pulsarfab/pulsarfab/README.md

# PulsarFab

Open-source astronomy hardware platform — dew heater controllers, power distribution and USB hubs, mount accessories, and other observatory gear based on STM32 and ESP32-S3 microcontrollers.

## Projects

| Project | Description | MCU | Flash/RAM | Framework | Status |
|---|---|-----|---|---|---|
| **pulsardew** | USB dew heater controller | STM32G0B1KBU6 | 128KB/144KB | STM32 HAL + FreeRTOS | 🚧 In Development |
| **[PulsarPower](hardware/pulsardewhub/README.md)** | Power distribution, two dew heaters and four-port USB 2.0 hub | STM32G0B1KBU6 | 128KB/144KB | Firmware adaptation pending | 🚧 Connected schematic / unrouted floorplan |
| **pulsardewpro** | WiFi dew heater controller (ASCOM Alpaca) | ESP32-S3-MINI-1 | 8MB/512KB | ESP-IDF | 🚧 In Development |
| **crunchdefender** | Skywatcher mount limit guard — inline USB host/device that interrupts motion before the OTA collides with the pier or cables crunch | STM32F405RGT6 | 1024KB/192KB | STM32 HAL | 🌱 Bootstrapped |

## Repository Structure

```
pulsarfab/
├── firmware/                 # All firmware projects (C/C++, Apache 2.0)
│   ├── pulsardew/             # STM32G0B1 USB dew heater controller
│   ├── pulsardewpro/          # ESP32-S3 WiFi dew heater (ASCOM Alpaca)
│   ├── crunchdefender/        # STM32F405 mount limit guard (dual-USB)
│   ├── common/                # Shared STM32 HAL and utilities
│   └── shared/                # Shared protocol definitions and libraries
├── hardware/                 # PCB designs (CERN-OHL-S v2 + NC)
│   ├── pulsardew/            # USB dew heater PCB
│   ├── pulsardewhub/         # PulsarPower power / dew / USB hub PCB
│   ├── pulsardewpro/         # WiFi dew heater PCB
│   ├── crunchdefender/       # Mount limit guard PCB
│   └── lib/                  # Shared KiCad libraries
├── mechanical/               # 3D models (coming soon, CERN-OHL-S v2 + NC)
└── LICENSE                   # Dual licensing information
```

## Quick Start

### Prerequisites

**For STM32 builds (pulsardew):**
- ARM GCC toolchain: `arm-none-eabi-gcc`
- CMake 3.20 or newer
- Make or Ninja build tool

**For ESP32-S3 builds (pulsardewpro):**
- ESP-IDF v5.x
- Python 3.10+
- uv (Python package manager)

See [firmware/README.md](firmware/README.md) for detailed installation instructions.

### Build Projects

```bash
# STM32 USB dew heater
cd firmware
make pulsardew-g0b1              # Build pulsardew (STM32G0B1)
make flash-pulsardew-g0b1        # Flash via st-flash

# STM32 mount limit guard
cd firmware
make crunchdefender-f405         # Build crunchdefender (STM32F405)
make flash-crunchdefender-f405   # Flash via st-flash

# ESP32-S3 WiFi dew heater
cd firmware/pulsardewpro
idf.py build                     # Build with ESP-IDF
idf.py flash                     # Flash via USB
```

## Key Features

### Dew Heater Control
- PWM-controlled heater outputs for telescope optics
- Temperature and humidity sensing (SHT40)
- Ambient dew point calculation with automatic heater regulation
- Configurable temperature setpoints per channel

### PulsarDew (USB)
- 4 PWM heater channels with current sensing
- Temperature/humidity sensor (SHT40 via I2C)
- USB 2.0 FS device (CDC for serial control from PC)
- Dew point calculation and automatic regulation
- Compact STM32G0B1 design with FreeRTOS

### PulsarDewPro (WiFi / ASCOM Alpaca)
- 4 PWM heater channels with individual current sensing
- Multiple temperature/humidity sensors
- WiFi 802.11 b/g/n connectivity
- ASCOM Alpaca REST API (ObservingConditions + Switch devices)
- Web configuration UI
- OTA firmware updates
- ESP32-S3 with ESP-IDF

### PulsarPower (Power / Dew / USB)
- Four independently switched, current-monitored DC outlets, **5 A service target each**
- Positive-side DC switching with grounded returns; static on/off, no PWM on DC outlets
- Two PWM dew heater channels
- Four external USB 2.0 ports, **500 mA per port**, plus an internal connection to the controller
- **12–18 V nominal input**, with alternative XT60 or barrel assembly options
- **25 A shared XT60 continuous target**; barrel option has a **3.5 A provisional continuous budget**
- **5 V / 3 A regulator** shared by USB and onboard electronics; not 3 A per USB port

PulsarDew remains the original dedicated dew controller. **PulsarPower** is the
expanded product, previously called **PulsarDew Hub** during development. Its
KiCad files and Makefile targets currently retain the `pulsardewhub` identifier.
The 0.3 draft has a connected schematic and an unrouted four-layer floorplan;
current ratings require routing and prototype qualification, and firmware
adaptation is pending. Cost reductions retain outlet current monitoring: TPS25974L
switches, one shared voltage window and two owned SiR680LDP input FETs. See the [PulsarPower design README](hardware/pulsardewhub/README.md)
for the power budget, schematic, floorplan and remaining release work.

PulsarPower and PulsarDew now share stocked XKB barrel sockets and HRO USB-C sockets;
SHT40 R2 is retained. The shared procurement CSV allocates 110 owned XKB sockets.
U30 now uses 22 allocated owned LMR51610s for the 20-board batch plus spares.
See the [LMR51610 implementation notes](hardware/pulsardewhub/docs/lmr51610-commonality.md)
for the 3.3 V / 650 mA logic stage; the 5 V / 3 A USB supply remains.

## Hardware

### PulsarDew (STM32G0B1KBU6)
- 128KB Flash, 144KB RAM
- ARM Cortex-M0+ @ 64MHz
- UFQFPN-32 package
- USB 2.0 FS (HSI48 + CRS, no external crystal)
- FreeRTOS real-time control

### PulsarDewPro (ESP32-S3-MINI-1)
- 8MB Flash, 512KB SRAM
- Dual-core Xtensa LX7 @ 240MHz
- WiFi 802.11 b/g/n
- USB-OTG for programming
- ASCOM Alpaca server

### CrunchDefender (STM32F405RGT6)
- 1024KB Flash, 192KB RAM (128KB SRAM + 64KB CCM)
- ARM Cortex-M4F @ 168MHz with single-precision FPU
- LQFP-64 package
- **Two USB peripherals running concurrently** — OTG_FS as device (PA11/PA12) to the host PC, OTG_HS-in-FS-mode as host (PB14/PB15) to the Skywatcher hand controller
- Sits inline on the USB link, parses position telemetry, intercepts motion commands when limits are exceeded

## License

This project uses dual licensing:

- **Firmware/Software**: [Apache 2.0](firmware/LICENSE)
- **Hardware Designs**: CERN-OHL-S v2 (strongly reciprocal) + Non-Commercial restriction

See [LICENSE](LICENSE) for details.

## Contributing

Contributions are welcome! Please ensure:
- Firmware contributions follow the Apache 2.0 license
- Hardware contributions follow CERN-OHL-S v2 + NC
- Code follows the existing style
- All changes are tested

## Resources

### Hardware
- [STM32G0 Series](https://www.st.com/en/microcontrollers-microprocessors/stm32g0-series.html)
- [ESP-IDF Documentation](https://docs.espressif.com/projects/esp-idf/)
- [ASCOM Alpaca](https://ascom-standards.org/Developer/Alpaca.htm)

### Licenses
- [Apache 2.0 License](https://www.apache.org/licenses/LICENSE-2.0)
- [CERN-OHL-S v2](https://ohwr.org/cern_ohl_s_v2.txt)

### Tools
- [uv Python Package Manager](https://github.com/astral-sh/uv)

---

Copyright (c) 2025-2026 Yann Ramin
