pulsarfab/pulsarfab/hardware/pulsardewhub/docs/pcb-placement.png

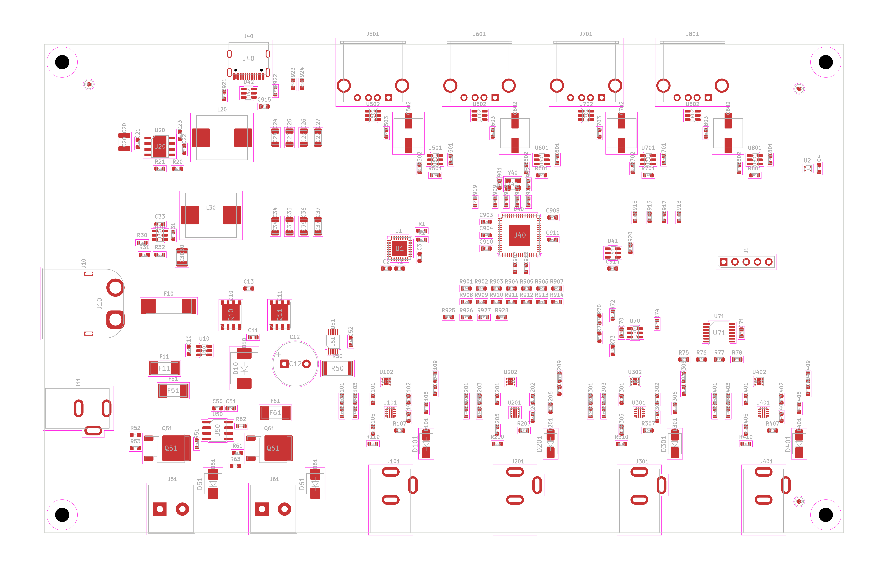
hardware/pulsardewhub/docs/pcb-placement.png
