pulsarfab/pulsarfab/hardware/pulsardewhub/docs/system-interconnect.png

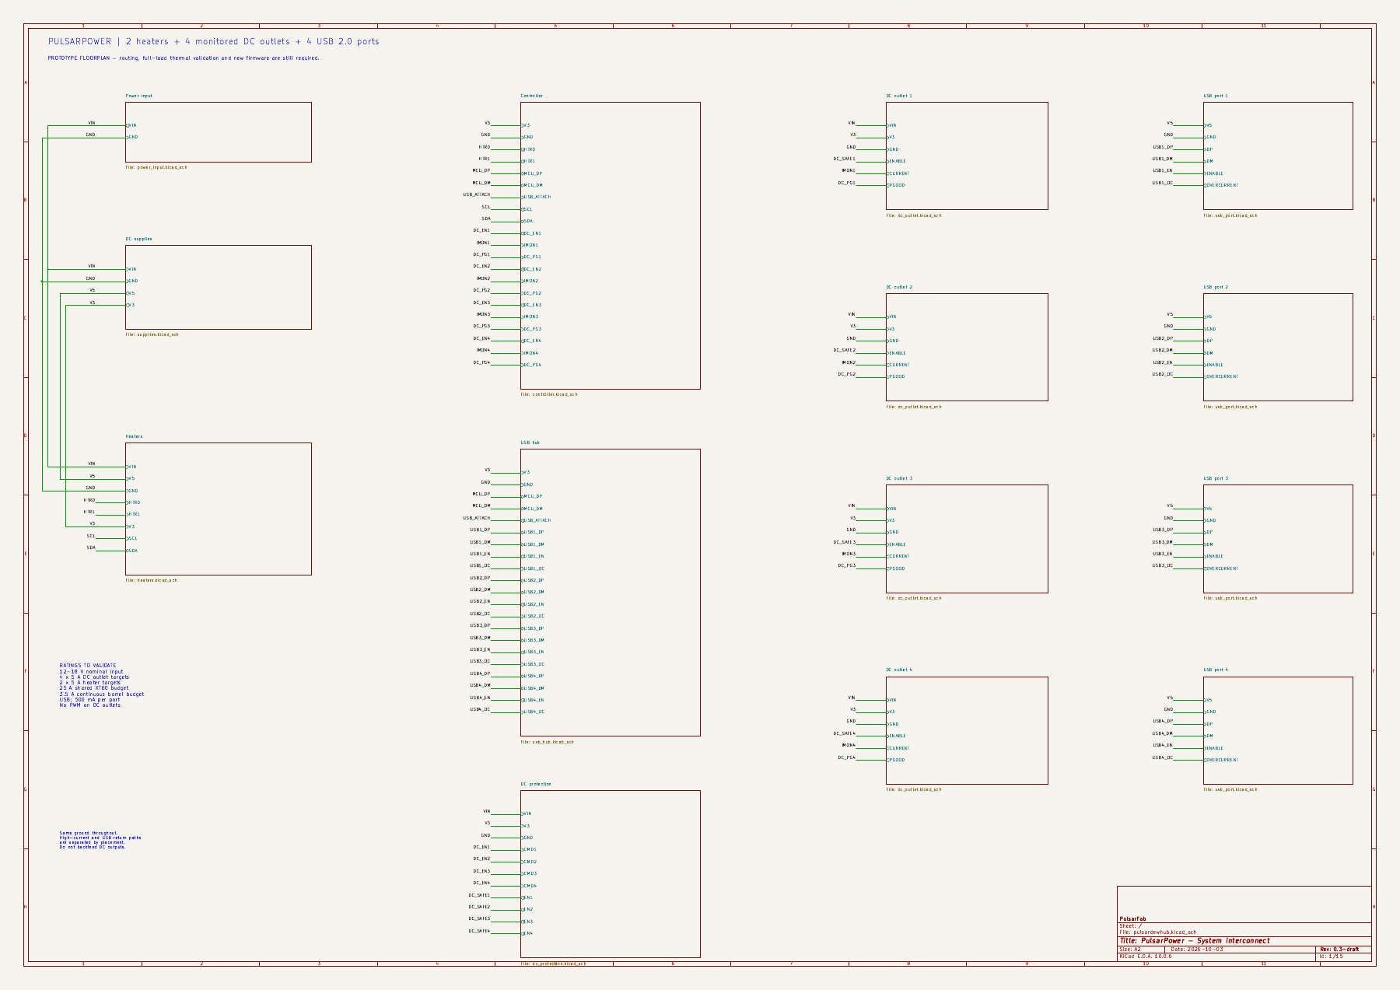
hardware/pulsardewhub/docs/system-interconnect.png
