pulsarfab/pulsarfab/hardware/pulsardewhub/jlcpcb_bom.csv

Item | Designator | Comment | Footprint | Qty | LCSC Part # | MPN | Manufacturer
1 | C1,C3,C4,C23,C33,C50,C52,C70,C71,C501,C503,C601,C603,C701,C703,C801,C803,C903-C909,C914,C915 | 100n | Capacitor_SMD:C_0603_1608Metric | 26 | C14663 | CC0603KRX7R9BB104 | YAGEO
2 | C2 | 4.7u / 16V | Capacitor_SMD:C_0603_1608Metric | 1 | C19666 | CL10A475KO8NNNC | Samsung Electro-Mechanics
3 | C10,C22,C51,C910-C913 | 1u / 50V | Capacitor_SMD:C_0603_1608Metric | 7 | C15849 | CL10A105KB8NNNC | Samsung Electro-Mechanics
4 | C11,C13,C31,C101,C102,C201,C202,C301,C302,C401,C402 | 100n / 50V | Capacitor_SMD:C_0603_1608Metric | 11 | C14663 | CC0603KRX7R9BB104 | YAGEO
5 | C12 | 470u / 35V | Capacitor_THT:CP_Radial_D10.0mm_P5.00mm | 1 | C106703 | ERS1VM471G16OT | AISHI
6 | C20,C30 | 10u / 50V | Capacitor_SMD:C_1210_3225Metric | 2 | C138687 | CL32B106KBJNNNE | Samsung Electro-Mechanics
7 | C21 | 220n / 50V | Capacitor_SMD:C_0603_1608Metric | 1 | C64705 | CL10B224KB8NNNC | Samsung Electro-Mechanics
8 | C24-C27,C34-C37 | 22u / 25V | Capacitor_SMD:C_1206_3216Metric | 8 | C12891 | CL31A226KAHNNNE | Samsung Electro-Mechanics
9 | C103,C203,C303,C403 | 4.7n / 50V | Capacitor_SMD:C_0603_1608Metric | 4 | C1621 | CL10B472KB8NNNC | Samsung Electro-Mechanics
10 | C104,C204,C304,C404 | 10n | Capacitor_SMD:C_0603_1608Metric | 4 | C1589 | CL10B103KB8NNNC | Samsung Electro-Mechanics
11 | C502,C602,C702,C802 | 150u / 10V / 20% | pulsarfab:CP_RVT_D6.3mm_L5.4mm | 4 | C970688 | RVT1A151M0605 150UF 10V | DMBJ
12 | C901,C902 | 18p / C0G | Capacitor_SMD:C_0603_1608Metric | 2 | C342890 | CGA3E2C0G1H180JT0Y0N | TDK
13 | D10 | SMCJ18A | Diode_SMD:D_SMC | 1 | C438102 | SMCJ18A | Jingdao Microelectronics
14 | D51,D61 | SMBJ20A | Diode_SMD:D_SMB | 2 | C364296 | SMBJ20A | MDD(Microdiode Semiconductor)
15 | D101,D201,D301,D401 | SS54 | Diode_SMD:D_SMA | 4 | C22452 | SS54 | MDD(Microdiode Semiconductor)
16 | F10 | 30A / upstream budget | pulsarfab:Fuse_S1032_10.3x3.2mm | 1 | C553917 | S1032-F-30.0A | SART
17 | F51,F61 | 7A heater fuse | Fuse:Fuse_Littelfuse-NANO2-451_453 | 2 | C99548 | 0451007.MRL | Littelfuse
18 | J1 | SWD | Connector_PinHeader_2.54mm:PinHeader_1x05_P2.54mm_Vertical | 1 | C492404 | PZ254V-11-05P | XFCN
19 | J10 | XT60: 2=PLUS, 1=GND | pulsarfab:AMASS_XT60PW-M_Edge | 1 | C98732 | XT60PW-M | Changzhou Amass Elec
20 | J40 | USB-C upstream | pulsarfab:USB_C_HRO_TYPE-C-31-M-12 | 1 | C165948 | TYPE-C-31-M-12 | Korean Hroparts Elec
21 | J51 | HEATER 1 | pulsarfab:TerminalBlock_KEFA_KF128_2P_P5.08mm | 1 | C474952 | KF128-5.08-2P-AA | Cixi Kefa Elec
22 | J61 | HEATER 2 | pulsarfab:TerminalBlock_KEFA_KF128_2P_P5.08mm | 1 | C474952 | KF128-5.08-2P-AA | Cixi Kefa Elec
23 | J101,J201,J301,J401 | 5A DC / center + | pulsarfab:BarrelJack_XKB_DC-005K-5A_Edge | 4 | C2880546 | DC-005K-5A-2.0 | XKB Connection
24 | J501,J601,J701,J801 | USB-A / 500mA | pulsarfab:USB_A_SHOUHAN_AF90ZJWG_THT | 4 | C456019 | AF 90 ZJWG | SHOU HAN
25 | L20 | 8.2u / 10A sat | pulsarfab:L_SXN_SMMS1050 | 1 | C149543 | SMMS1050-8R2M | Shun Xiang Nuo
26 | L30 | 6.8u / 12A sat | pulsarfab:L_SXN_SMMS1050 | 1 | C149542 | SMMS1050-6R8M | Shun Xiang Nuo
27 | Q10,Q11 | SiR680LDP | Package_SO:PowerPAK_SO-8_Single | 2 | C3279524 | SIR680LDP-T1-RE3 | Vishay
28 | Q51,Q61 | AOD4184A | Package_TO_SOT_SMD:TO-252-2 | 2 | C5370959 | AOD4184A | TECH PUBLIC
29 | R1,R2 | 4.7k | Resistor_SMD:R_0603_1608Metric | 2 | C23162 | 0603WAF4701T5E | UNI-ROYAL
30 | R20,R30,R53,R63,R101,R201,R301,R401,R502,R602,R702,R802,R923,R924 | 100k | Resistor_SMD:R_0603_1608Metric | 14 | C25803 | 0603WAF1003T5E | UNI-ROYAL
31 | R21 | 24.9k | Resistor_SMD:R_0603_1608Metric | 1 | C25962 | 0603WAF2492T5E | UNI-ROYAL
32 | R31,R102,R202,R302,R402 | 20k | Resistor_SMD:R_0603_1608Metric | 5 | C4184 | 0603WAF2002T5E | UNI-ROYAL
33 | R32 | 12k | Resistor_SMD:R_0603_1608Metric | 1 | C22790 | 0603WAF1202T5E | UNI-ROYAL
34 | R50 | 2m / 3W / 1% | Resistor_SMD:R_2512_6332Metric | 1 | C2994640 | HoLLR2512-3W-2mR-1% | Milliohm
35 | R51,R61,R71,R73-R78,R104-R106,R109,R204-R206,R209,R304-R306,R309,R404-R406,R409,R901-R918,R920,R925-R928 | 10k | Resistor_SMD:R_0603_1608Metric | 48 | C25804 | 0603WAF1002T5E | UNI-ROYAL
36 | R52,R62 | 47 | Resistor_SMD:R_0603_1608Metric | 2 | C23182 | 0603WAF470JT5E | UNI-ROYAL
37 | R70 | 220k | Resistor_SMD:R_0603_1608Metric | 1 | C22961 | 0603WAF2203T5E | UNI-ROYAL
38 | R72 | 470k | Resistor_SMD:R_0603_1608Metric | 1 | C23178 | 0603WAF4703T5E | UNI-ROYAL
39 | R103,R203,R303,R403 | 150k | Resistor_SMD:R_0603_1608Metric | 4 | C22807 | 0603WAF1503T5E | UNI-ROYAL
40 | R107,R207,R307,R407 | 1k / 1% | Resistor_SMD:R_0603_1608Metric | 4 | C21190 | 0603WAF1001T5E | UNI-ROYAL
41 | R110,R210,R310,R410 | 1k | Resistor_SMD:R_0603_1608Metric | 4 | C21190 | 0603WAF1001T5E | UNI-ROYAL
42 | R501,R601,R701,R801 | 43.2k / 1% | Resistor_SMD:R_0603_1608Metric | 4 | C23053 | 0603WAF4322T5E | UNI-ROYAL
43 | R919 | 12k / 1% | Resistor_SMD:R_0603_1608Metric | 1 | C22790 | 0603WAF1202T5E | UNI-ROYAL
44 | R921,R922 | 5.1k | Resistor_SMD:R_0603_1608Metric | 2 | C23186 | 0603WAF5101T5E | UNI-ROYAL
45 | U1 | STM32G0B1KBU6 | Package_DFN_QFN:UFQFPN-32-1EP_5x5mm_P0.5mm_EP3.5x3.5mm | 1 | C5159549 | STM32G0B1KBU6 | ST
46 | U2 | SHT40-AD1B-R2 | Sensor_Humidity:Sensirion_DFN-4_1.5x1.5mm_P0.8mm_SHT4x_NoCentralPad | 1 | C2909890 | SHT40-AD1B-R2 | Sensirion
47 | U10 | LM74700QDBV | Package_TO_SOT_SMD:SOT-23-6 | 1 | C2941042 | LM74700QDBVRQ1 | TI
48 | U20 | LMR33630ADDA | Package_SO:Texas_HSOP-8-1EP_3.9x4.9mm_P1.27mm | 1 | C841384 | LMR33630ADDAR | TI
49 | U30 | LMR51610XDBVR | Package_TO_SOT_SMD:SOT-23-6 | 1 | C20539658 | LMR51610XDBVR | Texas Instruments
50 | U40 | USB2517-JZX | Package_DFN_QFN:QFN-64-1EP_9x9mm_P0.5mm_EP4.7x4.7mm | 1 | C1521556 | USB2517-JZX | MICROCHIP
51 | U41 | TPS3808G33DBV | Package_TO_SOT_SMD:SOT-23-6 | 1 | C43698 | TPS3808G33DBVR | TI
52 | U42,U502,U602,U702,U802 | USBLC6-2SC6 | Package_TO_SOT_SMD:SOT-23-6 | 5 | C7519 | USBLC6-2SC6 | ST
53 | U50 | TC4427AVOA713 | Package_SO:SOIC-8_3.9x4.9mm_P1.27mm | 1 | C624944 | TC4427AVOA713 | MICROCHIP
54 | U51 | INA226 | Package_SO:TSSOP-10_3x3mm_P0.5mm | 1 | C49851 | INA226AIDGSR | Texas Instruments
55 | U70 | TPS3700DDC | Package_TO_SOT_SMD:SOT-23-6 | 1 | C33002 | TPS3700DDCR | TI
56 | U71 | SN74LVC08APW | Package_SO:TSSOP-14_4.4x5mm_P0.65mm | 1 | C465737 | SN74LVC08APWR | Texas Instruments
57 | U101,U201,U301,U401 | TPS25974LRPW | pulsarfab:TI_RPW0010A_VQFN10_2x2mm | 4 | C3662931 | TPS25974LRPWR | Texas Instruments
58 | U102,U202,U302,U402 | TVS1800DRV | Package_SON:WSON-6-1EP_2x2mm_P0.65mm_EP1x1.6mm | 4 | C2649846 | TVS1800DRVR | Texas Instruments
59 | U501,U601,U701,U801 | TPS2553DBV | Package_TO_SOT_SMD:SOT-23-6 | 4 | C55266 | TPS2553DBVR | TI
60 | Y40 | 24MHz / CL=12pF | Crystal:Crystal_SMD_3225-4Pin_3.2x2.5mm | 1 | C5181479 | 3225 24M 12PF 10PPM | SOSET
