pulsarfab/pulsarfab/hardware/pulsardewhub/docs/schematic.pdf

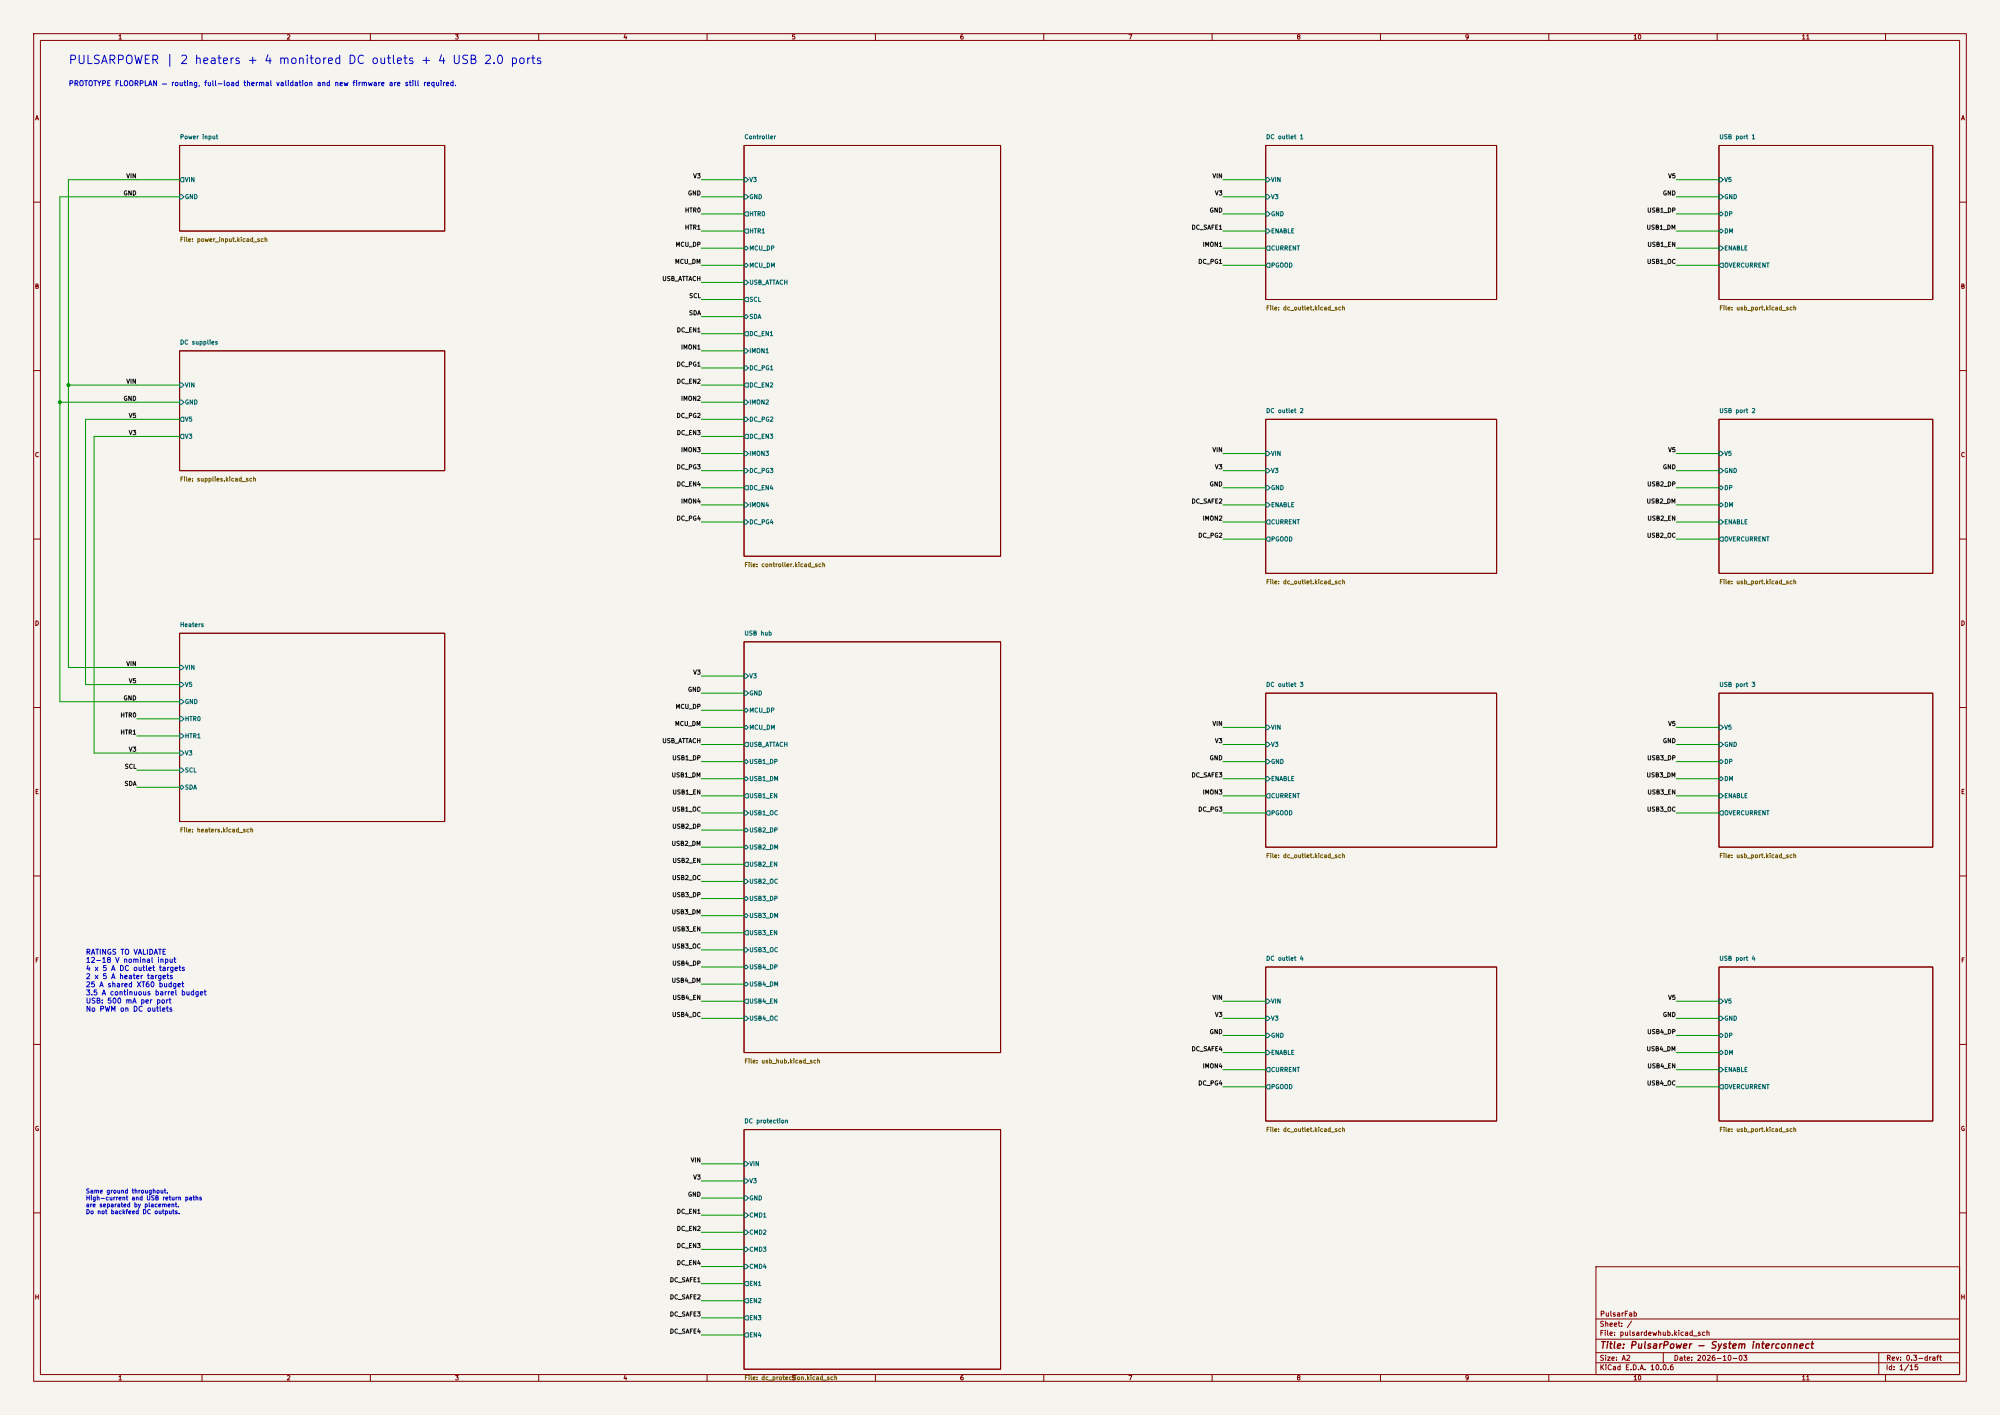
[picture p4: page 1]

PULSARPOWER | 2 heaters + 4 monitored DC outlets + 4 USB 2.0 ports

PROTOTYPE FLOORPLAN — routing, full-load thermal validation and new firmware are still required.

ENABLE OVERCURRENT USB port 1

V3 DC supplies File: supplies.kicad_sch

ENABLE OVERCURRENT USB port 2

SCL SDA Heaters File: heaters.kicad_sch
GND RATINGS TO VALIDATE

ENABLE OVERCURRENT USB port 3

12-18 V nominal input
4 x 5 A DC outlet targets
2 x 5 A heater targets
25 A shared XT60 budget
3.5 A continuous barrel budget
USB: 500 mA per port
No PWM on DC outlets

ENABLE OVERCURRENT USB port 4

Same ground throughout.
High-current and USB return paths are separated by placement. Do not backfeed DC outputs.

PulsarFab
Sheet: /
File: pulsardewhub.kicad_sch
Title: PulsarPower - System interconnect

Size: A2 | Rev: 0.3-draft
KiCad E.D.A. 10.0.6 | Id: 1/15

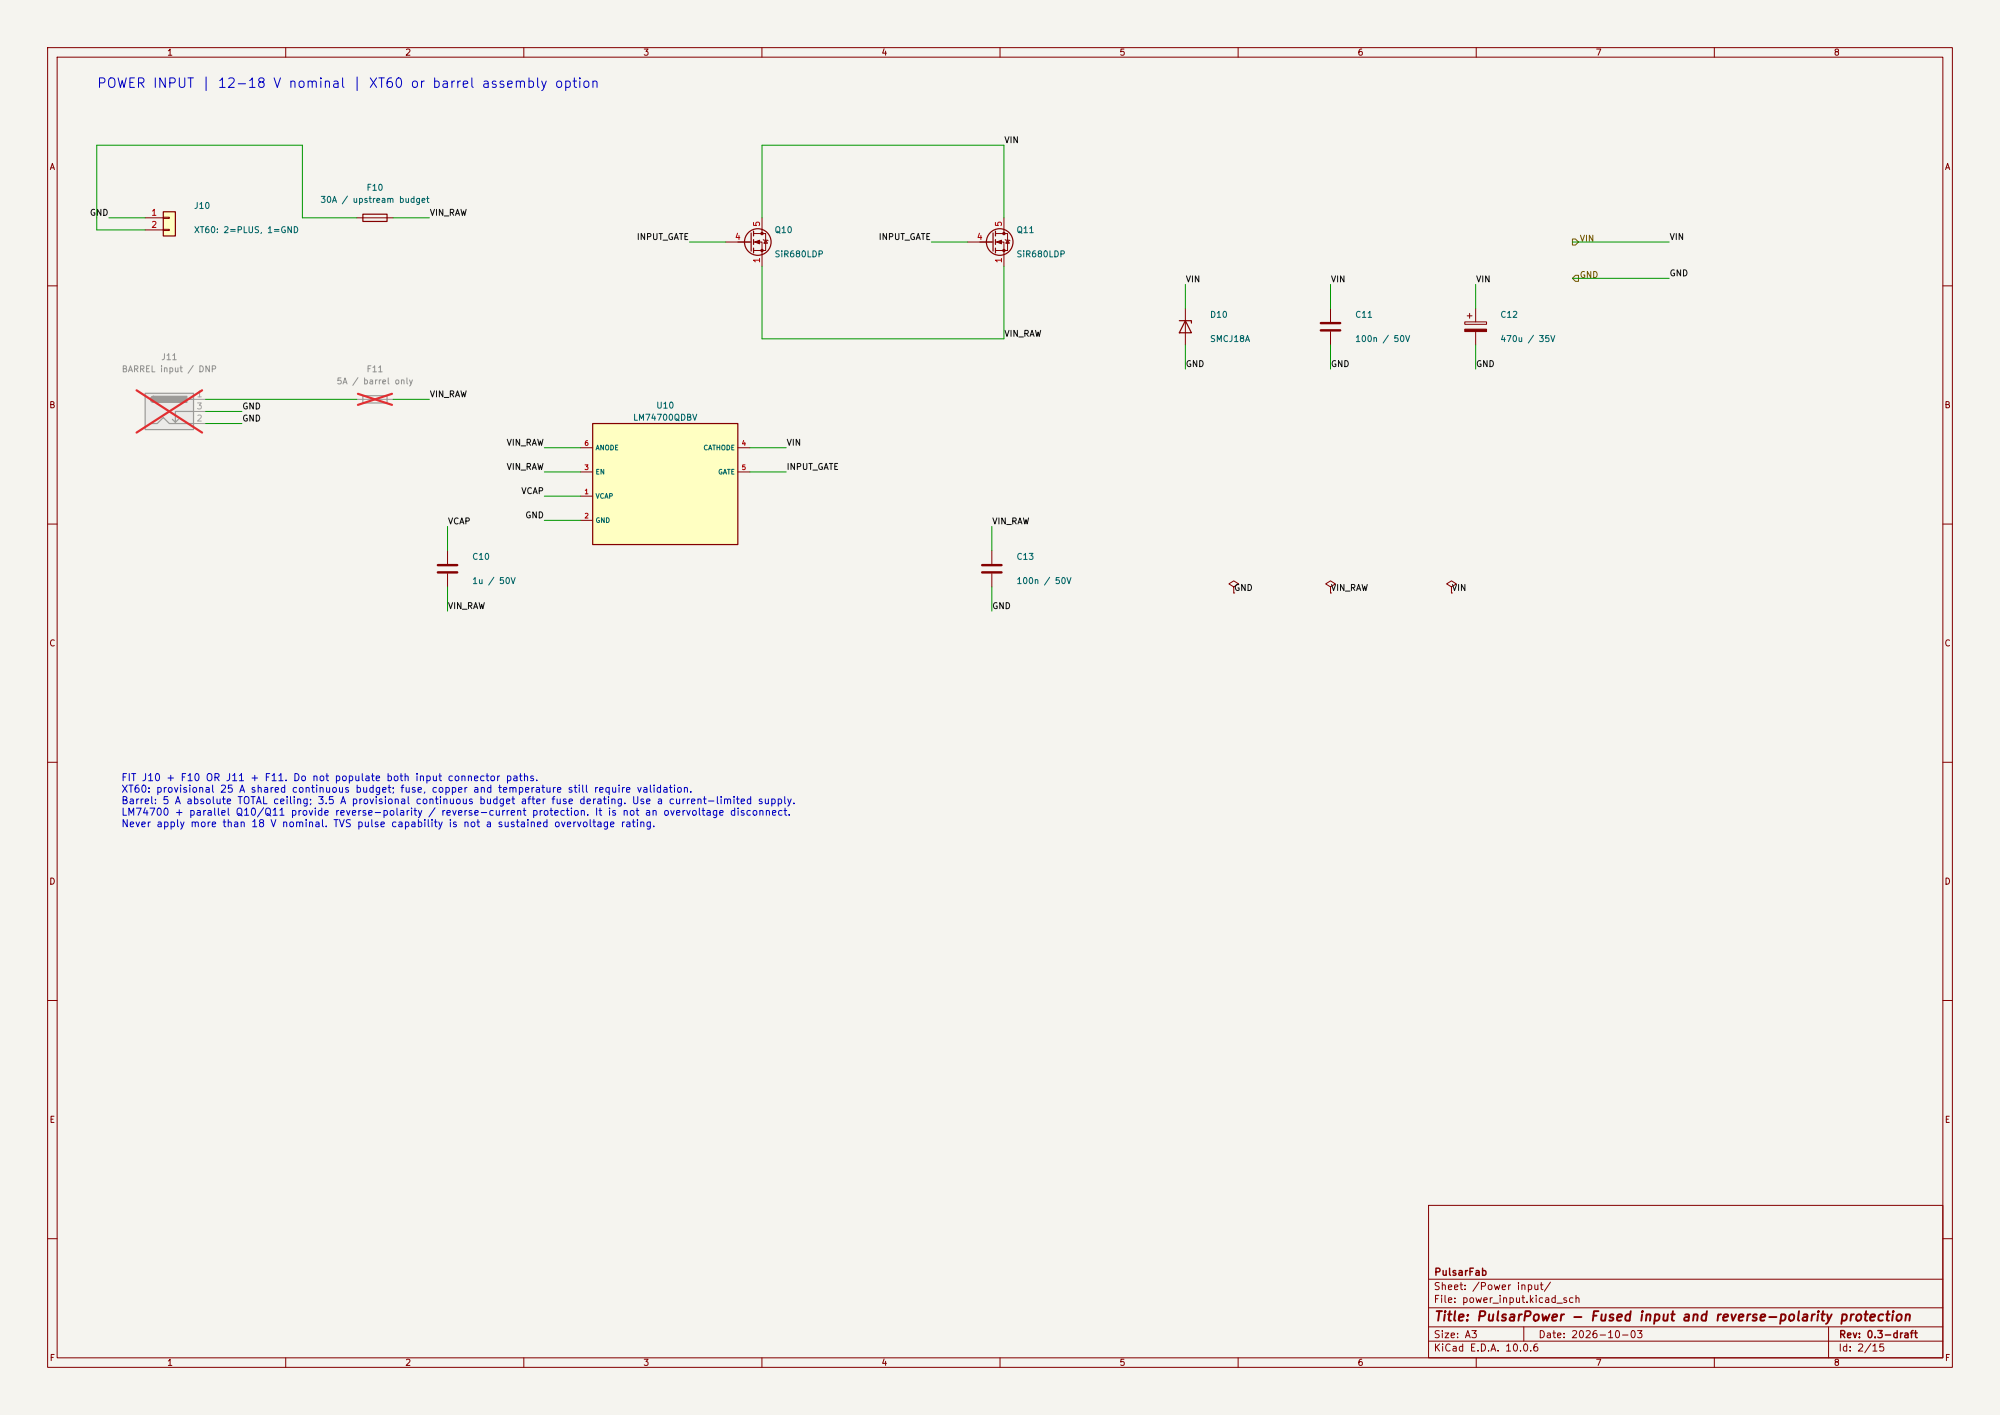
[picture p5: page 2]

POWER INPUT | 12-18 V nominal | XT60 or barrel assembly option

FIT J10 + F10 OR J11 + F11. Do not populate both input connector paths.
XT60: provisional 25 A shared continuous budget; fuse, copper and temperature still require validation.
Barrel: 5 A absolute TOTAL ceiling; 3.5 A provisional continuous budget after fuse derating. Use a current-limited supply.
LM74700 + parallel Q10/Q11 provide reverse-polarity / reverse-current protection. It is not an overvoltage disconnect.
Never apply more than 18 V nominal. TVS pulse capability is not a sustained overvoltage rating.

PulsarFab
Sheet: /Power input/
File: power_input.kicad_sch
Title: PulsarPower - Fused input and reverse-polarity protection

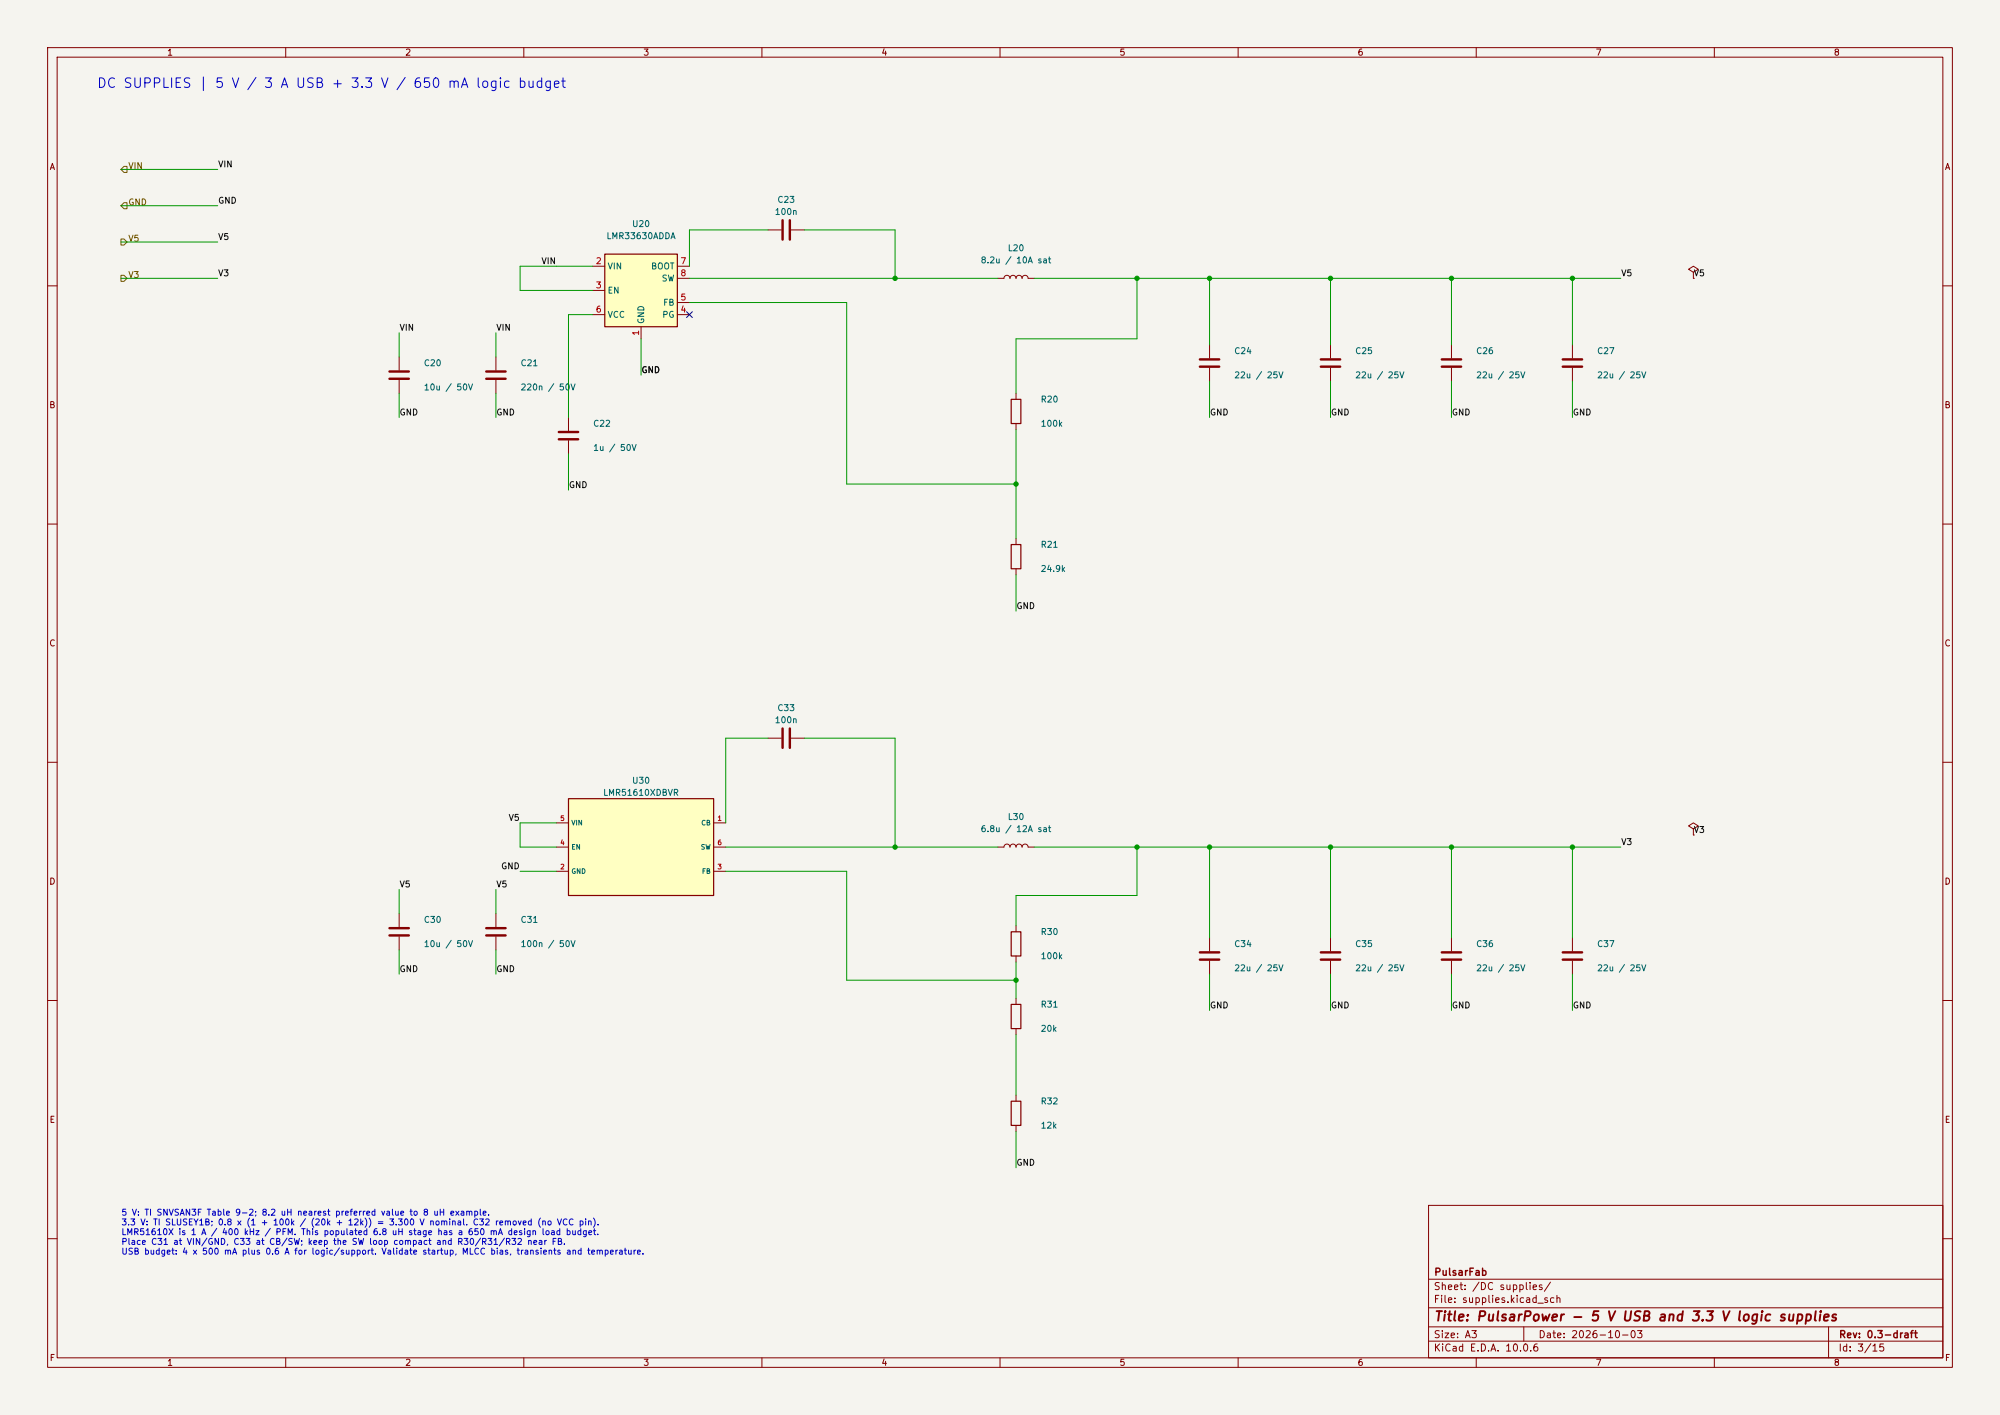
[picture p6: page 3]

DC SUPPLIES | 5 V / 3 A USB + 3.3 V / 650 mA logic budget

5 V: TI SNVSAN3F Table 9-2; 8.2 uH nearest preferred value to 8 uH example. 3.3 V: TI SLUSEY1B; 0.8 x (1 + 100k / (20k + 12k)) = 3.300 V nominal. C32 removed (no VCC pin). LMR51610X is 1 A / 400 kHz / PFM. This populated 6.8 uH stage has a 650 mA design load budget. Place C31 at VIN/GND, C33 at CB/SW; keep the SW loop compact and R30/R31/R32 near FB. USB budget: 4 x 500 mA plus 0.6 A for logic/support. Validate startup, MLCC bias, transients and temperature.

PulsarFab
Sheet: /DC supplies/
File: supplies.kicad_sch
Title: PulsarPower - 5 V USB and 3.3 V logic supplies

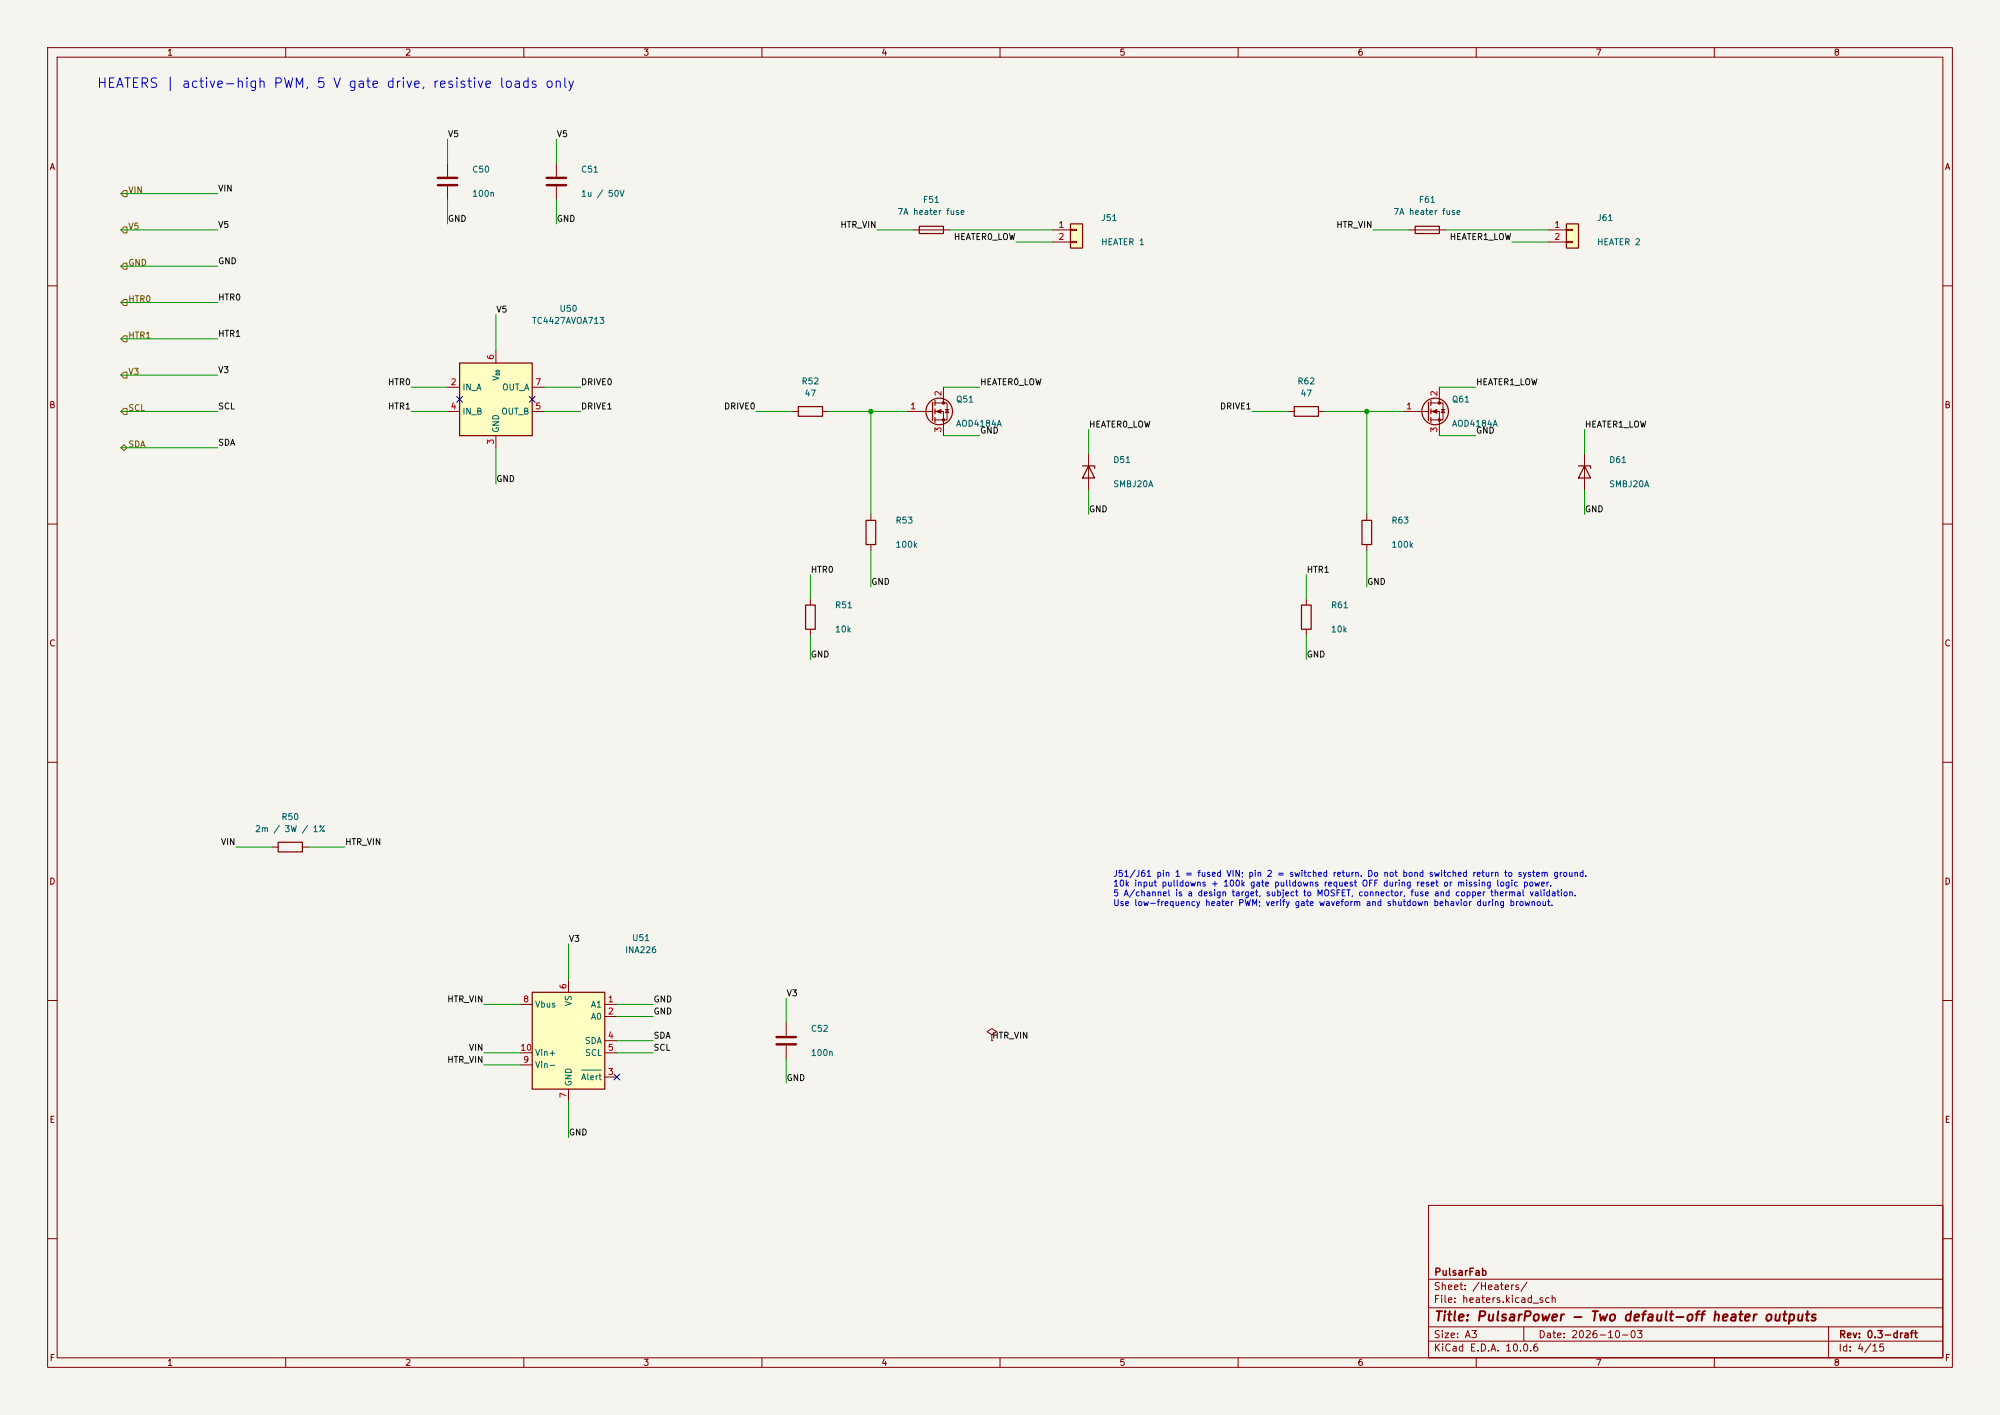
[picture p7: page 4]

HEATERS | active-high PWM, 5 V gate drive, resistive loads only

J51/J61 pin 1 = fused VIN; pin 2 = switched return. Do not bond switched return to system ground. 10k input pulldowns + 100k gate pulldowns request OFF during reset or missing logic power. 5 A/channel is a design target, subject to MOSFET, connector, fuse and copper thermal validation. Use low-frequency heater PWM; verify gate waveform and shutdown behavior during brownout.

PulsarFab
Sheet: /Heaters/
File: heaters.kicad_sch
Title: PulsarPower - Two default-off heater outputs

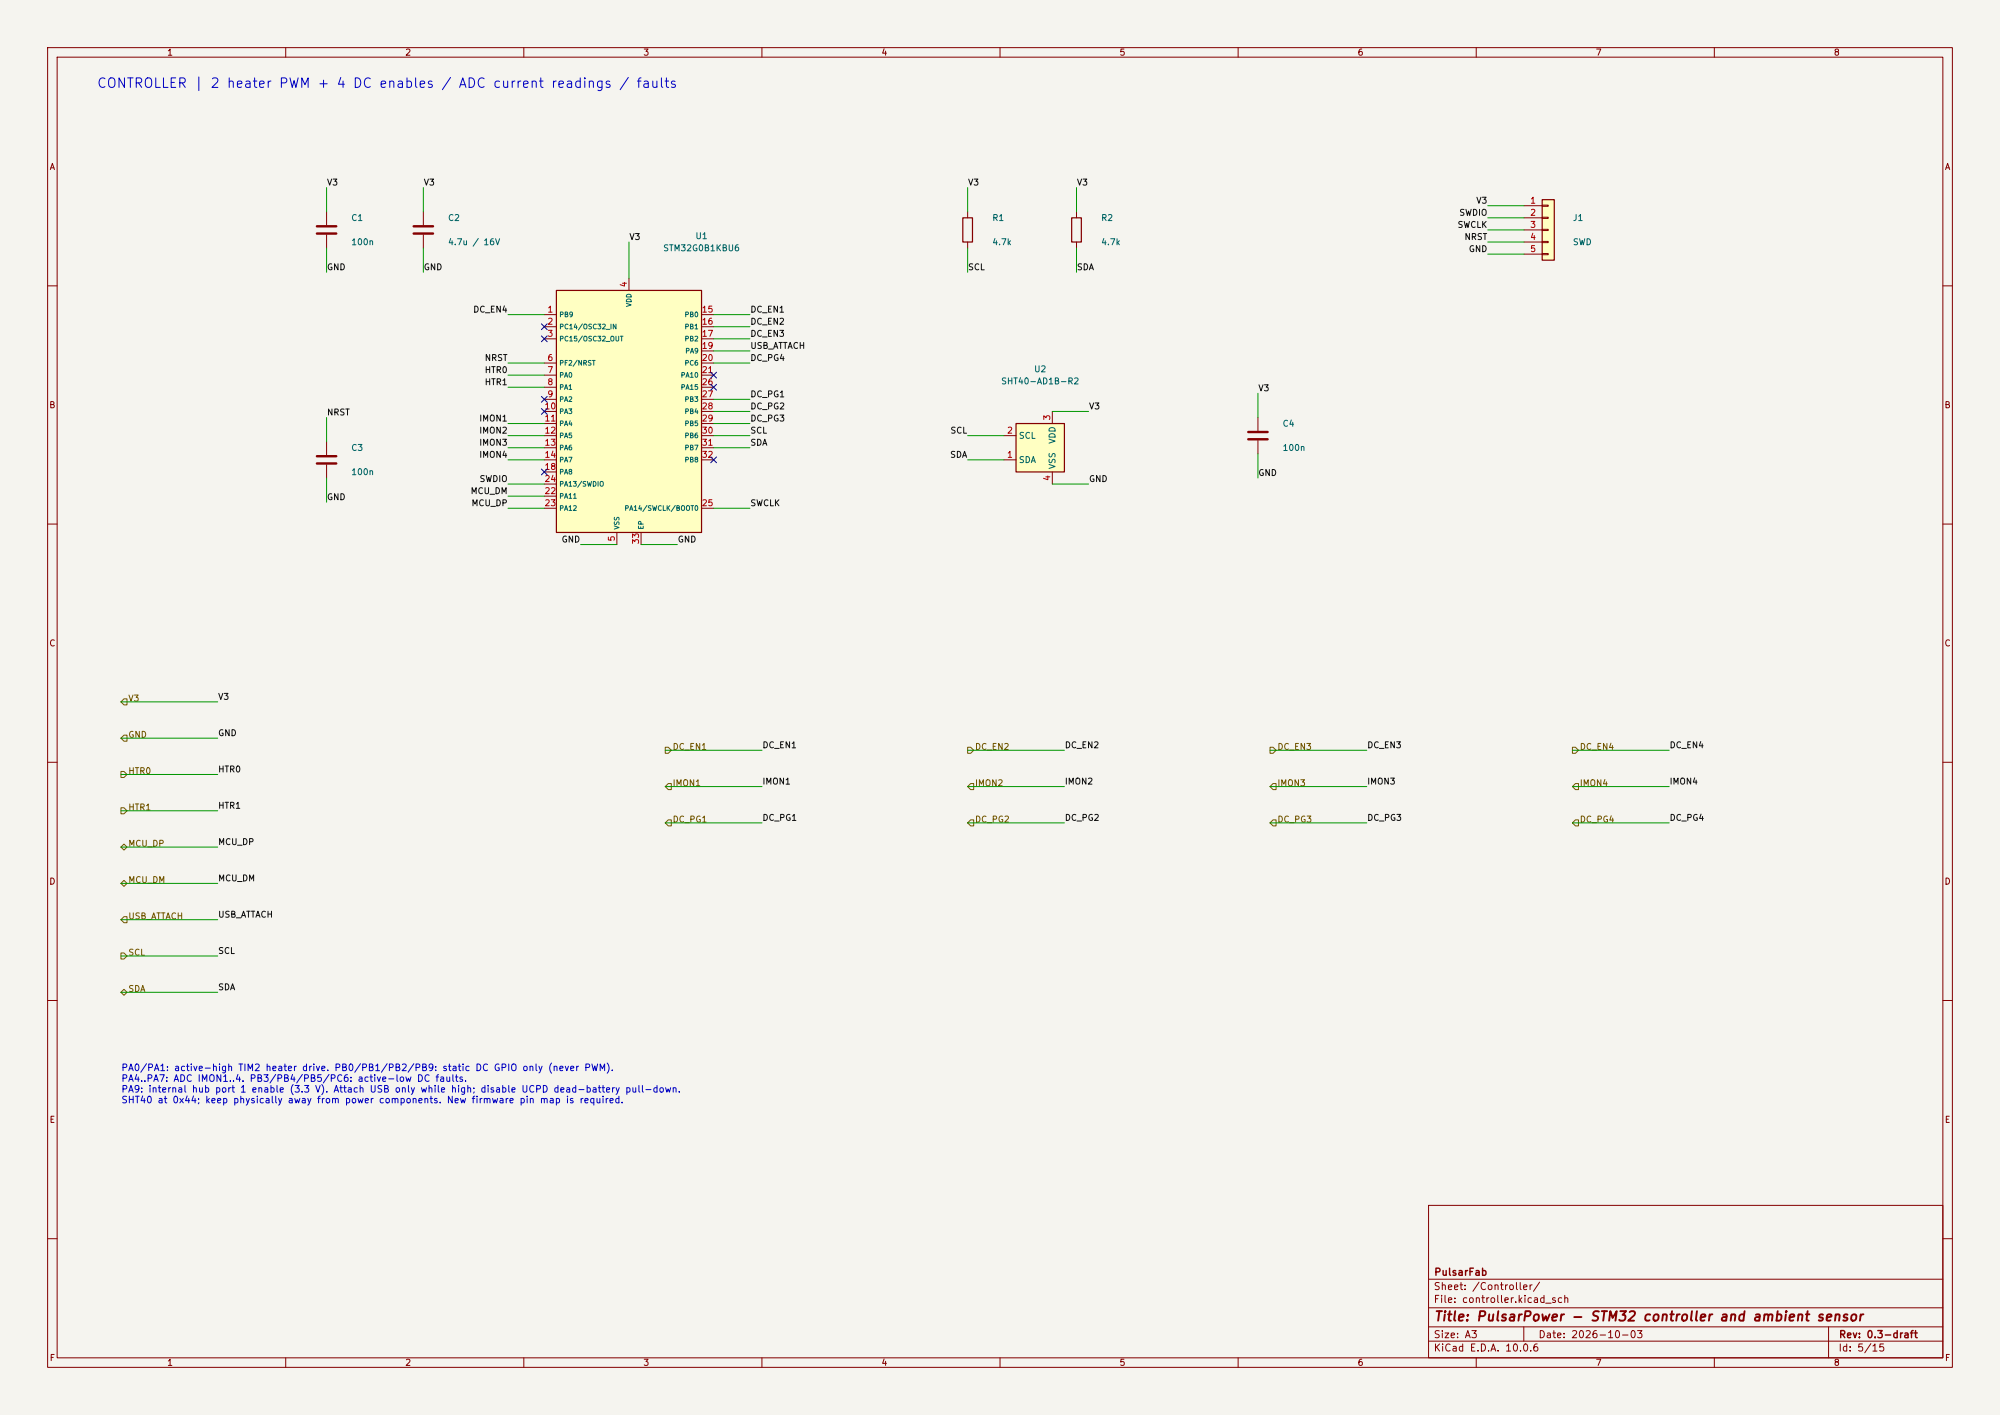
[picture p8: page 5]

CONTROLLER | 2 heater PWM + 4 DC enables / ADC current readings / faults

PA4..PA7: ADC IMON1..4. PB3/PB4/PB5/PC6: active-low DC faults. PA9: internal hub port 1 enable (3.3 V). Attach USB only while high; disable UCPD dead-battery pull-down.

SHT40 at 0x44; keep physically away from power components. New firmware pin map is required.

PulsarFab
Sheet: /Controller/
File: controller.kicad_sch
Title: PulsarPower - STM32 controller and ambient sensor

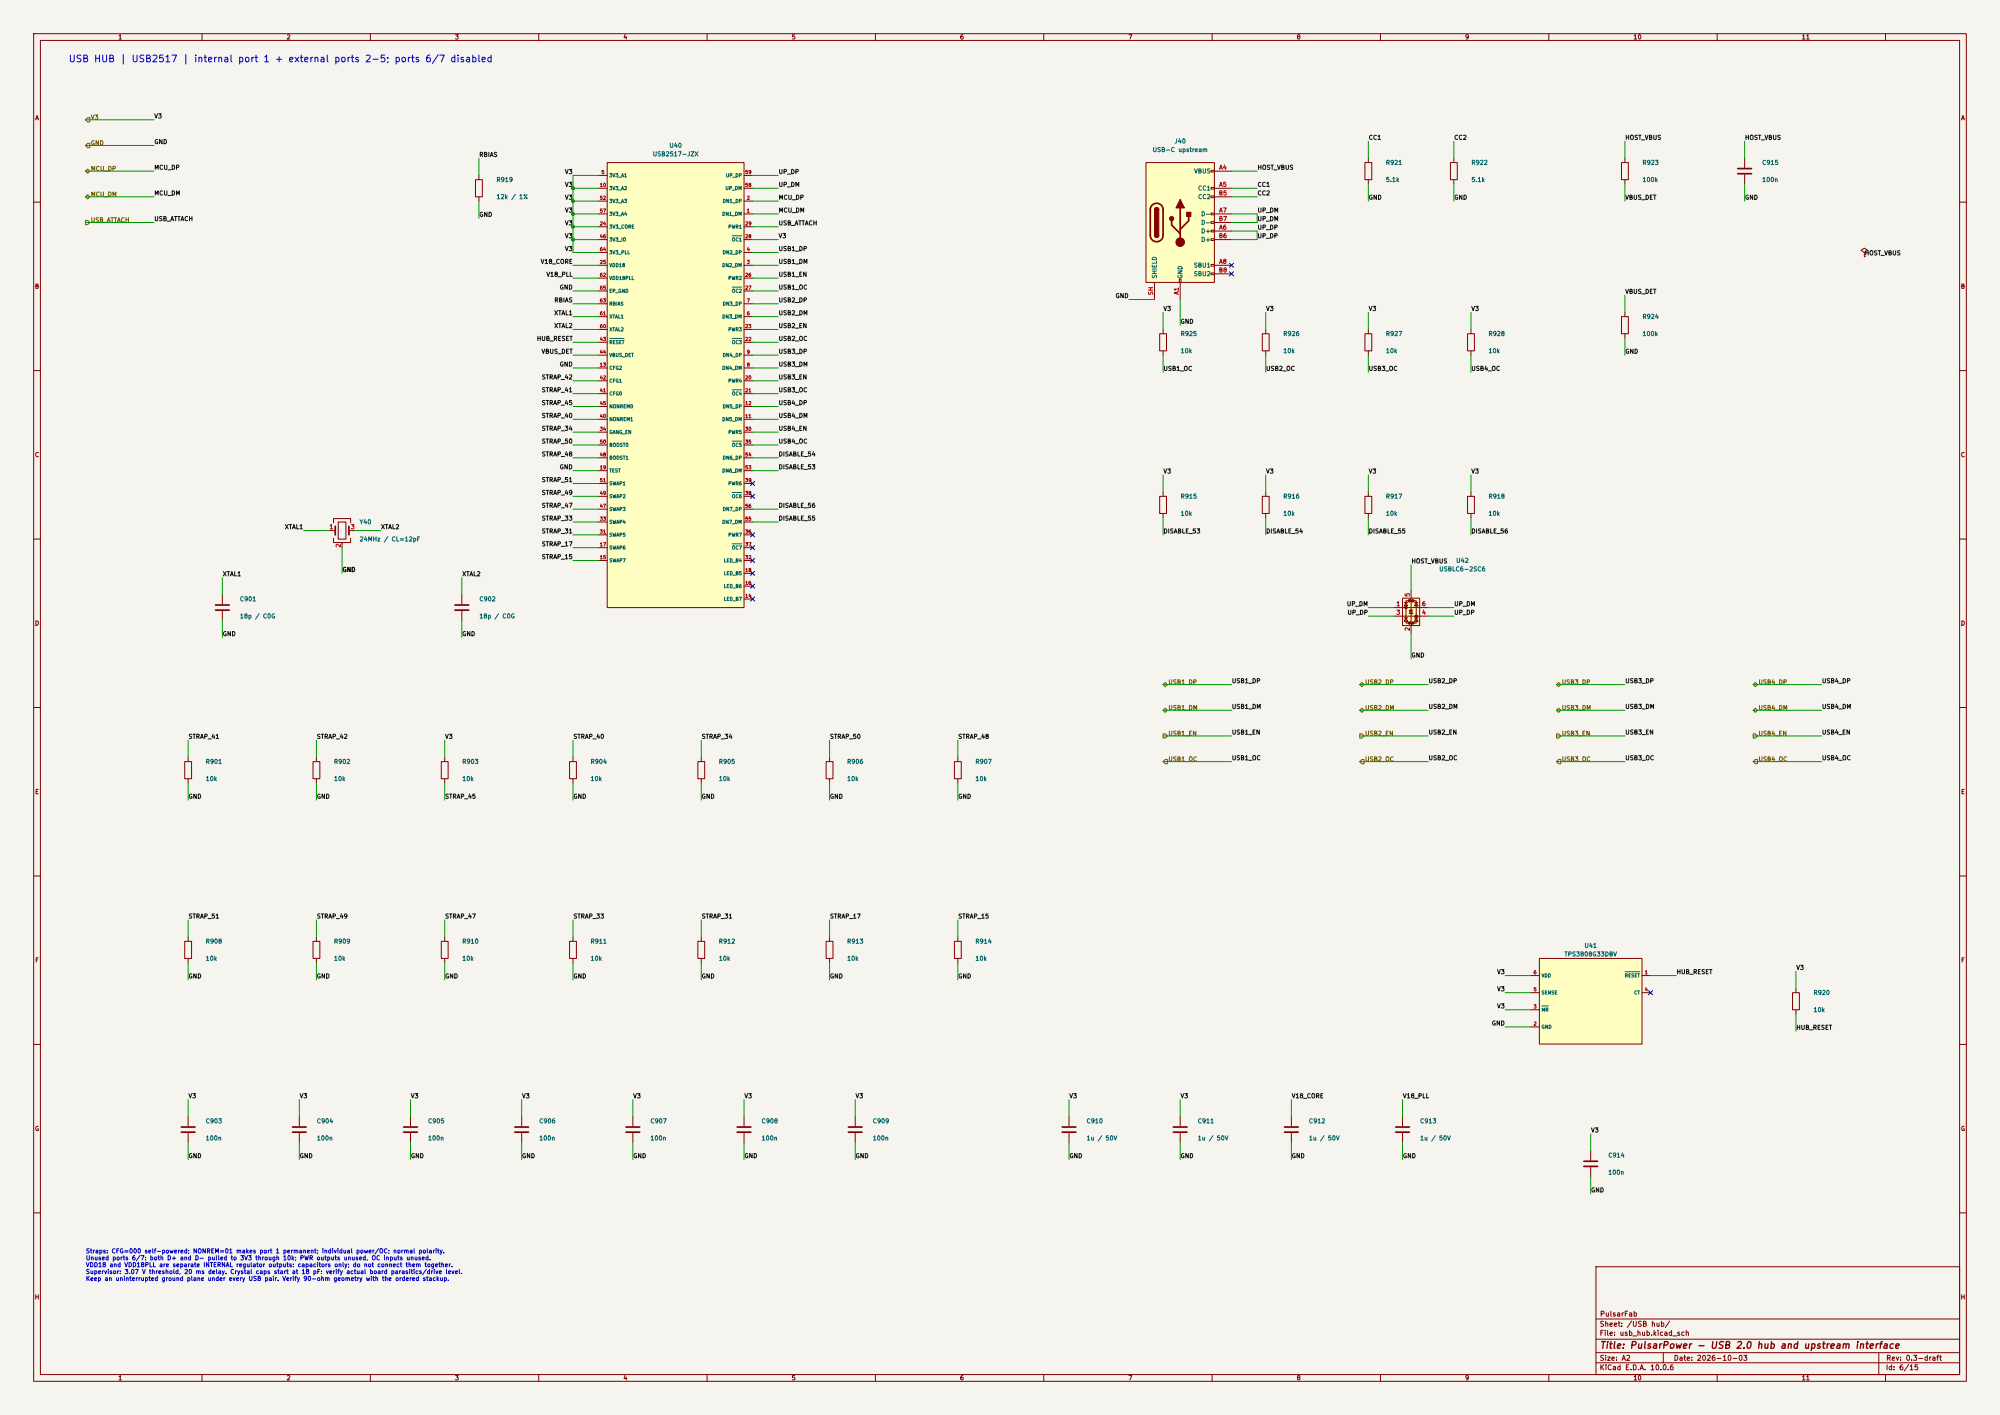
[picture p9: page 6]

USB HUB | USB2517 | internal port 1 + external ports 2-5; ports 6/7 disabled

Straps: CFG=000 self-powered; NONREM=01 makes port 1 permanent; individual power/OC; normal polarity. Unused ports 6/7: both D+ and D- pulled to 3V3 through 10k; PWR outputs unused, OC inputs unused. VDD18 and VDD18PLL are separate INTERNAL regulator outputs: capacitors only; do not connect them together.

Supervisor: 3.07 V threshold, 20 ms delay. Crystal caps start at 18 pF: verify actual board parasitics/drive level. Keep an uninterrupted ground plane under every USB pair. Verify 90-ohm geometry with the ordered stackup.

PulsarFab
Sheet: /USB hub/
File: usb_hub.kicad_sch
Title: PulsarPower - USB 2.0 hub and upstream interface

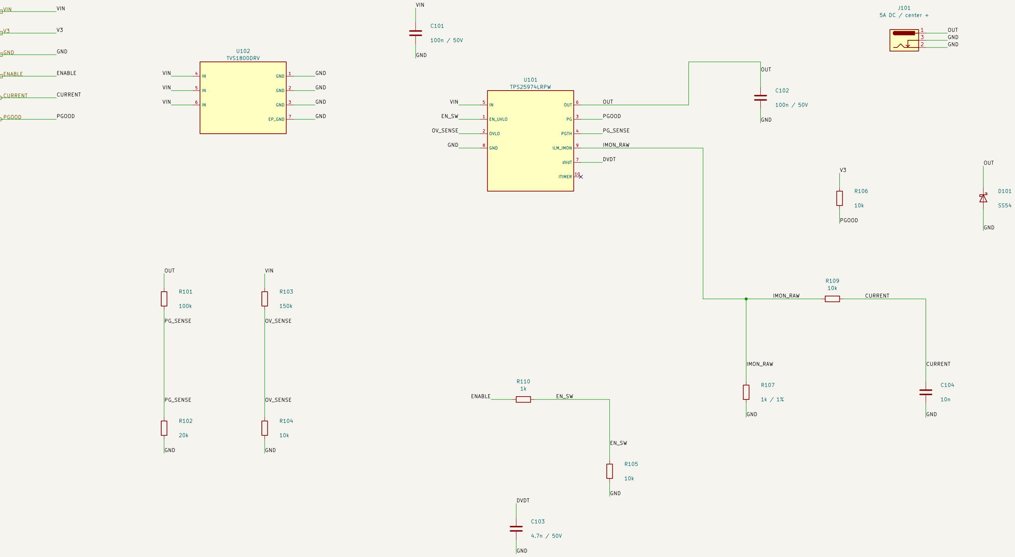
[picture p10: figure]
GND; 1 GND; 2 GND; EP_GND; TVS1800DRV; J101 5A DC / center +; EN_UVLO 1; OVLO 2; 3 PGTH; OUT; dVdT; 7 GND 8; ILM_IMON; ITIMER; TPS25974LRPW; VIN; V3GND; ENABLE PGOOD; CURRENT; CURRENT PGOOD; GND OUT GND; ENABLE; IMON_RAW; DVDT GND; CURRENT CURRENT PGOOD; V3 PG_SENSE PG_SENSE; OV_SENSE; OUT GND; DVDT; PG_SENSE PGOOD OUT

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
## Title: PulsarPower - 5 A switched DC outlet

File: dc_outlet.kicad_sch

Sheet: /DC outlet 1/

PulsarFab

TPS25974L: 1k sets 5.75 A nominal breaker threshold for 5 A service. ITIMER open; latch-off.
ILM is BOTH current setting and monitoring: 105.5 uA/A x 1k = 0.1055 V/A; 0.528 V at 5 A. 10k/10n filter isolates ADC capacitance from ILM. Calibrate channels; do not attach a capacitor directly to ILM.

Independent local OVLO: 150k/10k -> 19.2 V nominal. PG threshold: 100k/20k -> 7.2 V nominal. Positive line switched; ground permanently connected. No reverse blocking: do not backfeed outputs.

IN pad5 / OUT pad6 are power/thermal rails, NOT GND. Reserve copper and thermal-via space. TVS1800 flat clamp replaces SMBJ18A: 24.7 V max at specified 35 A / 8-20 us / 125 C pulse; verify loop overshoot.

## SWITCHED DC OUTLET | 12-18 V / 5 A service | hardware voltage inhibit / latched breaker

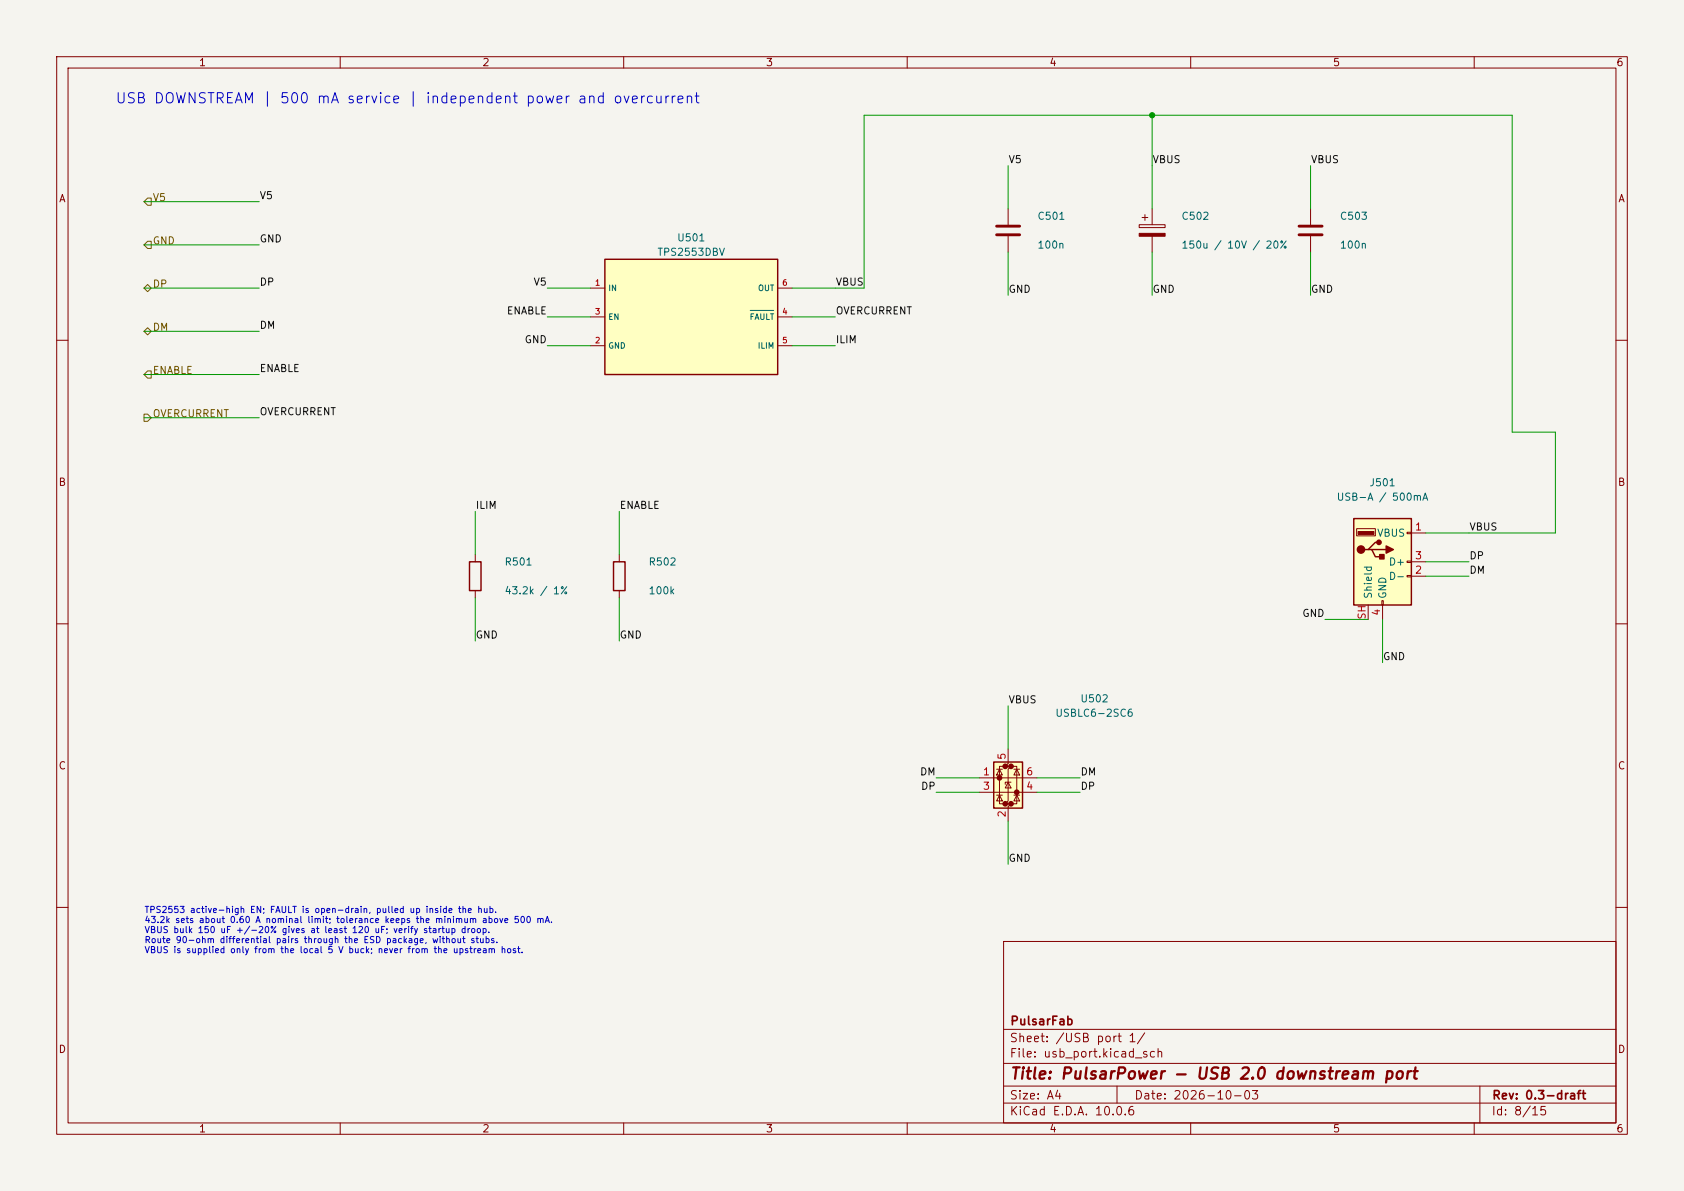
[picture p11: page 8]

ENABLE USB DOWNSTREAM | 500 mA service | independent power and overcurrent

TPS2553 active-high EN; FAULT is open-drain, pulled up inside the hub. 43.2k sets about 0.60 A nominal limit; tolerance keeps the minimum above 500 mA. VBUS bulk 150 uF +/-20% gives at least 120 uF; verify startup droop. Route 90-ohm differential pairs through the ESD package, without stubs. VBUS is supplied only from the local 5 V buck; never from the upstream host.

PulsarFab
Sheet: /USB port 1/
File: usb_port.kicad_sch
Title: PulsarPower - USB 2.0 downstream port

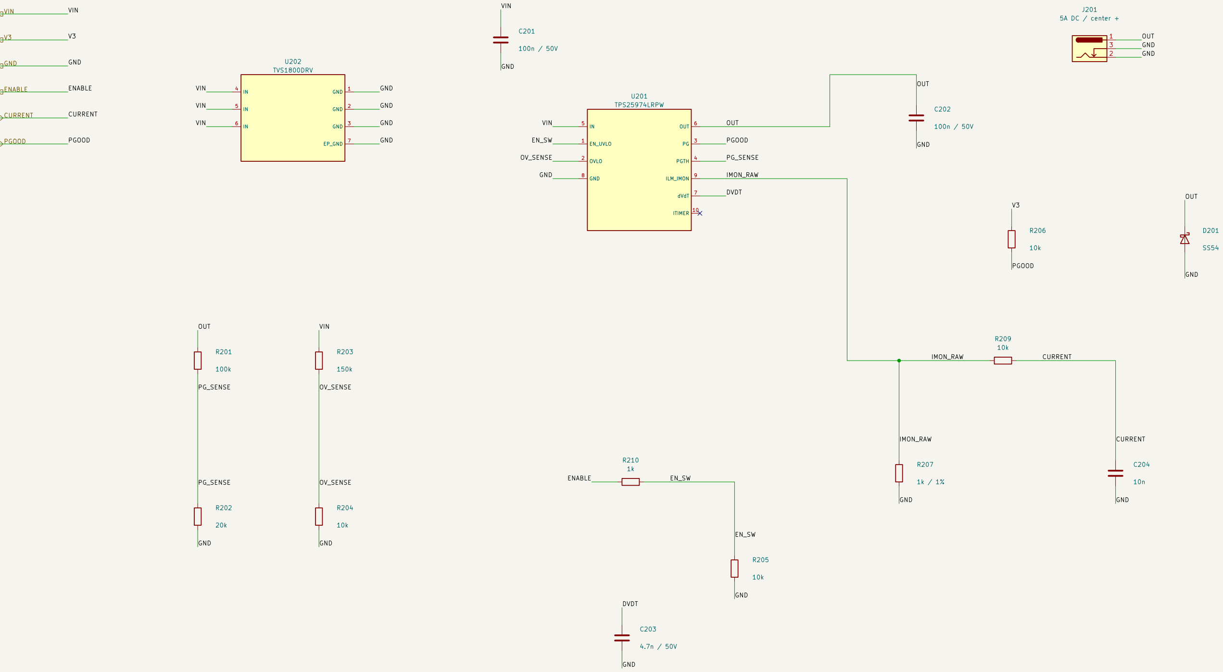
[picture p12: figure]
GND; 1 GND; 2 GND; EP_GND; TVS1800DRV; J201 5A DC / center +; EN_UVLO 1; OVLO 2; 3 PGTH; OUT; dVdT; 7 GND 8; ILM_IMON; ITIMER; TPS25974LRPW; VIN; V3GND; ENABLE PGOOD; CURRENT; CURRENT PGOOD; GND OUT GND; ENABLE; IMON_RAW; DVDT GND; CURRENT CURRENT PGOOD; V3 PG_SENSE PG_SENSE; OV_SENSE; OUT GND; DVDT; PG_SENSE PGOOD OUT

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
## Title: PulsarPower - 5 A switched DC outlet

File: dc_outlet.kicad_sch

Sheet: /DC outlet 2/

PulsarFab

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

## SWITCHED DC OUTLET | 12-18 V / 5 A service | hardware voltage inhibit / latched breaker

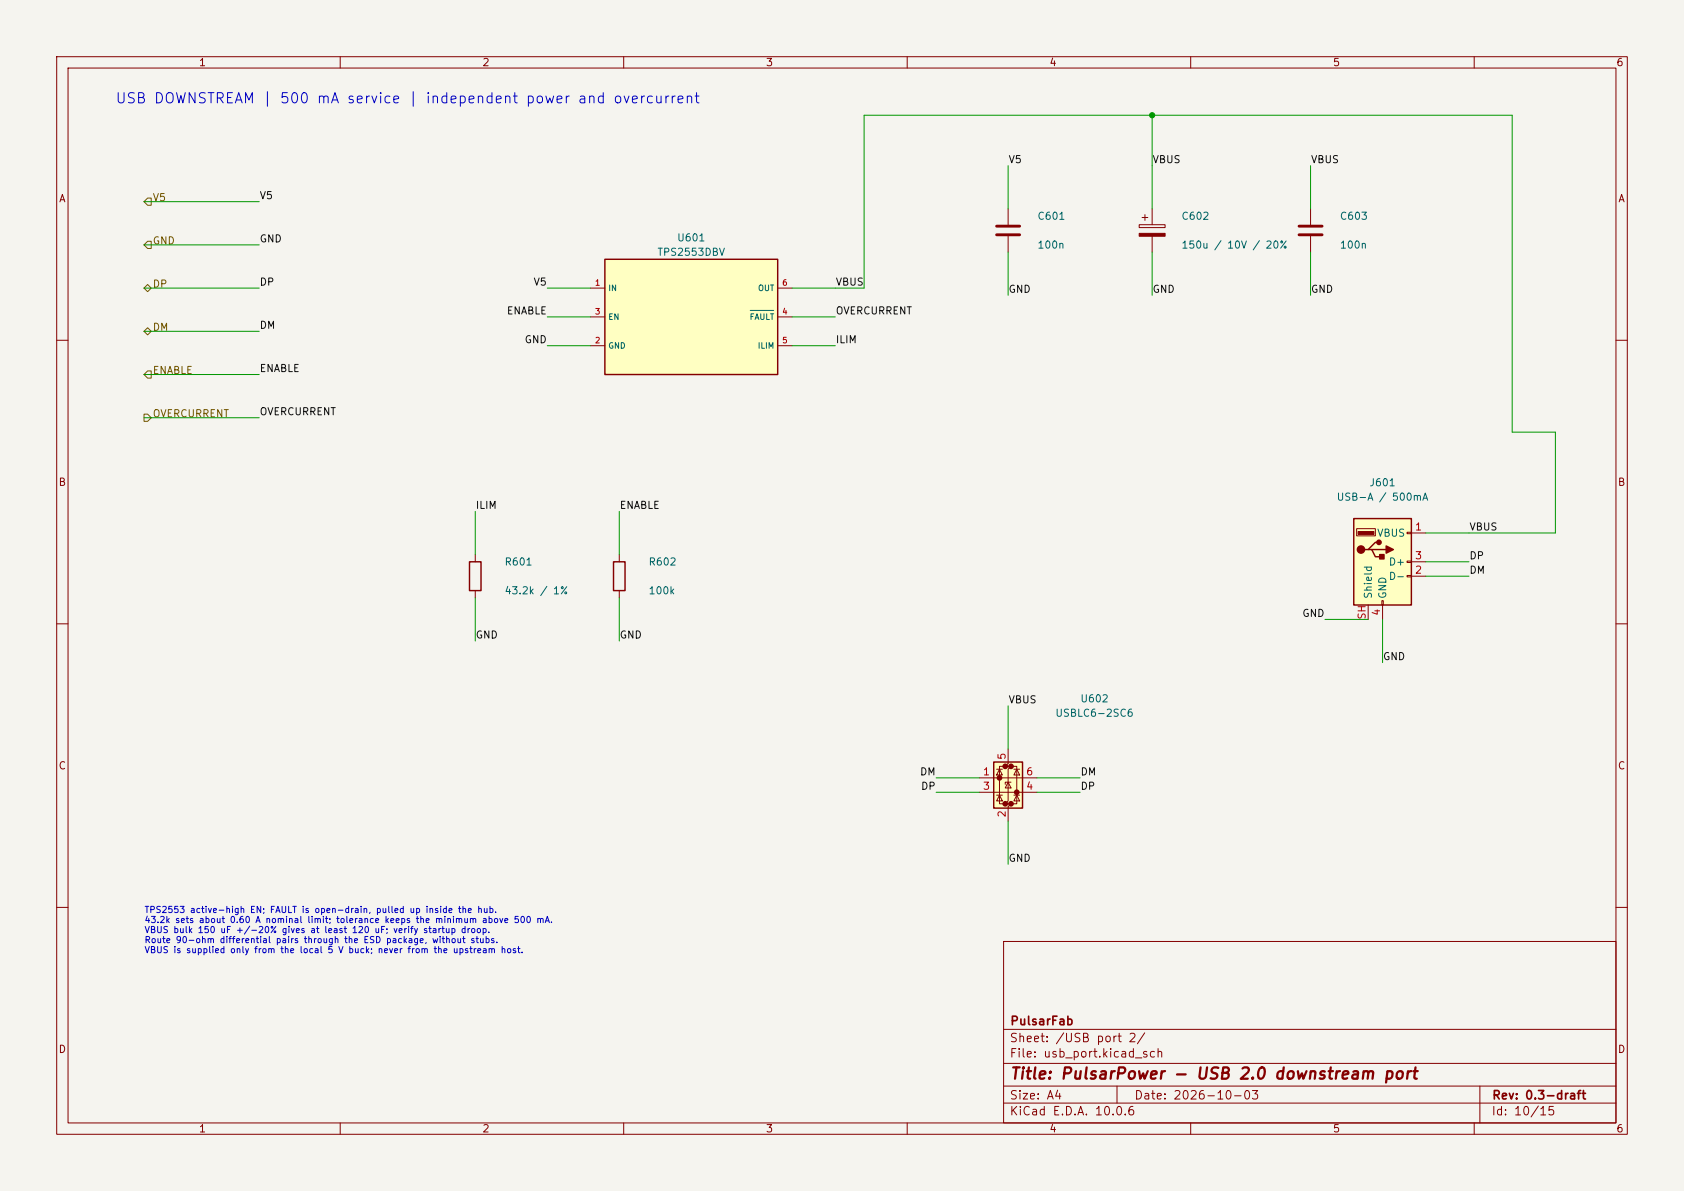
[picture p13: page 10]

ENABLE USB DOWNSTREAM | 500 mA service | independent power and overcurrent

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

PulsarFab
Sheet: /USB port 2/
File: usb_port.kicad_sch
Title: PulsarPower - USB 2.0 downstream port

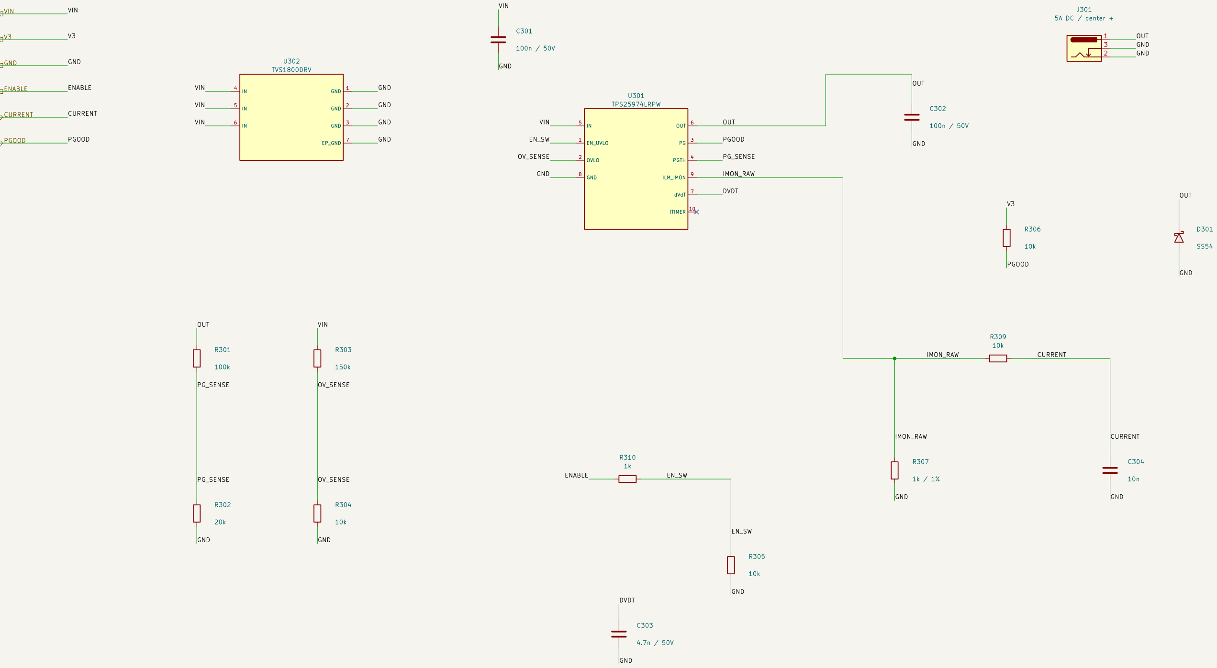
[picture p14: figure]
GND; 1 GND; 2 GND; EP_GND; TVS1800DRV; J301 5A DC / center +; EN_UVLO 1; OVLO 2; 3 PGTH; OUT; dVdT; 7 GND 8; ILM_IMON; ITIMER; TPS25974LRPW; VIN; V3GND; ENABLE PGOOD; CURRENT; CURRENT PGOOD; GND OUT GND; ENABLE; IMON_RAW; DVDT GND; CURRENT CURRENT PGOOD; V3 PG_SENSE PG_SENSE; OV_SENSE; OUT GND; DVDT; PG_SENSE PGOOD OUT

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
## Title: PulsarPower - 5 A switched DC outlet

File: dc_outlet.kicad_sch

Sheet: /DC outlet 3/

PulsarFab

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

## SWITCHED DC OUTLET | 12-18 V / 5 A service | hardware voltage inhibit / latched breaker

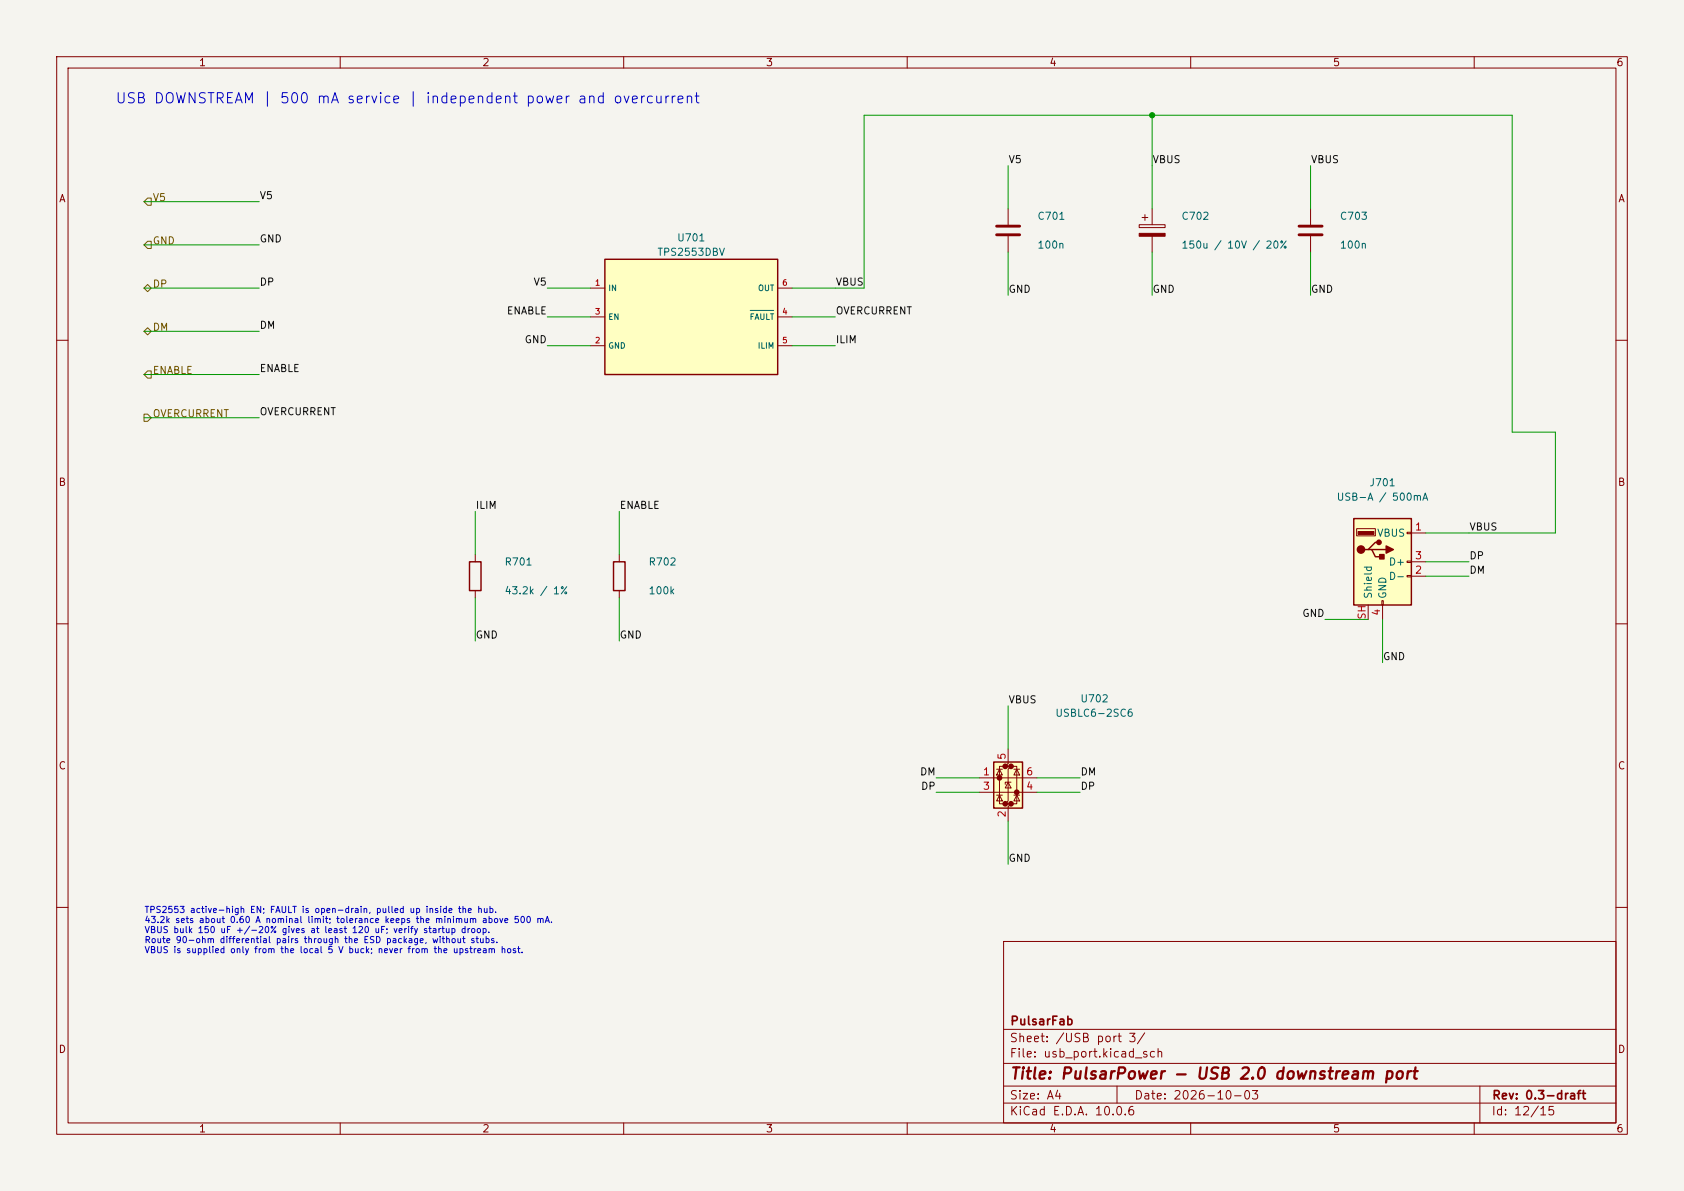
[picture p15: page 12]

ENABLE USB DOWNSTREAM | 500 mA service | independent power and overcurrent

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

PulsarFab
Sheet: /USB port 3/
File: usb_port.kicad_sch
Title: PulsarPower - USB 2.0 downstream port

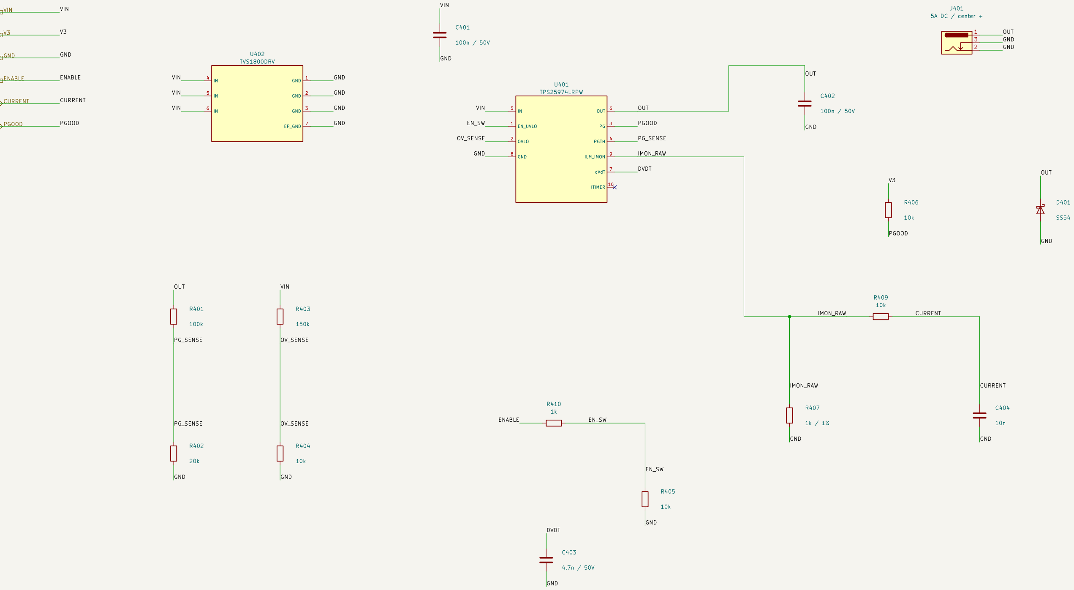
[picture p16: figure]
GND; 1 GND; 2 GND; EP_GND; TVS1800DRV; J401 5A DC / center +; EN_UVLO 1; OVLO 2; 3 PGTH; OUT; dVdT; 7 GND 8; ILM_IMON; ITIMER; TPS25974LRPW; VIN; V3GND; ENABLE PGOOD; CURRENT; CURRENT PGOOD; GND OUT GND; ENABLE; IMON_RAW; DVDT GND; CURRENT CURRENT PGOOD; V3 PG_SENSE PG_SENSE; OV_SENSE; OUT GND; DVDT; PG_SENSE PGOOD OUT

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
## Title: PulsarPower - 5 A switched DC outlet

File: dc_outlet.kicad_sch

Sheet: /DC outlet 4/

PulsarFab

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

## SWITCHED DC OUTLET | 12-18 V / 5 A service | hardware voltage inhibit / latched breaker

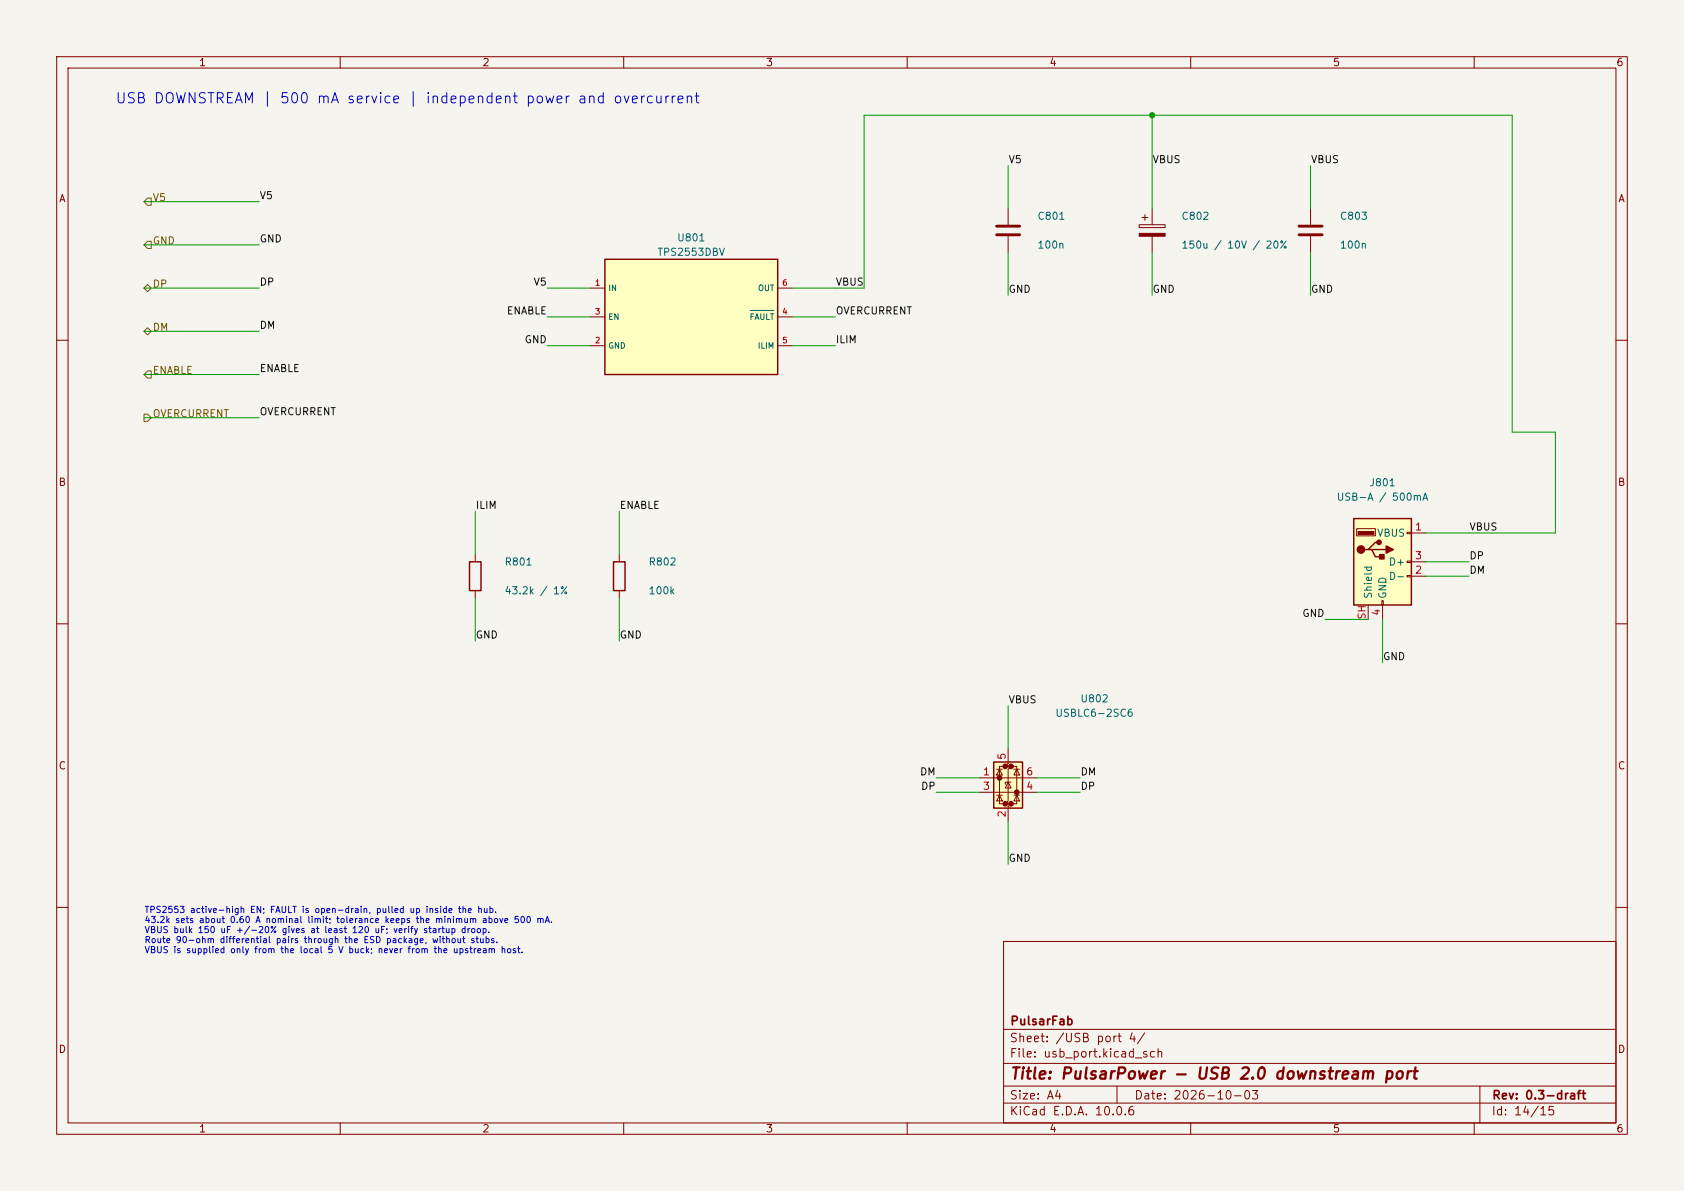
[picture p17: page 14]

ENABLE USB DOWNSTREAM | 500 mA service | independent power and overcurrent

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

PulsarFab
Sheet: /USB port 4/
File: usb_port.kicad_sch
Title: PulsarPower - USB 2.0 downstream port

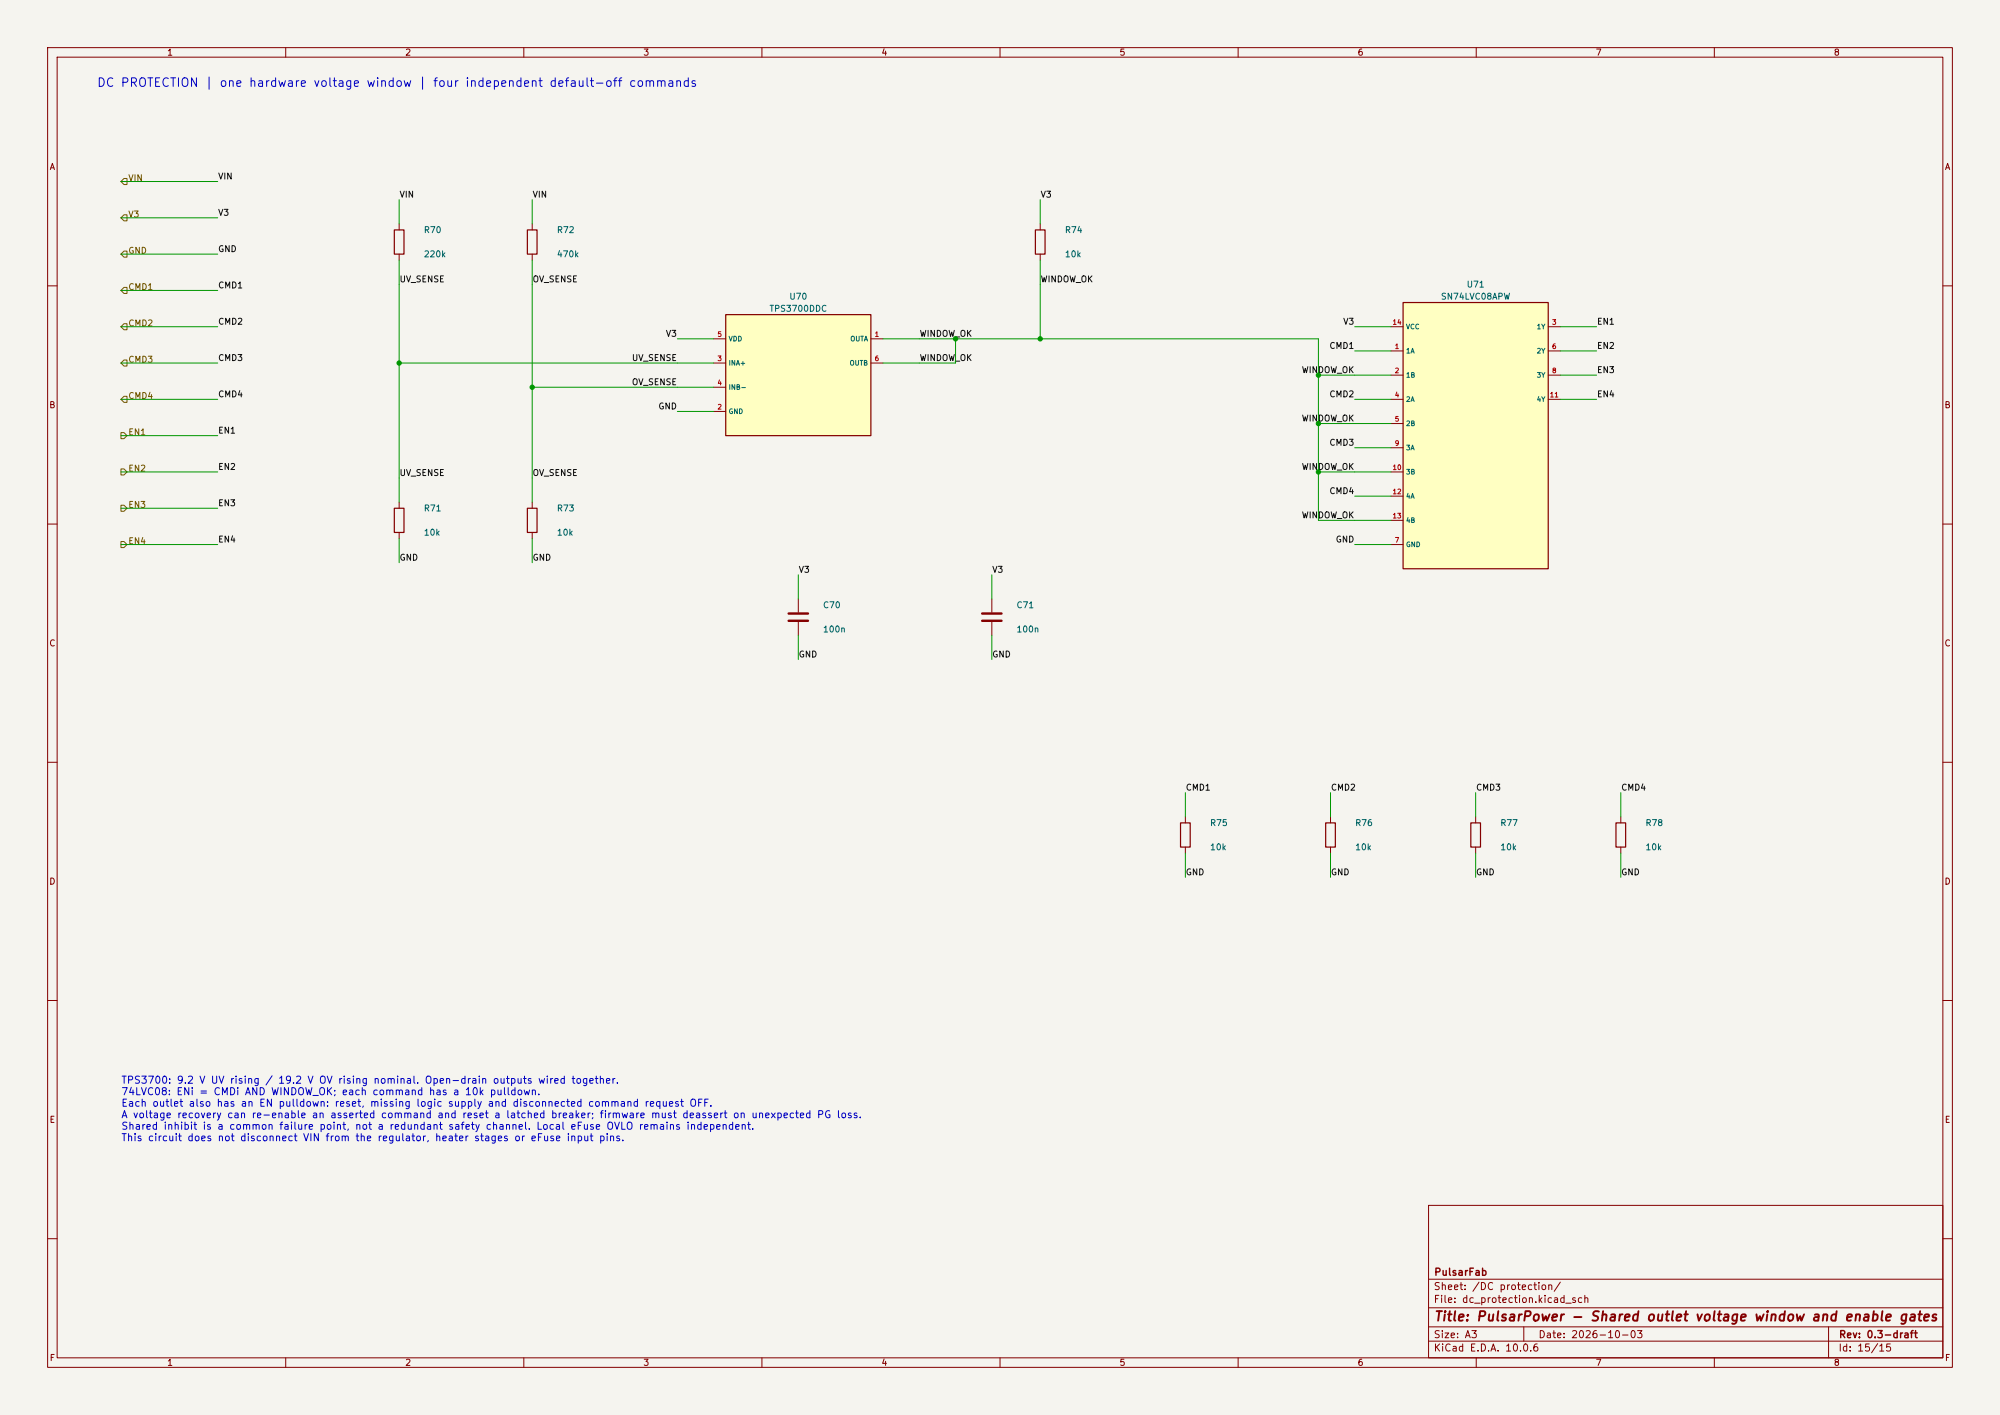
[picture p18: page 15]

DC PROTECTION | one hardware voltage window | four independent default-off commands

TPS3700: 9.2 V UV rising / 19.2 V OV rising nominal. Open-drain outputs wired together.
74LVC08: ENi = CMDi AND WINDOW_OK; each command has a 10k pulldown.
Each outlet also has an EN pulldown: reset, missing logic supply and disconnected command request OFF.
A voltage recovery can re-enable an asserted command and reset a latched breaker; firmware must deassert on unexpected PG loss.
Shared inhibit is a common failure point, not a redundant safety channel. Local eFuse OVLO remains independent.
This circuit does not disconnect VIN from the regulator, heater stages or eFuse input pins.

PulsarFab
Sheet: /DC protection/
File: dc_protection.kicad_sch
Title: PulsarPower - Shared outlet voltage window and enable gates
