pulsarfab/pulsarfab/hardware/pulsardewhub/pulsardewhub.kicad_pcb

## KiCad design hardware/pulsardewhub/pulsardewhub.kicad_pcb (2026-10-04)

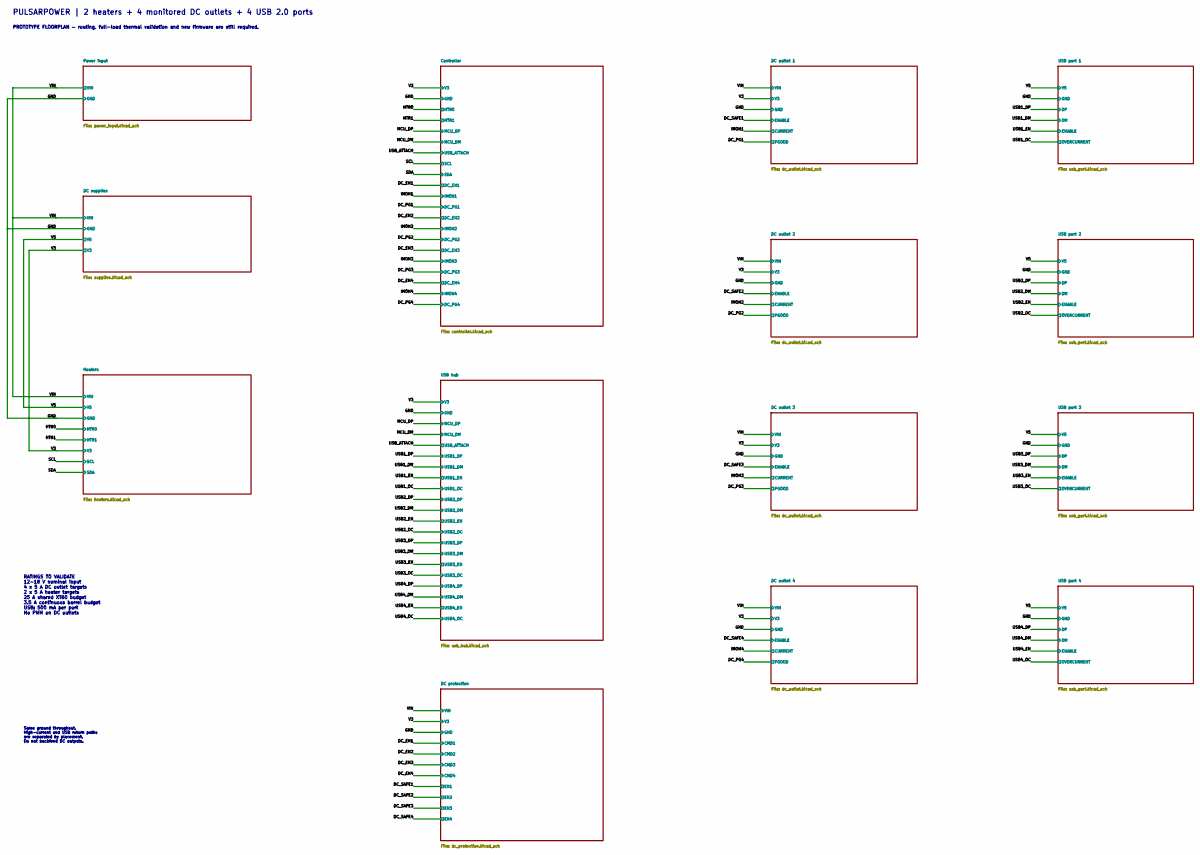
[picture p28: schematic pulsardewhub.kicad_sch, PulsarPower - System interconnect]

Notes on the sheet:
PULSARPOWER | 2 heaters + 4 monitored DC outlets + 4 USB 2.0 ports
PROTOTYPE FLOORPLAN — routing, full-load thermal validation and new firmware are still required.
RATINGS TO VALIDATE 12-18 V nominal input 4 x 5 A DC outlet targets 2 x 5 A heater targets 25 A shared XT60 budget 3.5 A continuous barrel budget USB: 500 mA per port No PWM on DC outlets
Same ground throughout. High-current and USB return paths are separated by placement. Do not backfeed DC outputs.

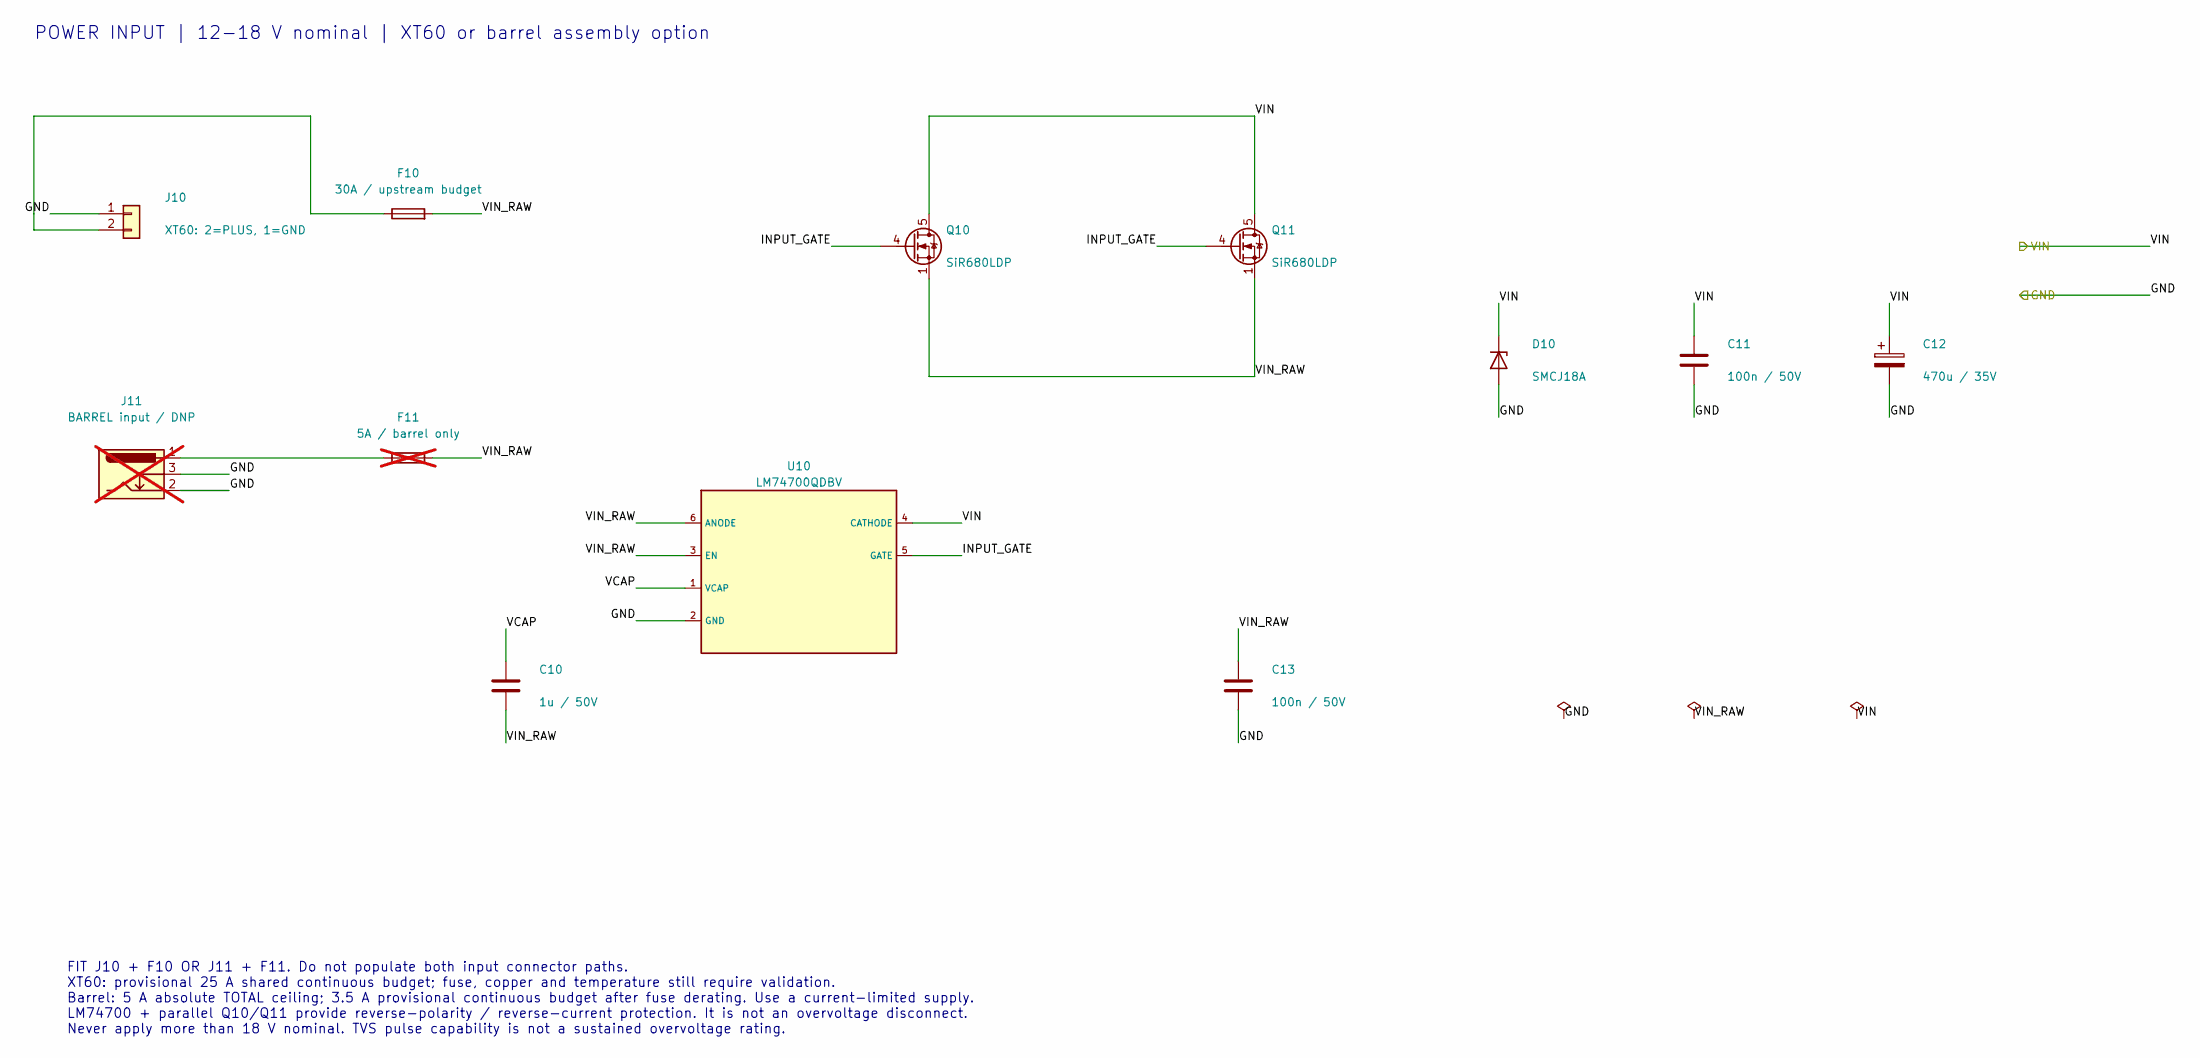
[picture p29: schematic power_input.kicad_sch, PulsarPower - Fused input and reverse-polarity protection]

Parts:
C10: 1u / 50V; C_0603_1608Metric; MPN CL10A105KB8NNNC; LCSC C15849
C11, C13: 100n / 50V; C_0603_1608Metric; MPN CC0603KRX7R9BB104; LCSC C14663
C12: 470u / 35V; CP_Radial_D10.0mm_P5.00mm; MPN ERS1VM471G16OT; LCSC C106703
D10: SMCJ18A; D_SMC; MPN SMCJ18A; LCSC C438102
F10: 30A / upstream budget; Fuse_S1032_10.3x3.2mm; MPN S1032-F-30.0A; LCSC C553917
F11: 5A / barrel only; Fuse_Littelfuse-NANO2-451_453; MPN 0451005.MRL; LCSC C48467; not fitted
J10: XT60: 2=PLUS, 1=GND; AMASS_XT60PW-M_Edge; MPN XT60PW-M; LCSC C98732
J11: BARREL input / DNP; BarrelJack_XKB_DC-005K-5A_Edge; MPN DC-005K-5A-2.0; LCSC C2880546; not fitted
Q10, Q11: SiR680LDP; PowerPAK_SO-8_Single; MPN SIR680LDP-T1-RE3; LCSC C3279524
U10: LM74700QDBV; SOT-23-6; MPN LM74700QDBVRQ1; LCSC C2941042

Connections:
/GND: C11.2, C12.2, C13.2, D10.2 (A), J10.1, J11.2, J11.3, U10.2 (GND); also elsewhere on the board
/Power input/INPUT_GATE: Q10.4 (G), Q11.4 (G), U10.5 (GATE)
/Power input/VCAP: C10.1, U10.1 (VCAP)
/Power input/VIN_RAW: C10.2, C13.1, F10.2, F11.2, Q10.1 (S), Q10.2 (S), Q10.3 (S), Q11.1 (S), Q11.2 (S), Q11.3 (S), U10.3 (EN), U10.6 (ANODE)
/VIN: C11.1, C12.1, D10.1 (K), Q10.5 (D), Q11.5 (D), U10.4 (CATHODE); also elsewhere on the board
unnamed: F11.1, J11.1
unnamed: F10.1, J10.2

Notes on the sheet:
POWER INPUT | 12-18 V nominal | XT60 or barrel assembly option
FIT J10 + F10 OR J11 + F11. Do not populate both input connector paths. XT60: provisional 25 A shared continuous budget; fuse, copper and temperature still require validation. Barrel: 5 A absolute TOTAL ceiling; 3.5 A provisional continuous budget after fuse derating. Use a current-limited supply. 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

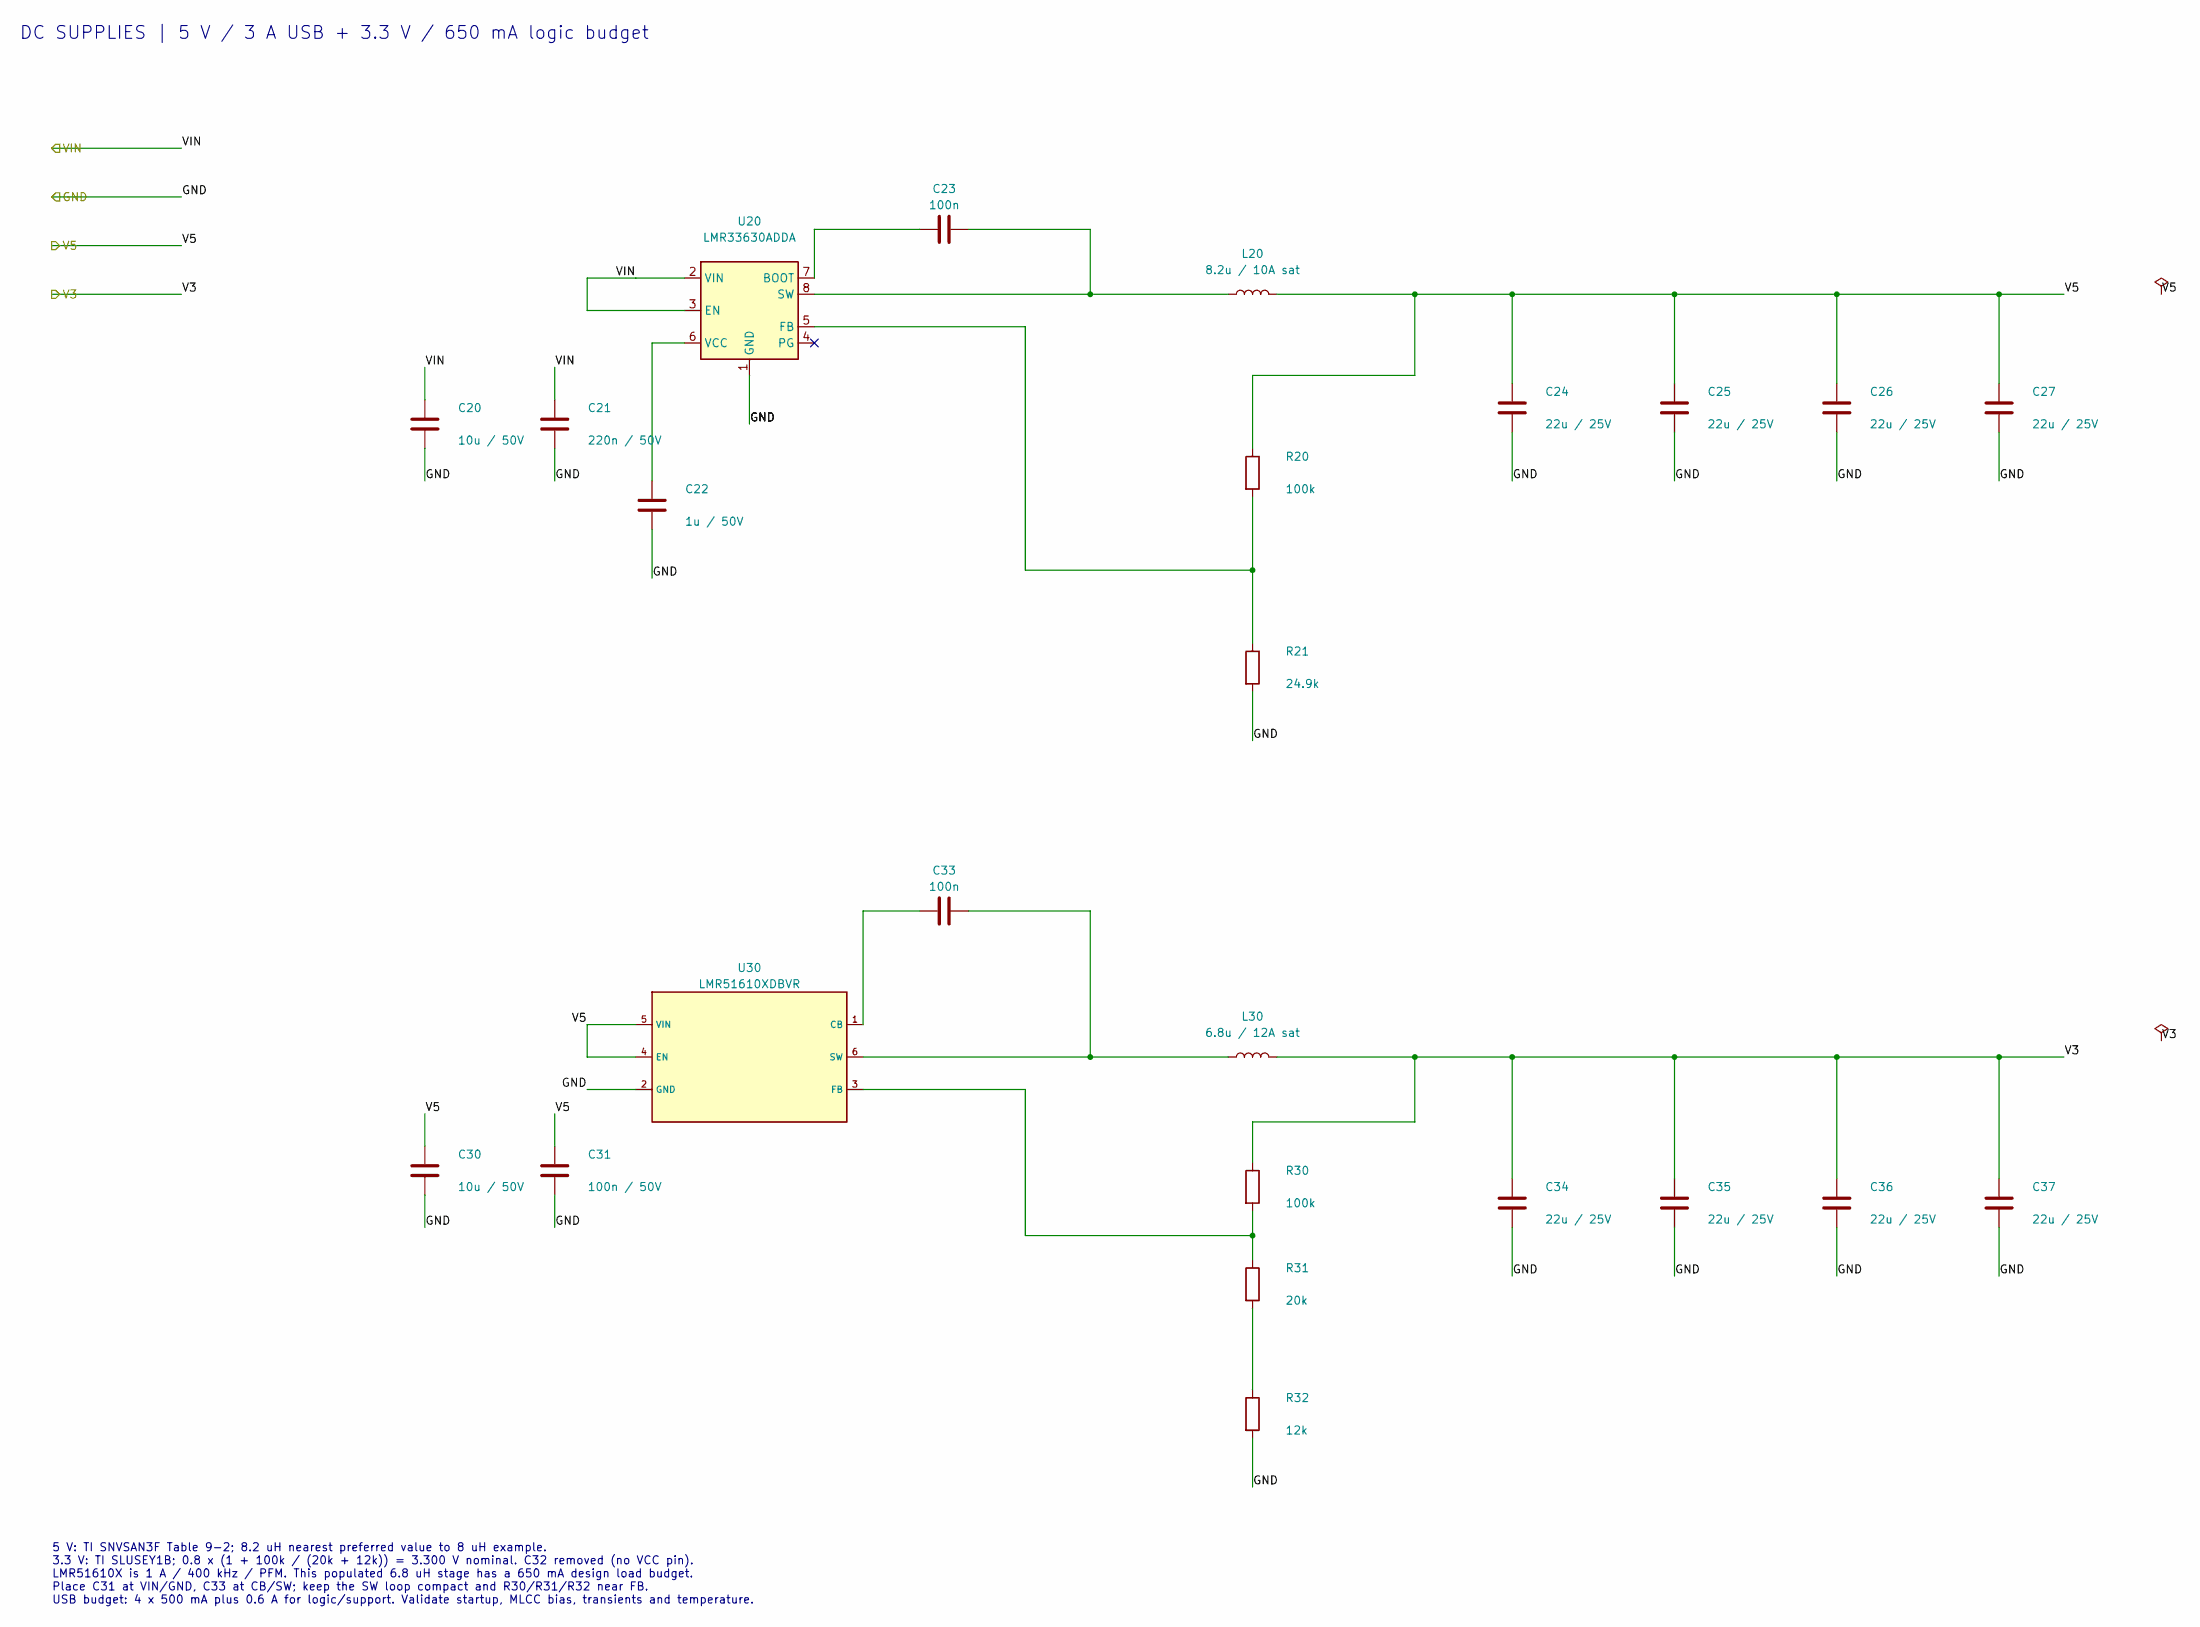
[picture p30: schematic supplies.kicad_sch, PulsarPower - 5 V USB and 3.3 V logic supplies]

Parts:
C20, C30: 10u / 50V; C_1210_3225Metric; MPN CL32B106KBJNNNE; LCSC C138687
C21: 220n / 50V; C_0603_1608Metric; MPN CL10B224KB8NNNC; LCSC C64705
C22: 1u / 50V; C_0603_1608Metric; MPN CL10A105KB8NNNC; LCSC C15849
C23, C33: 100n; C_0603_1608Metric; MPN CC0603KRX7R9BB104; LCSC C14663
C24, C25, C26, C27, C34, C35, C36, C37: 22u / 25V; C_1206_3216Metric; MPN CL31A226KAHNNNE; LCSC C12891
C31: 100n / 50V; C_0603_1608Metric; MPN CC0603KRX7R9BB104; LCSC C14663
L20: 8.2u / 10A sat; L_SXN_SMMS1050; MPN SMMS1050-8R2M; LCSC C149543
L30: 6.8u / 12A sat; L_SXN_SMMS1050; MPN SMMS1050-6R8M; LCSC C149542
R20, R30: 100k; R_0603_1608Metric; MPN 0603WAF1003T5E; LCSC C25803
R21: 24.9k; R_0603_1608Metric; MPN 0603WAF2492T5E; LCSC C25962
R31: 20k; R_0603_1608Metric; MPN 0603WAF2002T5E; LCSC C4184
R32: 12k; R_0603_1608Metric; MPN 0603WAF1202T5E; LCSC C22790
U20: LMR33630ADDA; Texas_HSOP-8-1EP_3.9x4.9mm_P1.27mm; MPN LMR33630ADDAR; LCSC C841384
U30: LMR51610XDBVR; SOT-23-6; MPN LMR51610XDBVR; LCSC C20539658

Connections:
/GND: C20.2, C21.2, C22.2, C24.2, C25.2, C26.2, C27.2, C30.2, C31.2, C34.2, C35.2, C36.2, C37.2, R21.2, R32.2, U20.1 (GND), U20.9 (GND), U30.2 (GND); also elsewhere on the board
/V3: C34.1, C35.1, C36.1, C37.1, L30.2, R30.1; also elsewhere on the board
/V5: C24.1, C25.1, C26.1, C27.1, C30.1, C31.1, L20.2, R20.1, U30.4 (EN), U30.5 (VIN); also elsewhere on the board
/VIN: C20.1, C21.1, U20.2 (VIN), U20.3 (EN); also elsewhere on the board
unnamed: R31.2, R32.1
unnamed: C23.1, U20.7 (BOOT)
unnamed: R20.2, R21.1, U20.5 (FB)
unnamed: C23.2, L20.1, U20.8 (SW)
unnamed: C22.1, U20.6 (VCC)
unnamed: C33.1, U30.1 (CB)
unnamed: R30.2, R31.1, U30.3 (FB)
unnamed: C33.2, L30.1, U30.6 (SW)

Notes on the sheet:
DC SUPPLIES | 5 V / 3 A USB + 3.3 V / 650 mA logic budget
5 V: TI SNVSAN3F Table 9-2; 8.2 uH nearest preferred value to 8 uH example. 3.3 V: TI SLUSEY1B; 0.8 x (1 + 100k / (20k + 12k)) = 3.300 V nominal. C32 removed (no VCC pin). LMR51610X is 1 A / 400 kHz / PFM. This populated 6.8 uH stage has a 650 mA design load budget. Place C31 at VIN/GND, C33 at CB/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

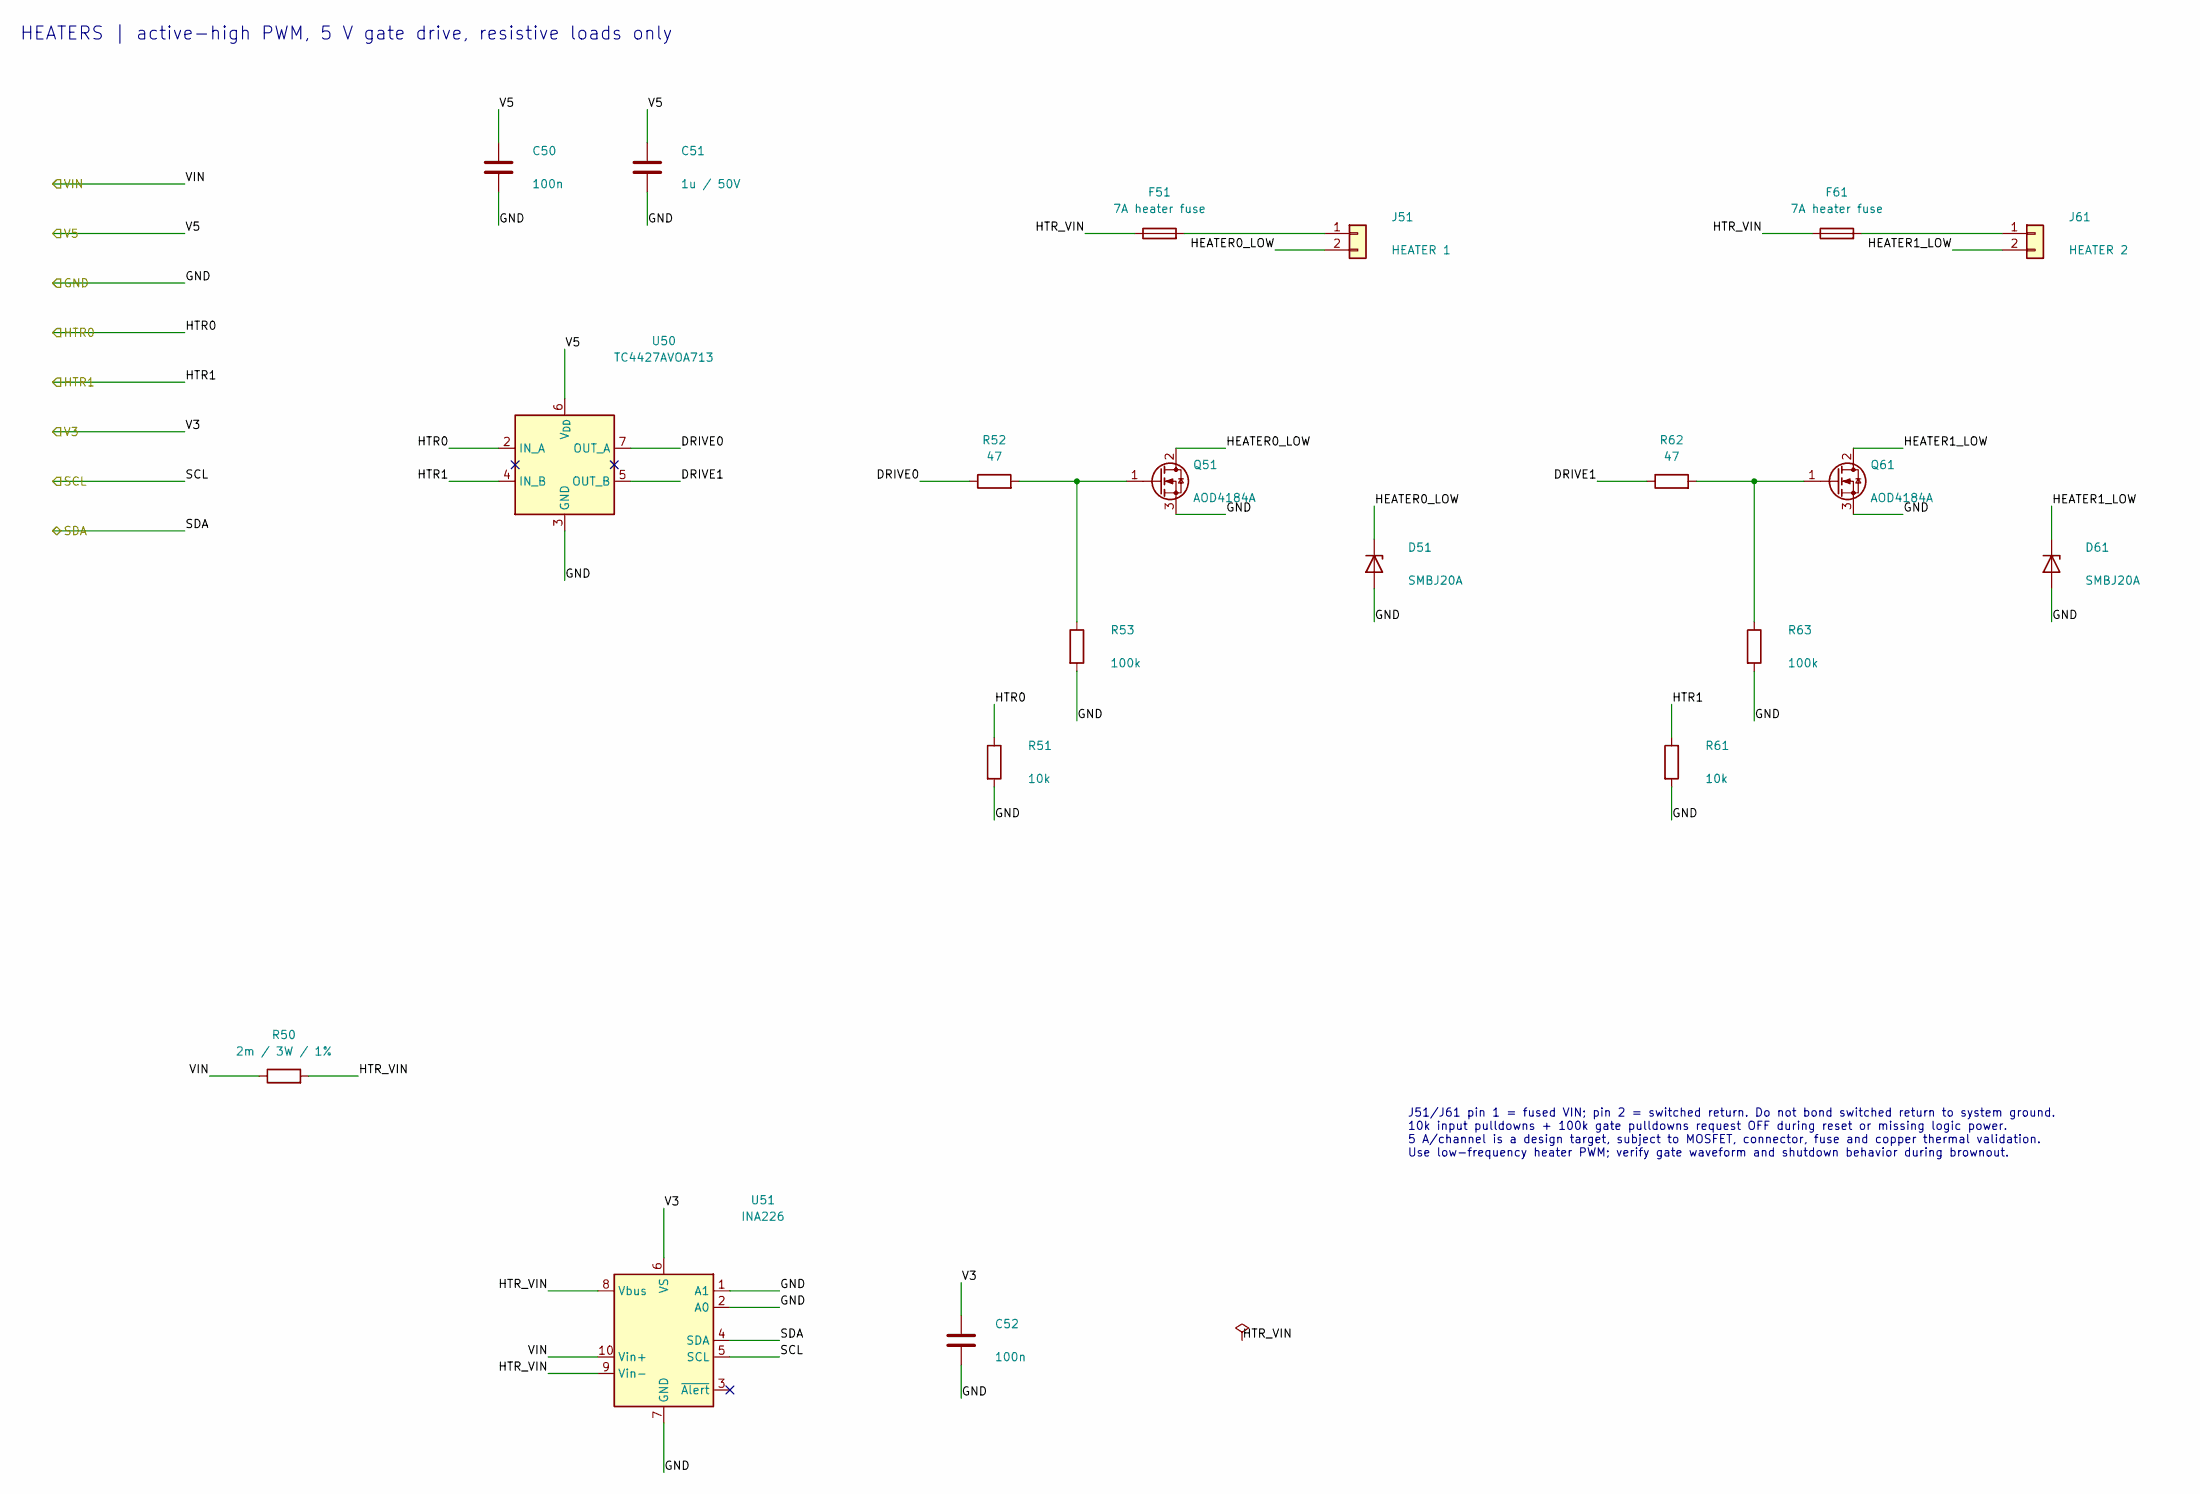
[picture p31: schematic heaters.kicad_sch, PulsarPower - Two default-off heater outputs]

Parts:
C50, C52: 100n; C_0603_1608Metric; MPN CC0603KRX7R9BB104; LCSC C14663
C51: 1u / 50V; C_0603_1608Metric; MPN CL10A105KB8NNNC; LCSC C15849
D51, D61: SMBJ20A; D_SMB; MPN SMBJ20A; LCSC C364296
F51, F61: 7A heater fuse; Fuse_Littelfuse-NANO2-451_453; MPN 0451007.MRL; LCSC C99548
J51: HEATER 1; TerminalBlock_KEFA_KF128_2P_P5.08mm; MPN KF128-5.08-2P-AA; LCSC C474952
J61: HEATER 2; TerminalBlock_KEFA_KF128_2P_P5.08mm; MPN KF128-5.08-2P-AA; LCSC C474952
Q51, Q61: AOD4184A; TO-252-2; MPN AOD4184A; LCSC C5370959
R50: 2m / 3W / 1%; R_2512_6332Metric; MPN HoLLR2512-3W-2mR-1%; LCSC C2994640
R51, R61: 10k; R_0603_1608Metric; MPN 0603WAF1002T5E; LCSC C25804
R52, R62: 47; R_0603_1608Metric; MPN 0603WAF470JT5E; LCSC C23182
R53, R63: 100k; R_0603_1608Metric; MPN 0603WAF1003T5E; LCSC C25803
U50: TC4427AVOA713; SOIC-8_3.9x4.9mm_P1.27mm; MPN TC4427AVOA713; LCSC C624944
U51: INA226; TSSOP-10_3x3mm_P0.5mm; MPN INA226AIDGSR; LCSC C49851

Connections:
/GND: C50.2, C51.2, C52.2, D51.2 (A), D61.2 (A), Q51.3 (S), Q61.3 (S), R51.2, R53.2, R61.2, R63.2, U50.3 (GND), U51.1 (A1), U51.2 (A0), U51.7 (GND); also elsewhere on the board
/HTR0: R51.1, U50.2 (IN_A); also elsewhere on the board
/HTR1: R61.1, U50.4 (IN_B); also elsewhere on the board
/Heaters/DRIVE0: R52.1, U50.7 (OUT_A)
/Heaters/DRIVE1: R62.1, U50.5 (OUT_B)
/Heaters/HEATER0_LOW: D51.1 (K), J51.2, Q51.2 (D)
/Heaters/HEATER1_LOW: D61.1 (K), J61.2, Q61.2 (D)
/Heaters/HTR_VIN: F51.1, F61.1, R50.2, U51.8 (Vbus), U51.9 (Vin-)
/SCL: U51.5 (SCL); also elsewhere on the board
/SDA: U51.4 (SDA); also elsewhere on the board
/V3: C52.1, U51.6 (VS); also elsewhere on the board
/V5: C50.1, C51.1, U50.6 (V_{DD}); also elsewhere on the board
/VIN: R50.1, U51.10 (Vin+); also elsewhere on the board
unnamed: F51.2, J51.1
unnamed: F61.2, J61.1
unnamed: Q51.1 (G), R52.2, R53.1
unnamed: Q61.1 (G), R62.2, R63.1

Notes on the sheet:
HEATERS | active-high PWM, 5 V gate drive, resistive loads only
J51/J61 pin 1 = fused VIN; pin 2 = switched return. Do not bond switched return to system ground. 10k input pulldowns + 100k gate pulldowns request OFF during reset or missing logic power. 5 A/channel is a design target, subject to MOSFET, connector, fuse and copper thermal validation. Use low-freq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

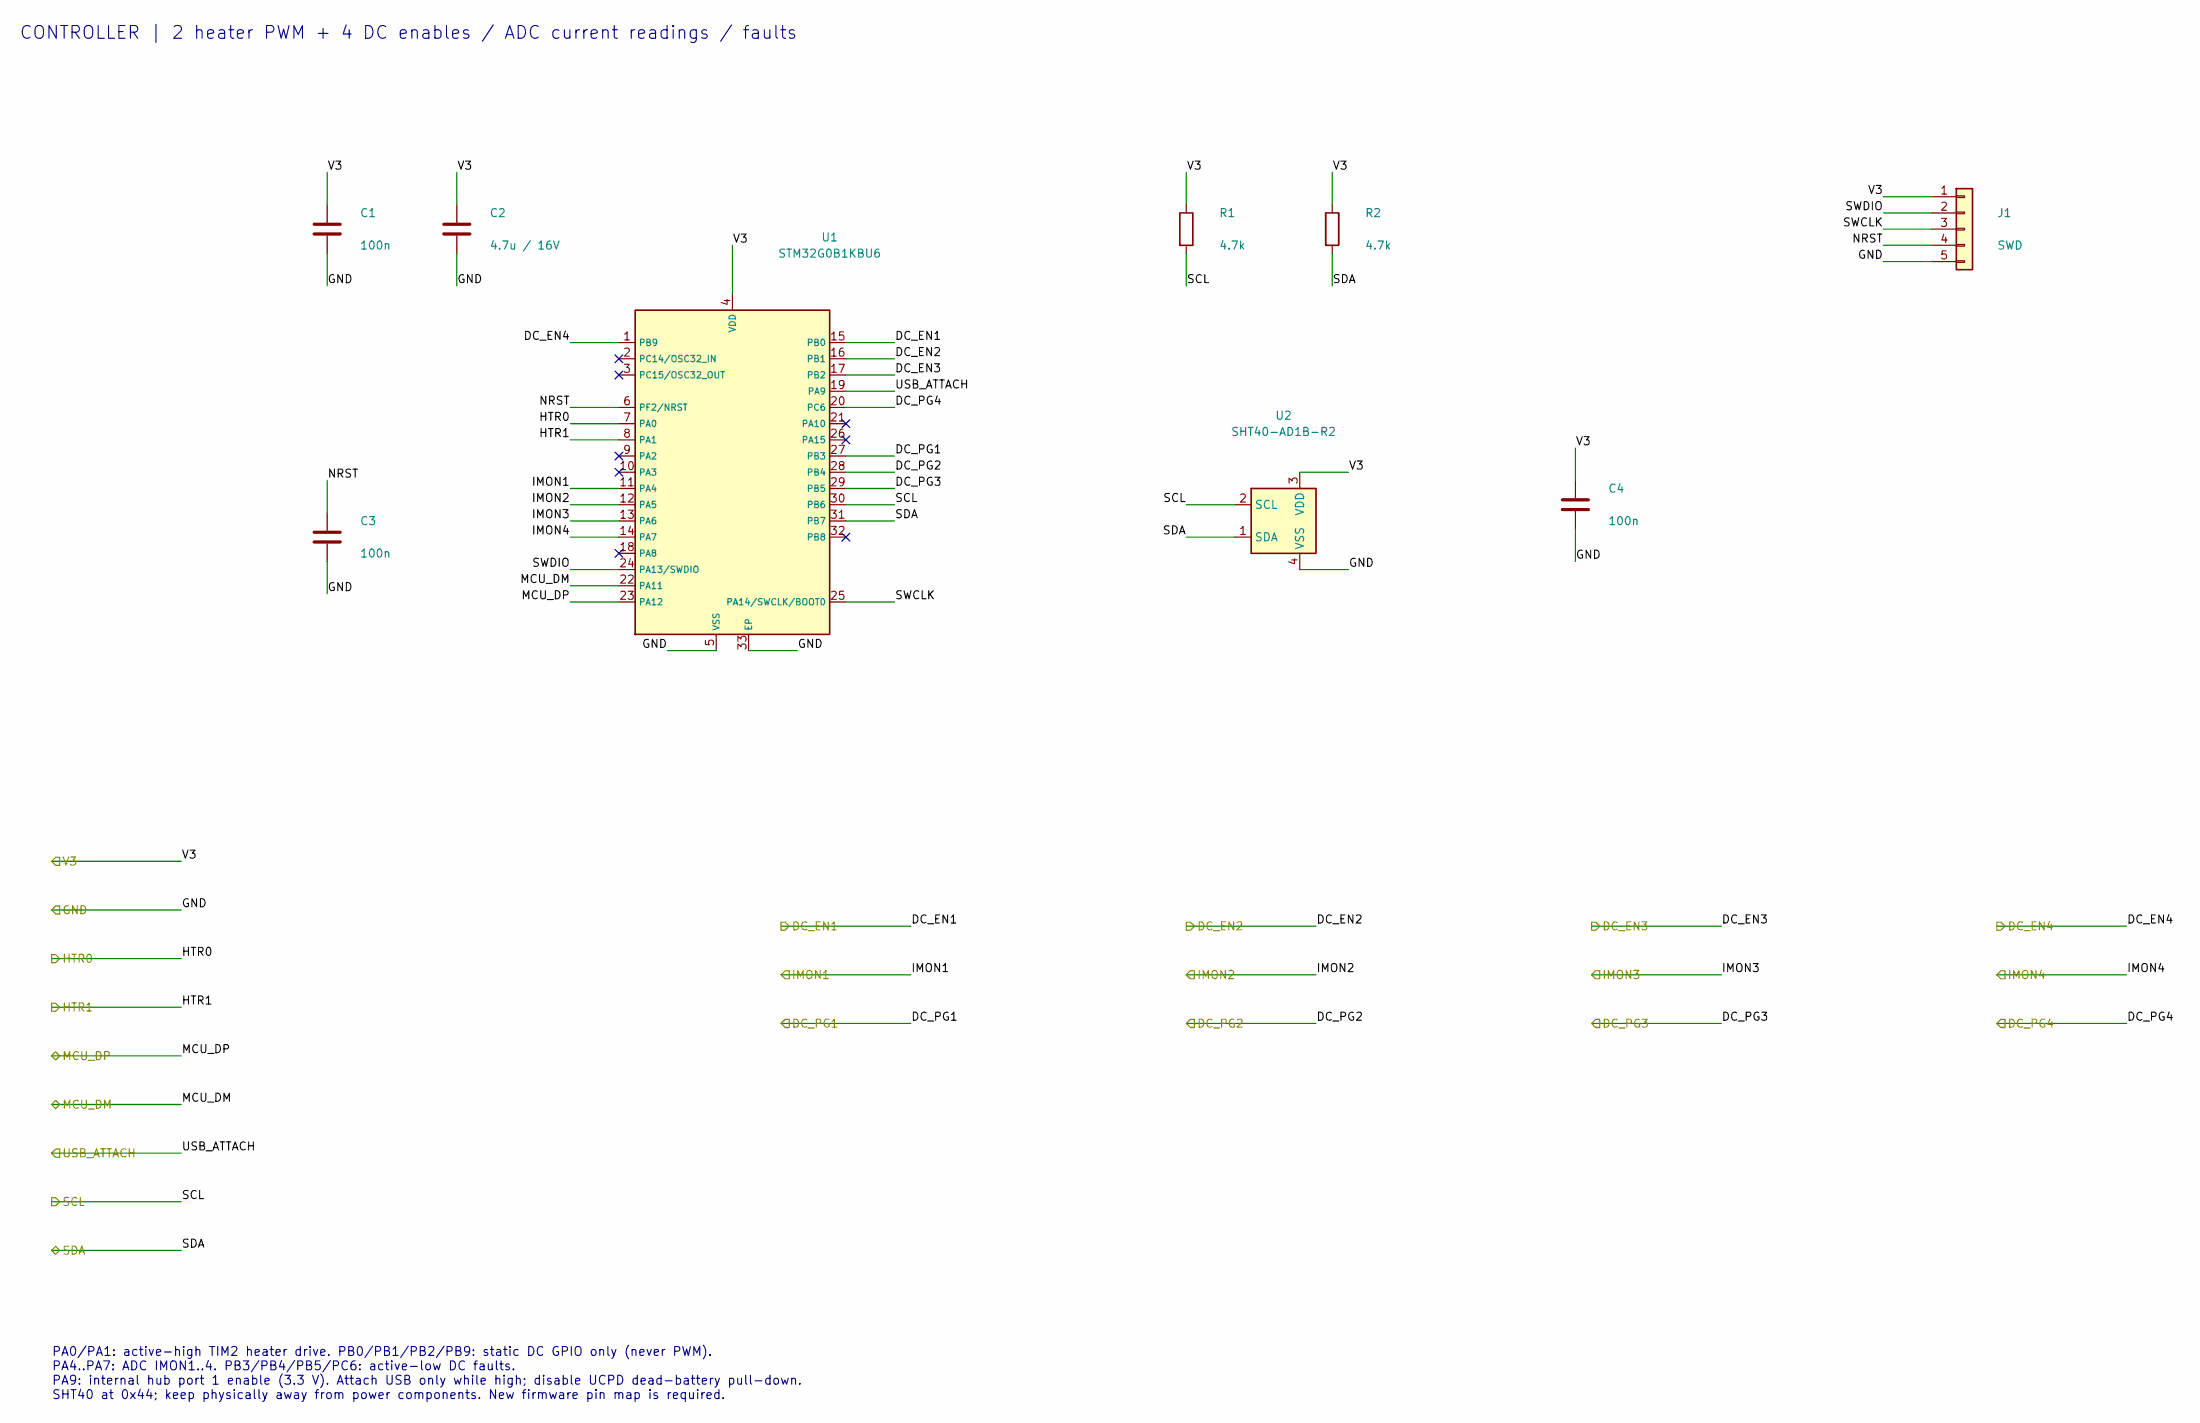
[picture p32: schematic controller.kicad_sch, PulsarPower - STM32 controller and ambient sensor]

Parts:
C1, C3, C4: 100n; C_0603_1608Metric; MPN CC0603KRX7R9BB104; LCSC C14663
C2: 4.7u / 16V; C_0603_1608Metric; MPN CL10A475KO8NNNC; LCSC C19666
J1: SWD; PinHeader_1x05_P2.54mm_Vertical; MPN PZ254V-11-05P; LCSC C492404
R1, R2: 4.7k; R_0603_1608Metric; MPN 0603WAF4701T5E; LCSC C23162
U1: STM32G0B1KBU6; UFQFPN-32-1EP_5x5mm_P0.5mm_EP3.5x3.5mm; MPN STM32G0B1KBU6; LCSC C5159549
U2: SHT40-AD1B-R2; Sensirion_DFN-4_1.5x1.5mm_P0.8mm_SHT4x_NoCentralPad; MPN SHT40-AD1B-R2; LCSC C2909890

Connections:
/Controller/NRST: C3.1, J1.4, U1.6 (PF2/NRST)
/Controller/SWCLK: J1.3, U1.25 (PA14/SWCLK/BOOT0)
/Controller/SWDIO: J1.2, U1.24 (PA13/SWDIO)
/DC_EN1: U1.15 (PB0); also elsewhere on the board
/DC_EN2: U1.16 (PB1); also elsewhere on the board
/DC_EN3: U1.17 (PB2); also elsewhere on the board
/DC_EN4: U1.1 (PB9); also elsewhere on the board
/DC_PG1: U1.27 (PB3); also elsewhere on the board
/DC_PG2: U1.28 (PB4); also elsewhere on the board
/DC_PG3: U1.29 (PB5); also elsewhere on the board
/DC_PG4: U1.20 (PC6); also elsewhere on the board
/GND: C1.2, C2.2, C3.2, C4.2, J1.5, U1.5 (VSS), U1.33 (EP), U2.4 (VSS); also elsewhere on the board
/HTR0: U1.7 (PA0); also elsewhere on the board
/HTR1: U1.8 (PA1); also elsewhere on the board
/IMON1: U1.11 (PA4); also elsewhere on the board
/IMON2: U1.12 (PA5); also elsewhere on the board
/IMON3: U1.13 (PA6); also elsewhere on the board
/IMON4: U1.14 (PA7); also elsewhere on the board
/MCU_DM: U1.22 (PA11); also elsewhere on the board
/MCU_DP: U1.23 (PA12); also elsewhere on the board
/SCL: R1.2, U1.30 (PB6), U2.2 (SCL); also elsewhere on the board
/SDA: R2.2, U1.31 (PB7), U2.1 (SDA); also elsewhere on the board
/USB_ATTACH: U1.19 (PA9); also elsewhere on the board
/V3: C1.1, C2.1, C4.1, J1.1, R1.1, R2.1, U1.4 (VDD), U2.3 (VDD); also elsewhere on the board

Notes on the sheet:
CONTROLLER | 2 heater PWM + 4 DC enables / ADC current readings / faults
PA0/PA1: active-high TIM2 heater drive. PB0/PB1/PB2/PB9: static DC GPIO only (never PWM). PA4..PA7: ADC IMON1..4. PB3/PB4/PB5/PC6: active-low DC faults. PA9: internal hub port 1 enable (3.3 V). Attach USB only while high; disable UCPD dead-battery pull-down. SHT40 at 0x44; keep physically away from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
