pulsarfab/pulsarfab/hardware/pulsardewhub/pulsardewhub.kicad_pcb

## KiCad design hardware/pulsardewhub/pulsardewhub.kicad_pcb (continued)

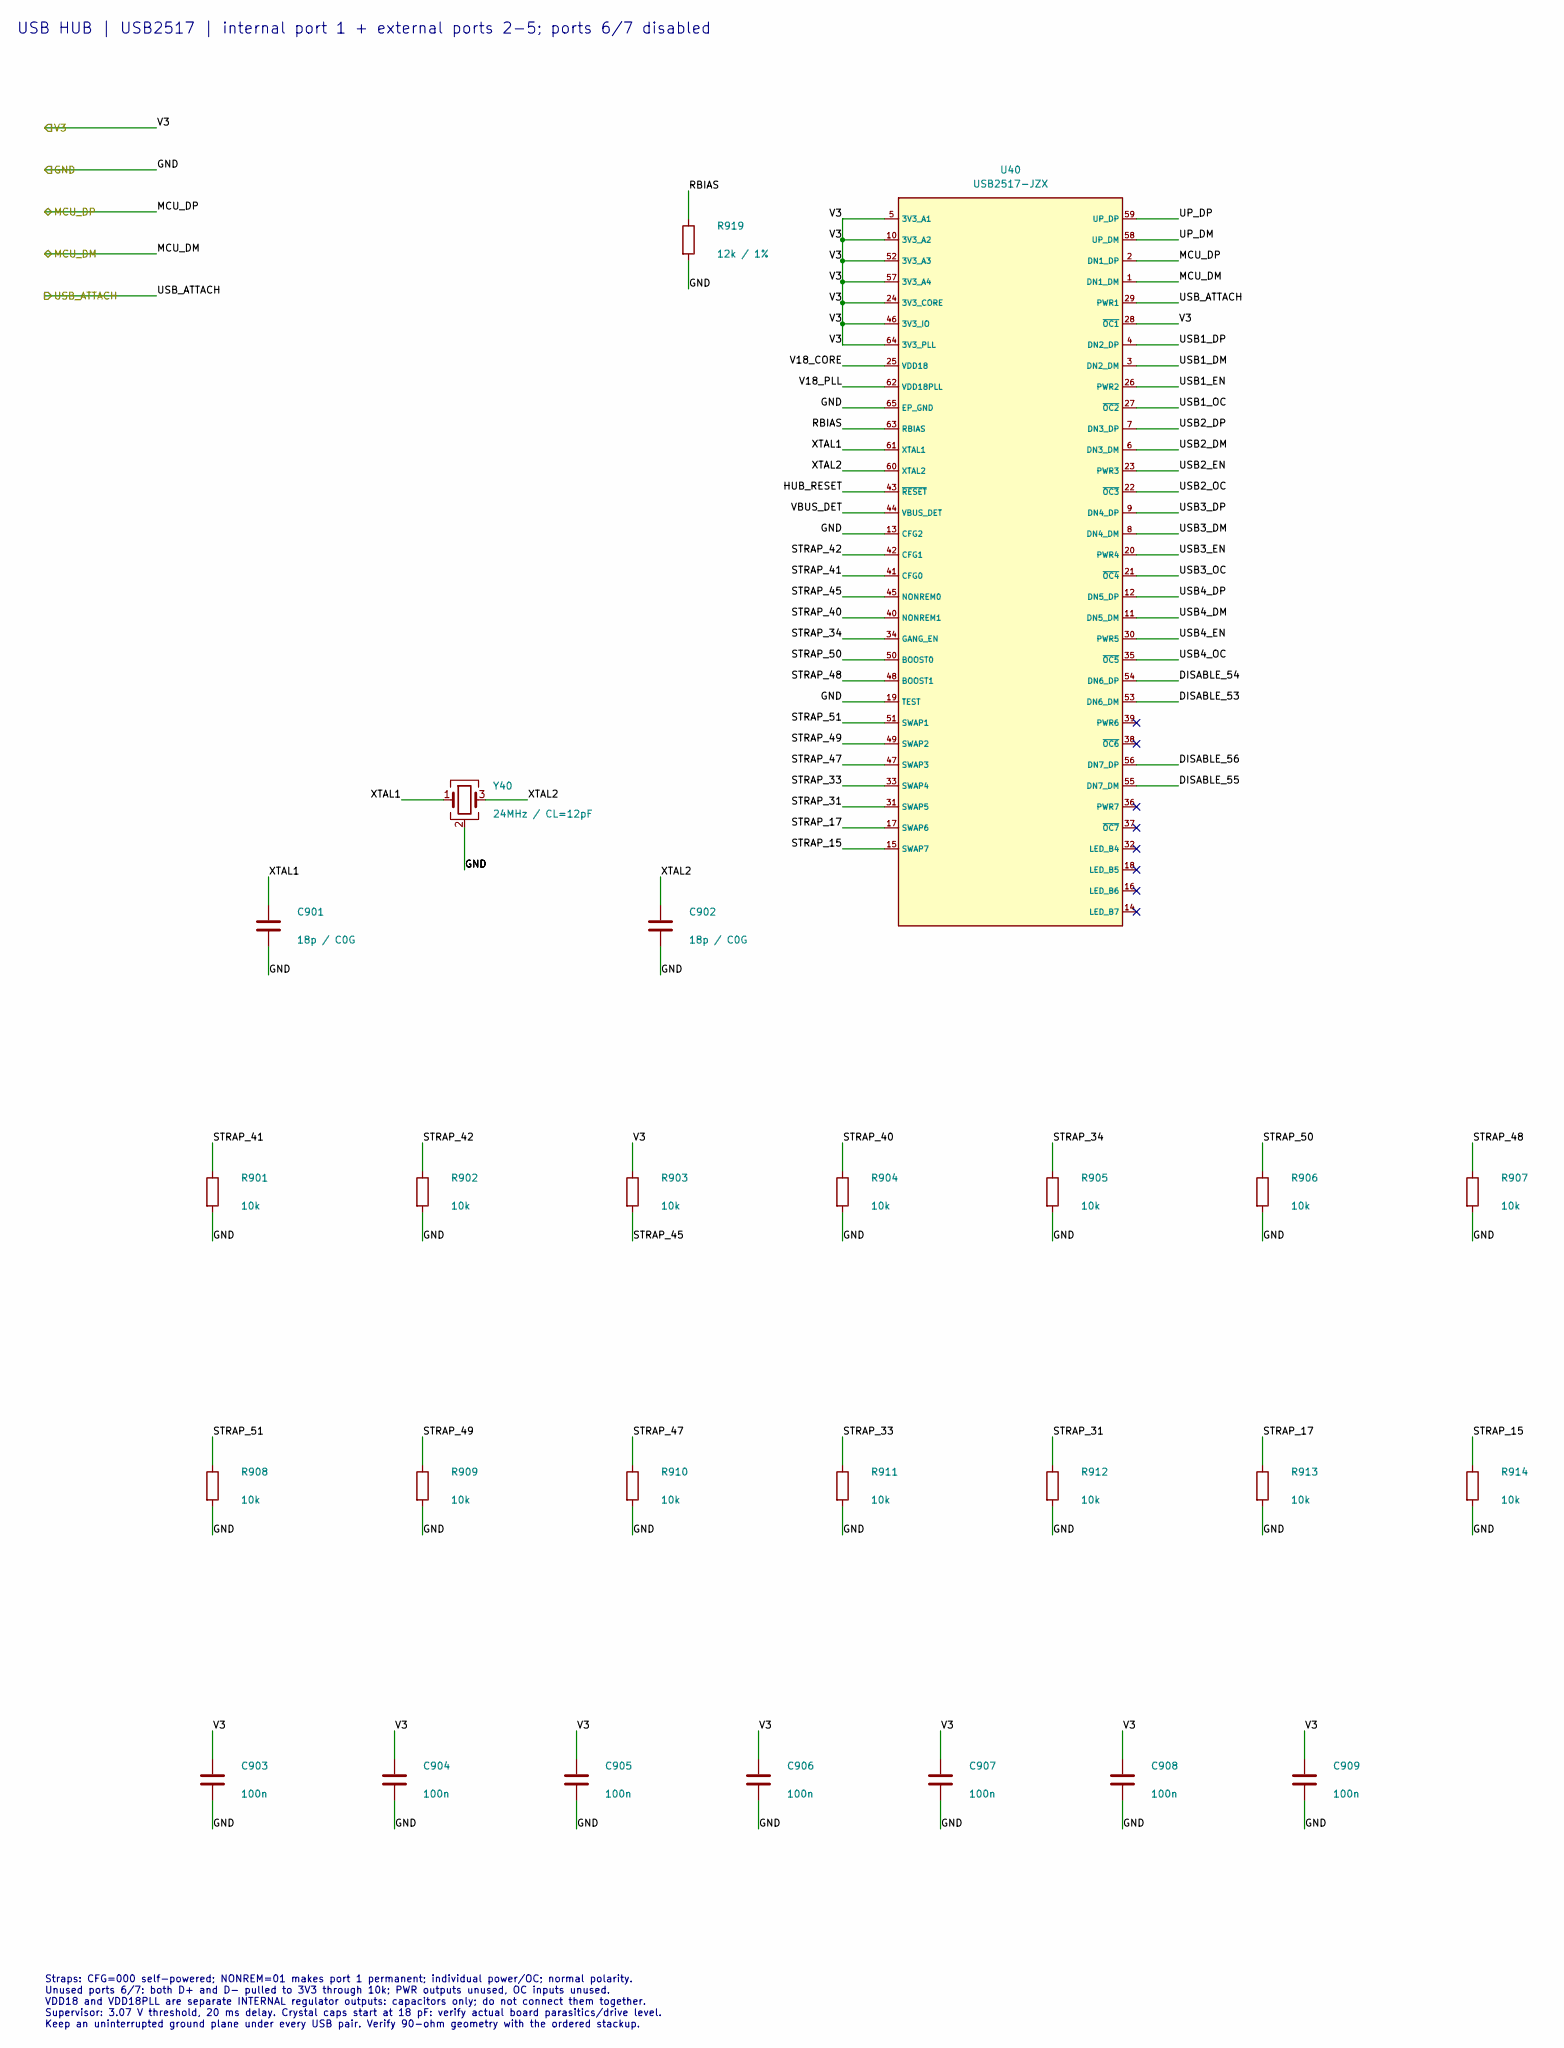
[picture p33: schematic usb_hub.kicad_sch, PulsarPower - USB 2.0 hub and upstream interface, part in row 1, column 1]

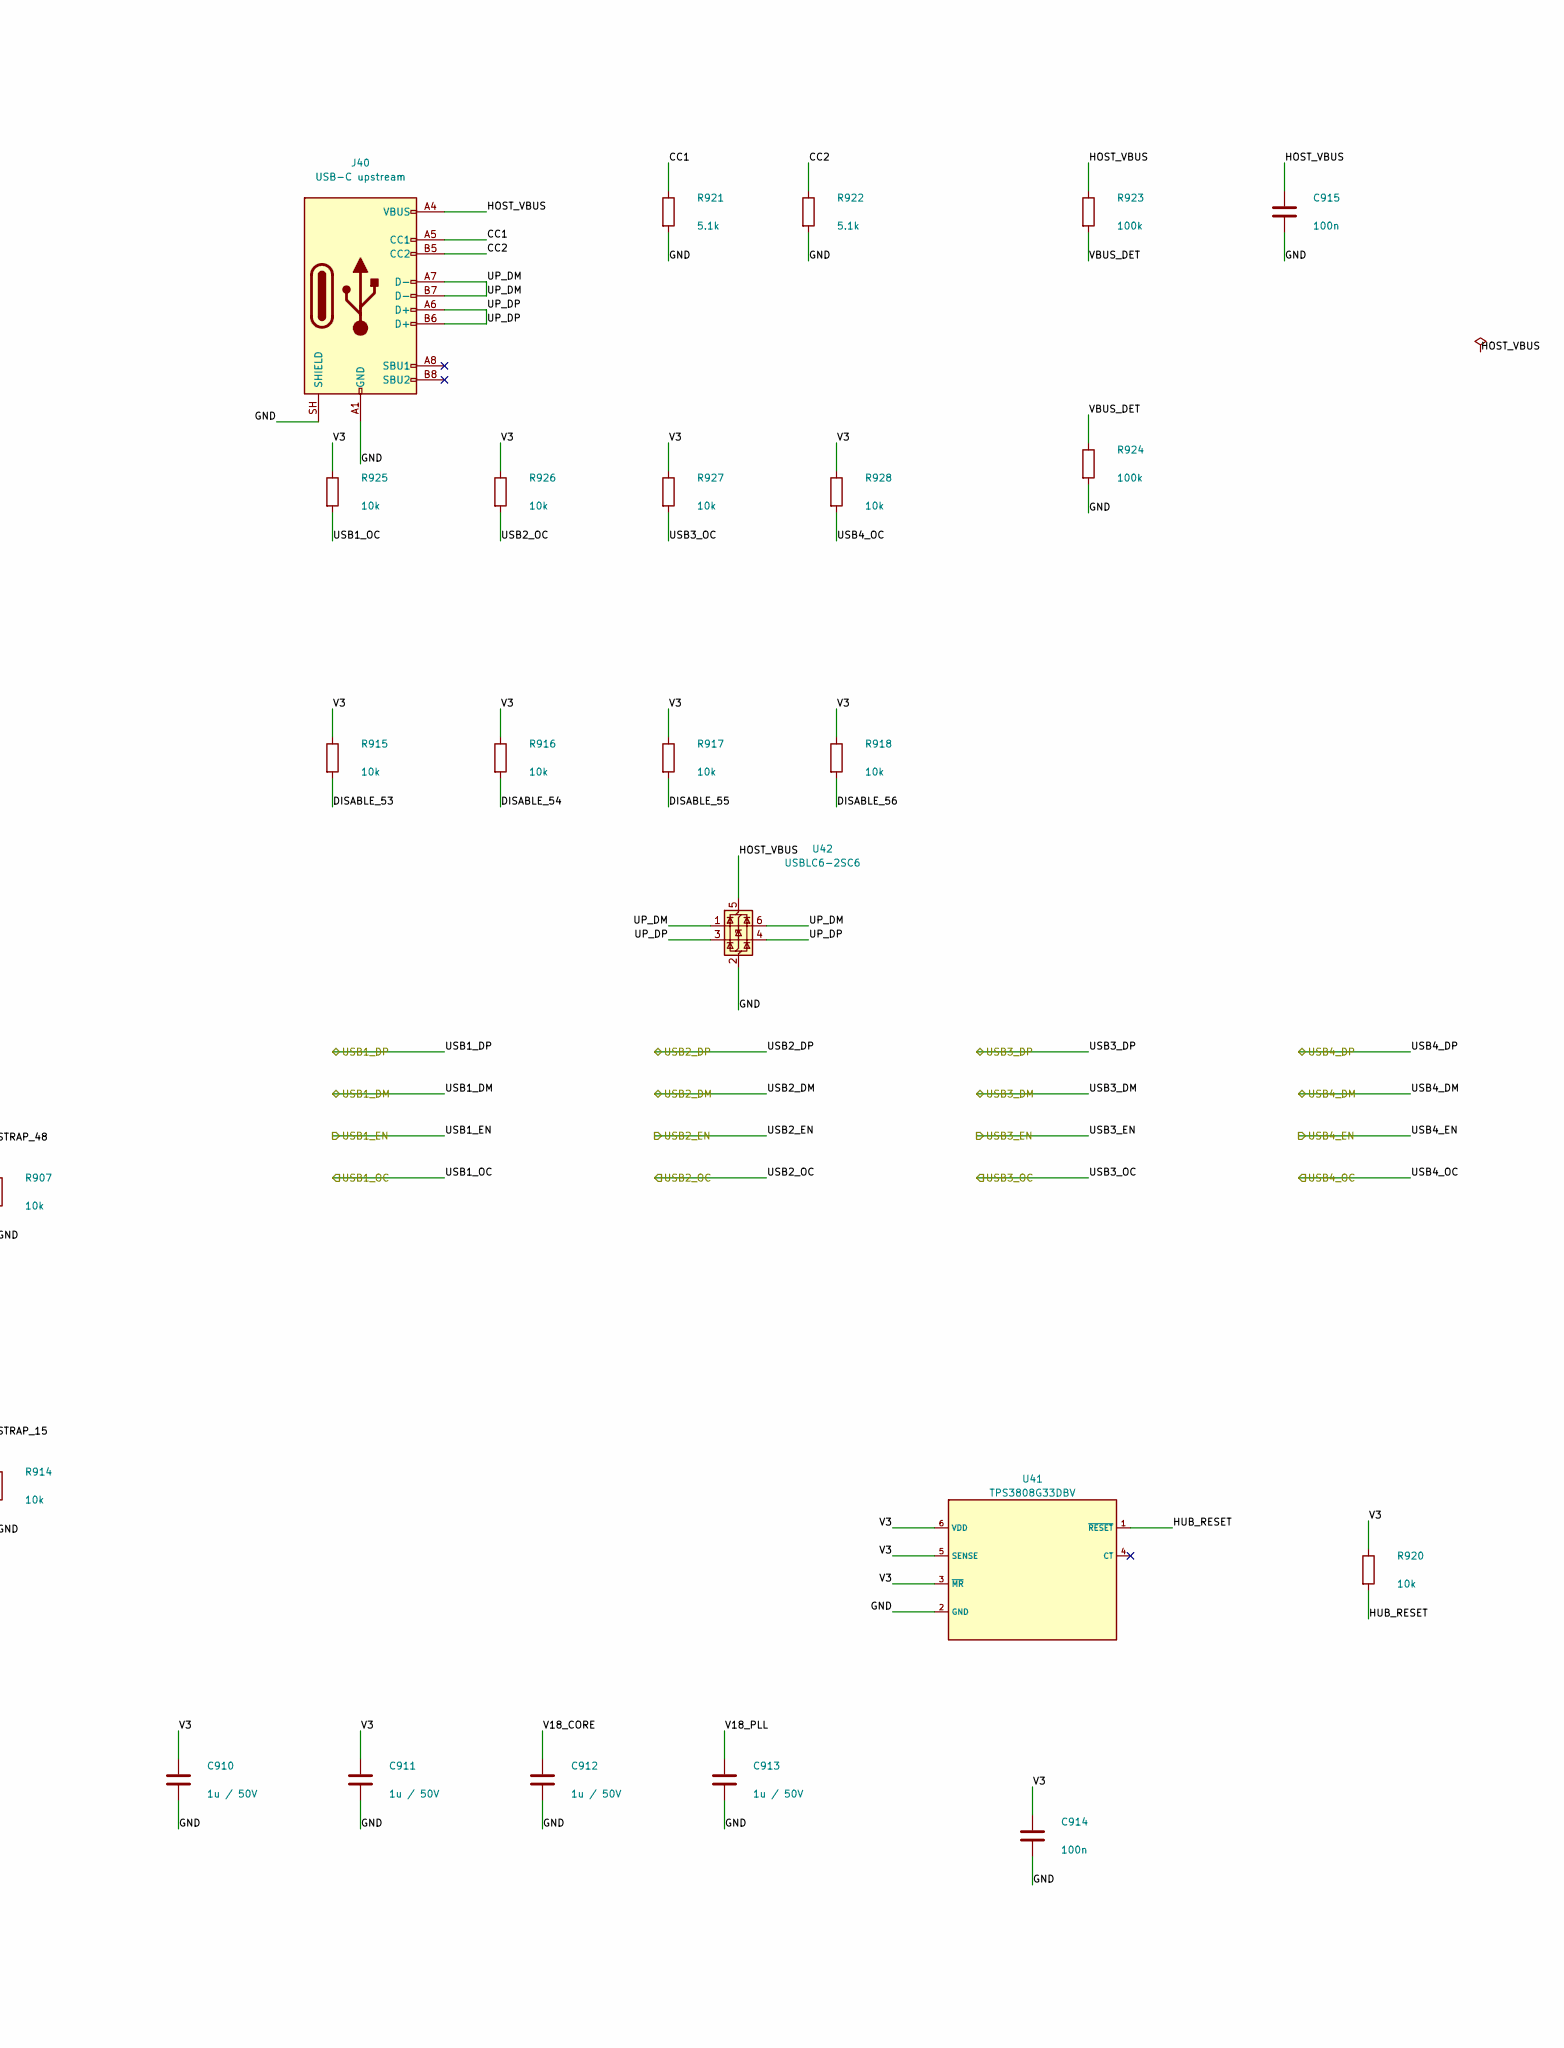
[picture p34: schematic usb_hub.kicad_sch, PulsarPower - USB 2.0 hub and upstream interface, part in row 1, column 2]

Parts:
C901, C902: 18p / C0G; C_0603_1608Metric; MPN CGA3E2C0G1H180JT0Y0N; LCSC C342890
C903, C904, C905, C906, C907, C908, C909, C914, C915: 100n; C_0603_1608Metric; MPN CC0603KRX7R9BB104; LCSC C14663
C910, C911, C912, C913: 1u / 50V; C_0603_1608Metric; MPN CL10A105KB8NNNC; LCSC C15849
J40: USB-C upstream; USB_C_HRO_TYPE-C-31-M-12; MPN TYPE-C-31-M-12; LCSC C165948
R901, R902, R903, R904, R905, R906, R907, R908, R909, R910, R911, R912, R913, R914, R915, R916, R917, R918, R920, R925, R926, R927, R928: 10k; R_0603_1608Metric; MPN 0603WAF1002T5E; LCSC C25804
R919: 12k / 1%; R_0603_1608Metric; MPN 0603WAF1202T5E; LCSC C22790
R921, R922: 5.1k; R_0603_1608Metric; MPN 0603WAF5101T5E; LCSC C23186
R923, R924: 100k; R_0603_1608Metric; MPN 0603WAF1003T5E; LCSC C25803
U40: USB2517-JZX; QFN-64-1EP_9x9mm_P0.5mm_EP4.7x4.7mm; MPN USB2517-JZX; LCSC C1521556
U41: TPS3808G33DBV; SOT-23-6; MPN TPS3808G33DBVR; LCSC C43698
U42: USBLC6-2SC6; SOT-23-6; MPN USBLC6-2SC6; LCSC C7519
Y40: 24MHz / CL=12pF; Crystal_SMD_3225-4Pin_3.2x2.5mm; MPN 3225 24M 12PF 10PPM; LCSC C5181479

Connections:
/GND: C901.2, C902.2, C903.2, C904.2, C905.2, C906.2, C907.2, C908.2, C909.2, C910.2, C911.2, C912.2, C913.2, C914.2, C915.2, J40.A1 (GND), J40.A12 (GND), J40.B1 (GND), J40.B12 (GND), J40.SH (SHIELD), R901.2, R902.2, R904.2, R905.2, R906.2, R907.2, R908.2, R909.2, R910.2, R911.2, R912.2, R913.2, R914.2, R919.2, R921.2, R922.2, R924.2, U40.13 (CFG2), U40.19 (TEST), U40.65 (EP_GND), U41.2 (GND), U42.2 (GND), Y40.2 (G), Y40.4 (G); also elsewhere on the board
/MCU_DM: U40.1 (DN1_DM); also elsewhere on the board
/MCU_DP: U40.2 (DN1_DP); also elsewhere on the board
/USB1_DM: U40.3 (DN2_DM); also elsewhere on the board
/USB1_DP: U40.4 (DN2_DP); also elsewhere on the board
/USB1_EN: U40.26 (PWR2); also elsewhere on the board
/USB1_OC: R925.2, U40.27 (~OC2); also elsewhere on the board
/USB2_DM: U40.6 (DN3_DM); also elsewhere on the board
/USB2_DP: U40.7 (DN3_DP); also elsewhere on the board
/USB2_EN: U40.23 (PWR3); also elsewhere on the board
/USB2_OC: R926.2, U40.22 (~OC3); also elsewhere on the board
/USB3_DM: U40.8 (DN4_DM); also elsewhere on the board
/USB3_DP: U40.9 (DN4_DP); also elsewhere on the board
/USB3_EN: U40.20 (PWR4); also elsewhere on the board
/USB3_OC: R927.2, U40.21 (~OC4); also elsewhere on the board
/USB4_DM: U40.11 (DN5_DM); also elsewhere on the board
/USB4_DP: U40.12 (DN5_DP); also elsewhere on the board
/USB4_EN: U40.30 (PWR5); also elsewhere on the board
/USB4_OC: R928.2, U40.35 (~OC5); also elsewhere on the board
/USB hub/CC1: J40.A5 (CC1), R921.1
/USB hub/CC2: J40.B5 (CC2), R922.1
/USB hub/DISABLE_53: R915.2, U40.53 (DN6_DM)
/USB hub/DISABLE_54: R916.2, U40.54 (DN6_DP)
/USB hub/DISABLE_55: R917.2, U40.55 (DN7_DM)
/USB hub/DISABLE_56: R918.2, U40.56 (DN7_DP)
/USB hub/HOST_VBUS: C915.1, J40.A4 (VBUS), J40.A9 (VBUS), J40.B4 (VBUS), J40.B9 (VBUS), R923.1, U42.5 (VBUS)
/USB hub/HUB_RESET: R920.2, U40.43 (~RESET), U41.1 (~RESET)
/USB hub/RBIAS: R919.1, U40.63 (RBIAS)
/USB hub/STRAP_15: R914.1, U40.15 (SWAP7)
/USB hub/STRAP_17: R913.1, U40.17 (SWAP6)
/USB hub/STRAP_31: R912.1, U40.31 (SWAP5)
/USB hub/STRAP_33: R911.1, U40.33 (SWAP4)
/USB hub/STRAP_34: R905.1, U40.34 (GANG_EN)
/USB hub/STRAP_40: R904.1, U40.40 (NONREM1)
/USB hub/STRAP_41: R901.1, U40.41 (CFG0)
/USB hub/STRAP_42: R902.1, U40.42 (CFG1)
/USB hub/STRAP_45: R903.2, U40.45 (NONREM0)
/USB hub/STRAP_47: R910.1, U40.47 (SWAP3)
/USB hub/STRAP_48: R907.1, U40.48 (BOOST1)
/USB hub/STRAP_49: R909.1, U40.49 (SWAP2)
/USB hub/STRAP_50: R906.1, U40.50 (BOOST0)
/USB hub/STRAP_51: R908.1, U40.51 (SWAP1)
/USB hub/UP_DM: J40.A7 (D-), J40.B7 (D-), U40.58 (UP_DM), U42.1 (I/O1), U42.6 (I/O1)
/USB hub/UP_DP: J40.A6 (D+), J40.B6 (D+), U40.59 (UP_DP), U42.3 (I/O2), U42.4 (I/O2)
/USB hub/V18_CORE: C912.1, U40.25 (VDD18)
/USB hub/V18_PLL: C913.1, U40.62 (VDD18PLL)
/USB hub/VBUS_DET: R923.2, R924.1, U40.44 (VBUS_DET)
/USB hub/XTAL1: C901.1, U40.61 (XTAL1), Y40.1
/USB hub/XTAL2: C902.1, U40.60 (XTAL2), Y40.3
/USB_ATTACH: U40.29 (PWR1); also elsewhere on the board
/V3: C903.1, C904.1, C905.1, C906.1, C907.1, C908.1, C909.1, C910.1, C911.1, C914.1, R903.1, R915.1, R916.1, R917.1, R918.1, R920.1, R925.1, R926.1, R927.1, R928.1, U40.5 (3V3_A1), U40.10 (3V3_A2), U40.24 (3V3_CORE), U40.28 (~OC1), U40.46 (3V3_IO), U40.52 (3V3_A3), U40.57 (3V3_A4), U40.64 (3V3_PLL), U41.3 (~MR), U41.5 (SENSE), U41.6 (VDD); also elsewhere on the board

Notes on the sheet:
USB HUB | USB2517 | internal port 1 + external ports 2-5; ports 6/7 disabled
Straps: CFG=000 self-powered; NONREM=01 makes port 1 permanent; individual power/OC; normal polarity. Unused ports 6/7: both D+ and D- pulled to 3V3 through 10k; PWR outputs unused, OC inputs unused. VDD18 and VDD18PLL are separate INTERNAL regulator outputs: capacitors only; do not connect them to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

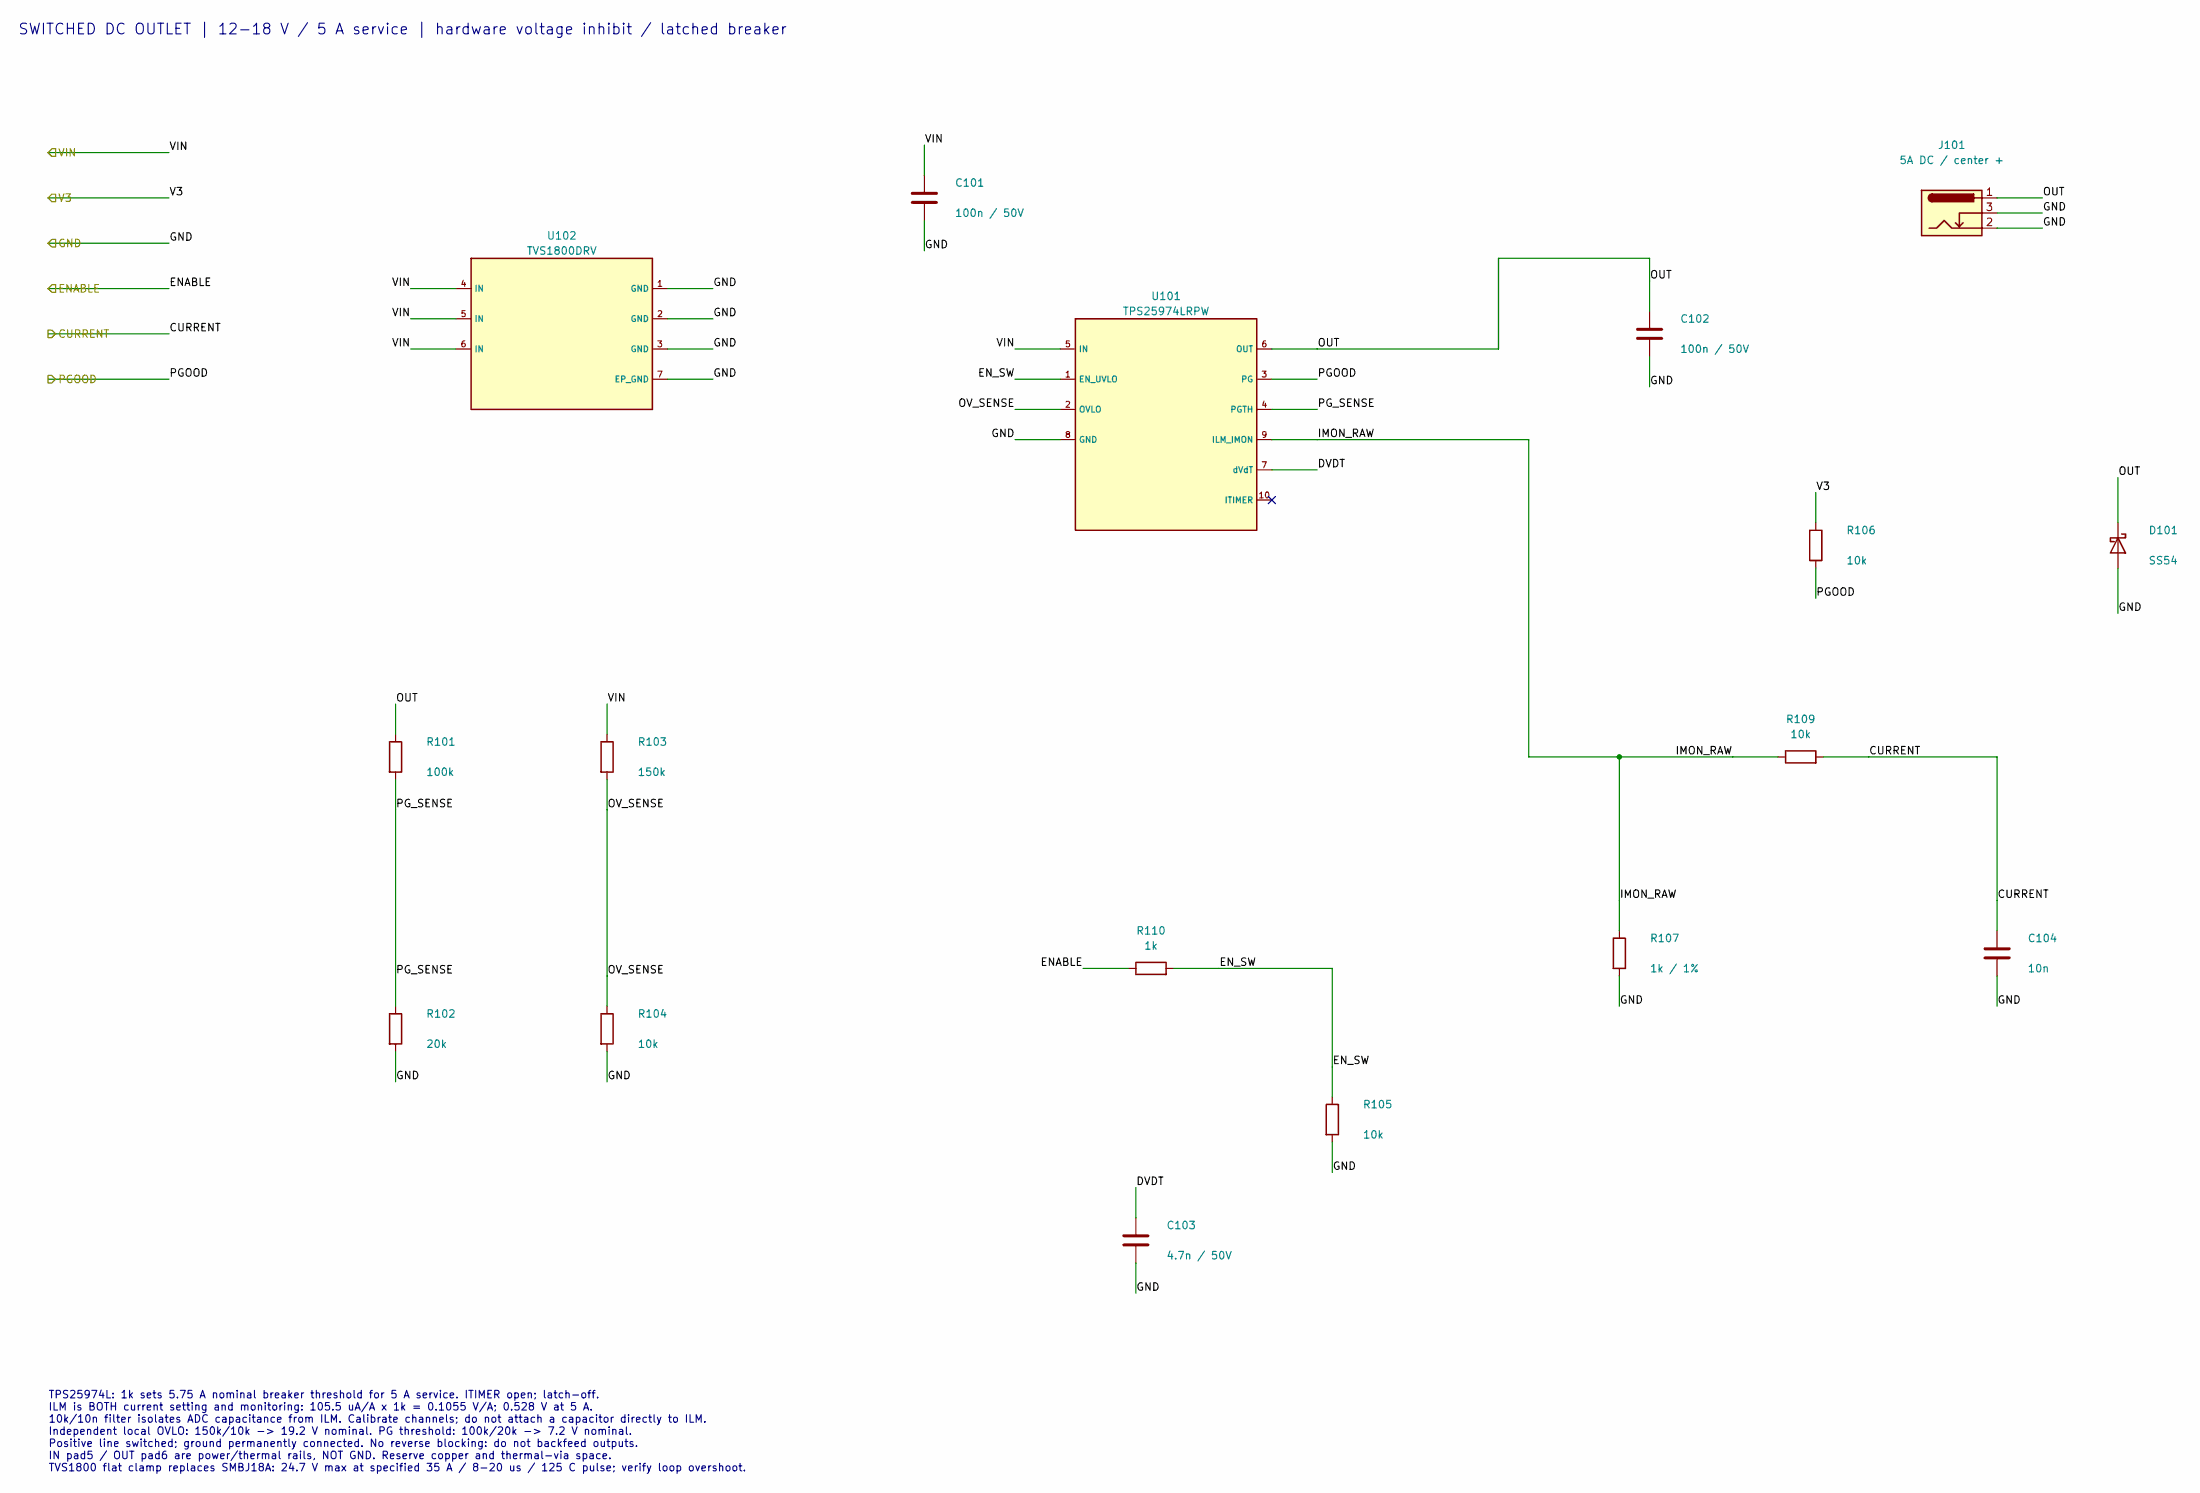
[picture p35: schematic dc_outlet.kicad_sch, PulsarPower - 5 A switched DC outlet]

Parts:
C101, C102: 100n / 50V; C_0603_1608Metric; MPN CC0603KRX7R9BB104; LCSC C14663
C103: 4.7n / 50V; C_0603_1608Metric; MPN CL10B472KB8NNNC; LCSC C1621
C104: 10n; C_0603_1608Metric; MPN CL10B103KB8NNNC; LCSC C1589
D101: SS54; D_SMA; MPN SS54; LCSC C22452
J101: 5A DC / center +; BarrelJack_XKB_DC-005K-5A_Edge; MPN DC-005K-5A-2.0; LCSC C2880546
R101: 100k; R_0603_1608Metric; MPN 0603WAF1003T5E; LCSC C25803
R102: 20k; R_0603_1608Metric; MPN 0603WAF2002T5E; LCSC C4184
R103: 150k; R_0603_1608Metric; MPN 0603WAF1503T5E; LCSC C22807
R104, R105, R106, R109: 10k; R_0603_1608Metric; MPN 0603WAF1002T5E; LCSC C25804
R107: 1k / 1%; R_0603_1608Metric; MPN 0603WAF1001T5E; LCSC C21190
R110: 1k; R_0603_1608Metric; MPN 0603WAF1001T5E; LCSC C21190
U101: TPS25974LRPW; TI_RPW0010A_VQFN10_2x2mm; MPN TPS25974LRPWR; LCSC C3662931
U102: TVS1800DRV; WSON-6-1EP_2x2mm_P0.65mm_EP1x1.6mm; MPN TVS1800DRVR; LCSC C2649846

Connections:
/DC outlet 1/DVDT: C103.1, U101.7 (dVdT)
/DC outlet 1/EN_SW: R105.1, R110.2, U101.1 (EN_UVLO)
/DC outlet 1/IMON_RAW: R107.1, R109.1, U101.9 (ILM_IMON)
/DC outlet 1/OUT: C102.1, D101.1 (K), J101.1, R101.1, U101.6 (OUT)
/DC outlet 1/OV_SENSE: R103.2, R104.1, U101.2 (OVLO)
/DC outlet 1/PG_SENSE: R101.2, R102.1, U101.4 (PGTH)
/DC_PG1: R106.2, U101.3 (PG); also elsewhere on the board
/DC_SAFE1: R110.1; also elsewhere on the board
/GND: C101.2, C102.2, C103.2, C104.2, D101.2 (A), J101.2, J101.3, R102.2, R104.2, R105.2, R107.2, U101.8 (GND), U102.1 (GND), U102.2 (GND), U102.3 (GND), U102.7 (EP_GND); also elsewhere on the board
/IMON1: C104.1, R109.2; also elsewhere on the board
/V3: R106.1; also elsewhere on the board
/VIN: C101.1, R103.1, U101.5 (IN), U102.4 (IN), U102.5 (IN), U102.6 (IN); also elsewhere on the board

Parts of its further copies:
C201, C202, C301, C302, C401, C402: 100n / 50V; C_0603_1608Metric; MPN CC0603KRX7R9BB104; LCSC C14663
C203, C303, C403: 4.7n / 50V; C_0603_1608Metric; MPN CL10B472KB8NNNC; LCSC C1621
C204, C304, C404: 10n; C_0603_1608Metric; MPN CL10B103KB8NNNC; LCSC C1589
D201, D301, D401: SS54; D_SMA; MPN SS54; LCSC C22452
J201, J301, J401: 5A DC / center +; BarrelJack_XKB_DC-005K-5A_Edge; MPN DC-005K-5A-2.0; LCSC C2880546
R201, R301, R401: 100k; R_0603_1608Metric; MPN 0603WAF1003T5E; LCSC C25803
R202, R302, R402: 20k; R_0603_1608Metric; MPN 0603WAF2002T5E; LCSC C4184
R203, R303, R403: 150k; R_0603_1608Metric; MPN 0603WAF1503T5E; LCSC C22807
R204, R205, R206, R209, R304, R305, R306, R309, R404, R405, R406, R409: 10k; R_0603_1608Metric; MPN 0603WAF1002T5E; LCSC C25804
R207, R307, R407: 1k / 1%; R_0603_1608Metric; MPN 0603WAF1001T5E; LCSC C21190
R210, R310, R410: 1k; R_0603_1608Metric; MPN 0603WAF1001T5E; LCSC C21190
U201, U301, U401: TPS25974LRPW; TI_RPW0010A_VQFN10_2x2mm; MPN TPS25974LRPWR; LCSC C3662931
U202, U302, U402: TVS1800DRV; WSON-6-1EP_2x2mm_P0.65mm_EP1x1.6mm; MPN TVS1800DRVR; LCSC C2649846

Connections of its further copies:
/DC outlet 2/DVDT: C203.1, U201.7 (dVdT)
/DC outlet 2/EN_SW: R205.1, R210.2, U201.1 (EN_UVLO)
/DC outlet 2/IMON_RAW: R207.1, R209.1, U201.9 (ILM_IMON)
/DC outlet 2/OUT: C202.1, D201.1 (K), J201.1, R201.1, U201.6 (OUT)
/DC outlet 2/OV_SENSE: R203.2, R204.1, U201.2 (OVLO)
/DC outlet 2/PG_SENSE: R201.2, R202.1, U201.4 (PGTH)
/DC outlet 3/DVDT: C303.1, U301.7 (dVdT)
/DC outlet 3/EN_SW: R305.1, R310.2, U301.1 (EN_UVLO)
/DC outlet 3/IMON_RAW: R307.1, R309.1, U301.9 (ILM_IMON)
/DC outlet 3/OUT: C302.1, D301.1 (K), J301.1, R301.1, U301.6 (OUT)
/DC outlet 3/OV_SENSE: R303.2, R304.1, U301.2 (OVLO)
/DC outlet 3/PG_SENSE: R301.2, R302.1, U301.4 (PGTH)
/DC outlet 4/DVDT: C403.1, U401.7 (dVdT)
/DC outlet 4/EN_SW: R405.1, R410.2, U401.1 (EN_UVLO)
/DC outlet 4/IMON_RAW: R407.1, R409.1, U401.9 (ILM_IMON)
/DC outlet 4/OUT: C402.1, D401.1 (K), J401.1, R401.1, U401.6 (OUT)
/DC outlet 4/OV_SENSE: R403.2, R404.1, U401.2 (OVLO)
/DC outlet 4/PG_SENSE: R401.2, R402.1, U401.4 (PGTH)
/DC_PG2: R206.2, U201.3 (PG); also elsewhere on the board
/DC_PG3: R306.2, U301.3 (PG); also elsewhere on the board
/DC_PG4: R406.2, U401.3 (PG); also elsewhere on the board
/DC_SAFE2: R210.1; also elsewhere on the board
/DC_SAFE3: R310.1; also elsewhere on the board
/DC_SAFE4: R410.1; also elsewhere on the board
/GND: C201.2, C202.2, C203.2, C204.2, C301.2, C302.2, C303.2, C304.2, C401.2, C402.2, C403.2, C404.2, D201.2 (A), D301.2 (A), D401.2 (A), J201.2, J201.3, J301.2, J301.3, J401.2, J401.3, R202.2, R204.2, R205.2, R207.2, R302.2, R304.2, R305.2, R307.2, R402.2, R404.2, R405.2, R407.2, U201.8 (GND), U202.1 (GND), U202.2 (GND), U202.3 (GND), U202.7 (EP_GND), U301.8 (GND), U302.1 (GND), U302.2 (GND), U302.3 (GND), U302.7 (EP_GND), U401.8 (GND), U402.1 (GND), U402.2 (GND), U402.3 (GND), U402.7 (EP_GND); also elsewhere on the board
/IMON2: C204.1, R209.2; also elsewhere on the board
/IMON3: C304.1, R309.2; also elsewhere on the board
/IMON4: C404.1, R409.2; also elsewhere on the board
/V3: R206.1, R306.1, R406.1; also elsewhere on the board
/VIN: C201.1, C301.1, C401.1, R203.1, R303.1, R403.1, U201.5 (IN), U202.4 (IN), U202.5 (IN), U202.6 (IN), U301.5 (IN), U302.4 (IN), U302.5 (IN), U302.6 (IN), U401.5 (IN), U402.4 (IN), U402.5 (IN), U402.6 (IN); also elsewhere on the board

Notes on the sheet:
SWITCHED DC OUTLET | 12-18 V / 5 A service | hardware voltage inhibit / latched breaker
TPS25974L: 1k sets 5.75 A nominal breaker threshold for 5 A service. ITIMER open; latch-off. ILM is BOTH current setting and monitoring: 105.5 uA/A x 1k = 0.1055 V/A; 0.528 V at 5 A. 10k/10n filter isolates ADC capacitance from ILM. Calibrate channels; do not attach a capacitor directly to ILM. Ind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

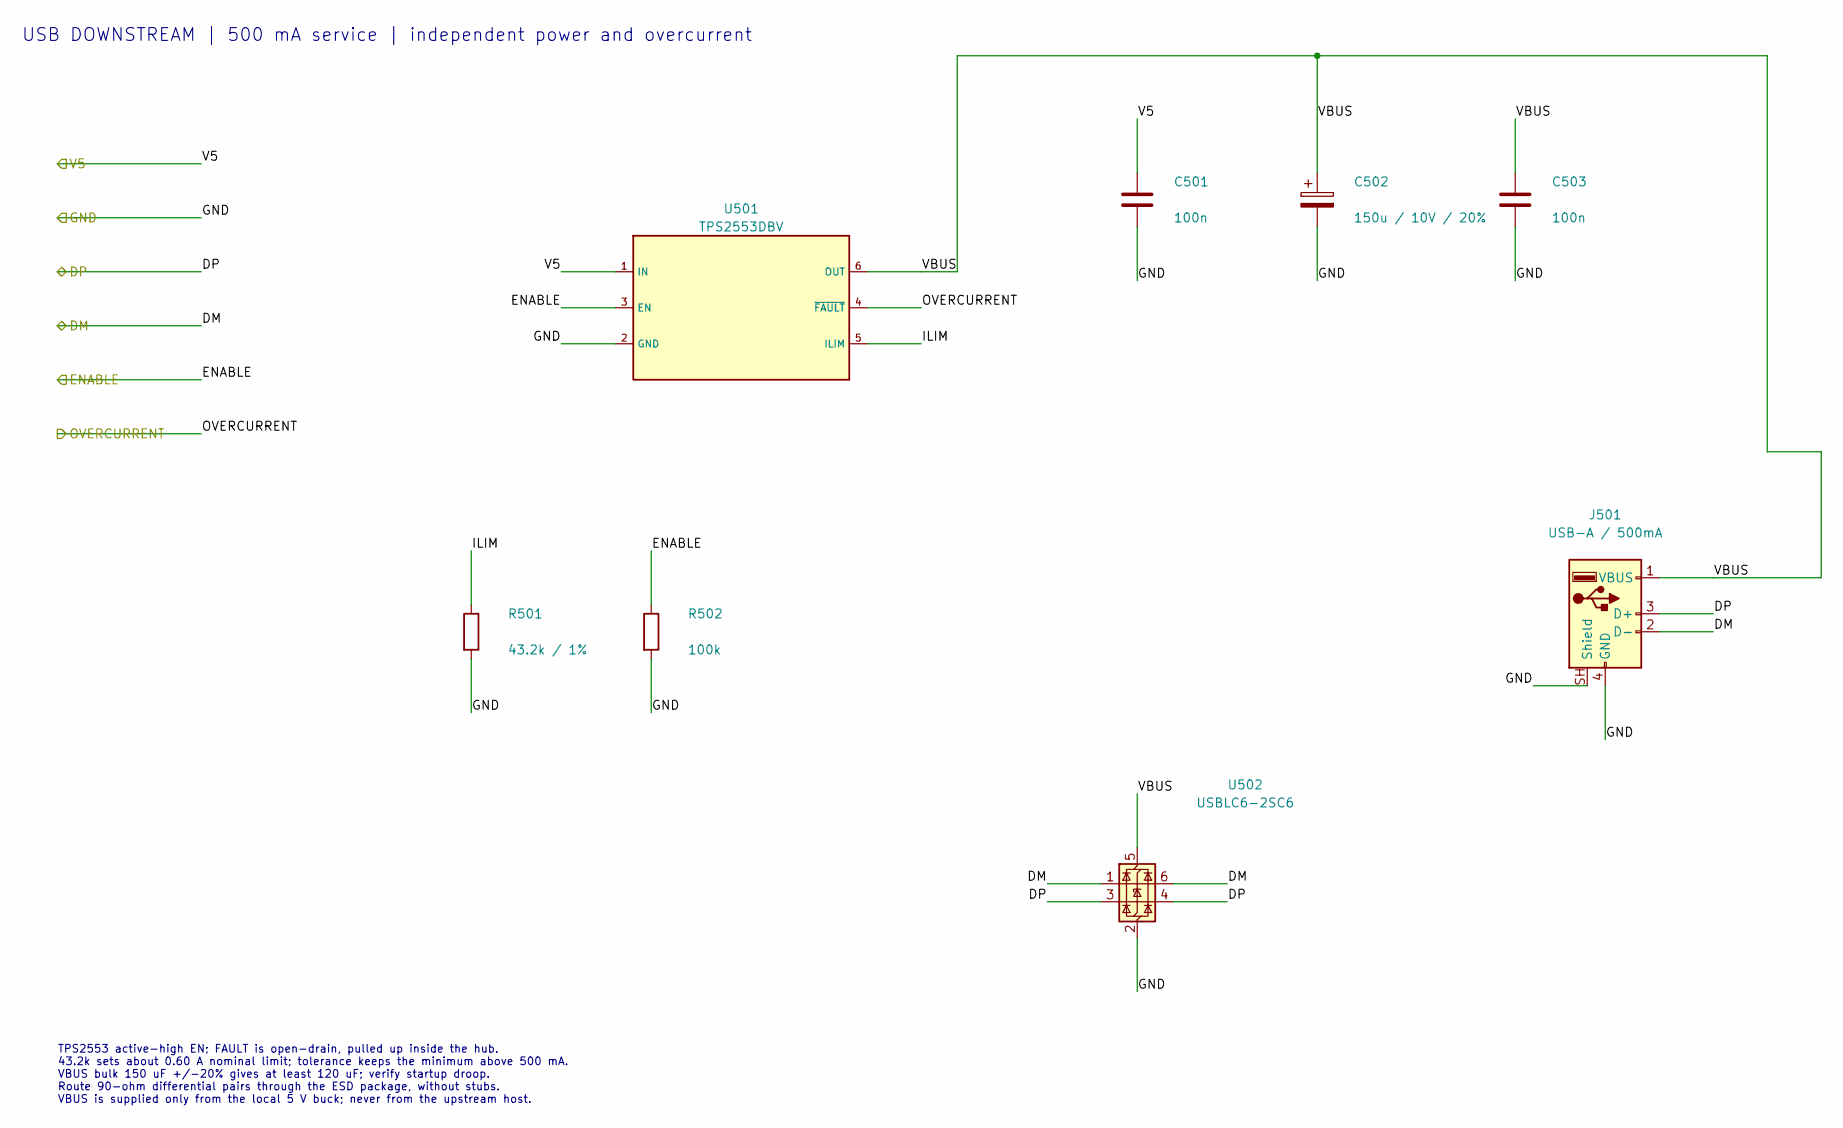
[picture p36: schematic usb_port.kicad_sch, PulsarPower - USB 2.0 downstream port]

Parts:
C501, C503: 100n; C_0603_1608Metric; MPN CC0603KRX7R9BB104; LCSC C14663
C502: 150u / 10V / 20%; CP_RVT_D6.3mm_L5.4mm; MPN RVT1A151M0605 150UF 10V; LCSC C970688
J501: USB-A / 500mA; USB_A_SHOUHAN_AF90ZJWG_THT; MPN AF 90 ZJWG; LCSC C456019
R501: 43.2k / 1%; R_0603_1608Metric; MPN 0603WAF4322T5E; LCSC C23053
R502: 100k; R_0603_1608Metric; MPN 0603WAF1003T5E; LCSC C25803
U501: TPS2553DBV; SOT-23-6; MPN TPS2553DBVR; LCSC C55266
U502: USBLC6-2SC6; SOT-23-6; MPN USBLC6-2SC6; LCSC C7519

Connections:
/GND: C501.2, C502.2, C503.2, J501.4 (GND), J501.SH (Shield), R501.2, R502.2, U501.2 (GND), U502.2 (GND); also elsewhere on the board
/USB1_DM: J501.2 (D-), U502.1 (I/O1), U502.6 (I/O1); also elsewhere on the board
/USB1_DP: J501.3 (D+), U502.3 (I/O2), U502.4 (I/O2); also elsewhere on the board
/USB1_EN: R502.1, U501.3 (EN); also elsewhere on the board
/USB1_OC: U501.4 (~FAULT); also elsewhere on the board
/USB port 1/ILIM: R501.1, U501.5 (ILIM)
/USB port 1/VBUS: C502.1, C503.1, J501.1 (VBUS), U501.6 (OUT), U502.5 (VBUS)
/V5: C501.1, U501.1 (IN); also elsewhere on the board

Parts of its further copies:
C601, C603, C701, C703, C801, C803: 100n; C_0603_1608Metric; MPN CC0603KRX7R9BB104; LCSC C14663
C602, C702, C802: 150u / 10V / 20%; CP_RVT_D6.3mm_L5.4mm; MPN RVT1A151M0605 150UF 10V; LCSC C970688
J601, J701, J801: USB-A / 500mA; USB_A_SHOUHAN_AF90ZJWG_THT; MPN AF 90 ZJWG; LCSC C456019
R601, R701, R801: 43.2k / 1%; R_0603_1608Metric; MPN 0603WAF4322T5E; LCSC C23053
R602, R702, R802: 100k; R_0603_1608Metric; MPN 0603WAF1003T5E; LCSC C25803
U601, U701, U801: TPS2553DBV; SOT-23-6; MPN TPS2553DBVR; LCSC C55266
U602, U702, U802: USBLC6-2SC6; SOT-23-6; MPN USBLC6-2SC6; LCSC C7519

Connections of its further copies:
/GND: C601.2, C602.2, C603.2, C701.2, C702.2, C703.2, C801.2, C802.2, C803.2, J601.4 (GND), J601.SH (Shield), J701.4 (GND), J701.SH (Shield), J801.4 (GND), J801.SH (Shield), R601.2, R602.2, R701.2, R702.2, R801.2, R802.2, U601.2 (GND), U602.2 (GND), U701.2 (GND), U702.2 (GND), U801.2 (GND), U802.2 (GND); also elsewhere on the board
/USB2_DM: J601.2 (D-), U602.1 (I/O1), U602.6 (I/O1); also elsewhere on the board
/USB2_DP: J601.3 (D+), U602.3 (I/O2), U602.4 (I/O2); also elsewhere on the board
/USB2_EN: R602.1, U601.3 (EN); also elsewhere on the board
/USB2_OC: U601.4 (~FAULT); also elsewhere on the board
/USB3_DM: J701.2 (D-), U702.1 (I/O1), U702.6 (I/O1); also elsewhere on the board
/USB3_DP: J701.3 (D+), U702.3 (I/O2), U702.4 (I/O2); also elsewhere on the board
/USB3_EN: R702.1, U701.3 (EN); also elsewhere on the board
/USB3_OC: U701.4 (~FAULT); also elsewhere on the board
/USB4_DM: J801.2 (D-), U802.1 (I/O1), U802.6 (I/O1); also elsewhere on the board
/USB4_DP: J801.3 (D+), U802.3 (I/O2), U802.4 (I/O2); also elsewhere on the board
/USB4_EN: R802.1, U801.3 (EN); also elsewhere on the board
/USB4_OC: U801.4 (~FAULT); also elsewhere on the board
/USB port 2/ILIM: R601.1, U601.5 (ILIM)
/USB port 2/VBUS: C602.1, C603.1, J601.1 (VBUS), U601.6 (OUT), U602.5 (VBUS)
/USB port 3/ILIM: R701.1, U701.5 (ILIM)
/USB port 3/VBUS: C702.1, C703.1, J701.1 (VBUS), U701.6 (OUT), U702.5 (VBUS)
/USB port 4/ILIM: R801.1, U801.5 (ILIM)
/USB port 4/VBUS: C802.1, C803.1, J801.1 (VBUS), U801.6 (OUT), U802.5 (VBUS)
/V5: C601.1, C701.1, C801.1, U601.1 (IN), U701.1 (IN), U801.1 (IN); also elsewhere on the board

Notes on the sheet:
USB DOWNSTREAM | 500 mA service | independent power and overcurrent
TPS2553 active-high EN; FAULT is open-drain, pulled up inside the hub. 43.2k sets about 0.60 A nominal limit; tolerance keeps the minimum above 500 mA. VBUS bulk 150 uF +/-20% gives at least 120 uF; verify startup droop. Route 90-ohm differential pairs through the ESD package, without stubs. VBUS i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
