pulsarfab/pulsarfab/hardware/pulsardewhub/pulsardewhub.kicad_pcb

## KiCad design hardware/pulsardewhub/pulsardewhub.kicad_pcb (continued)

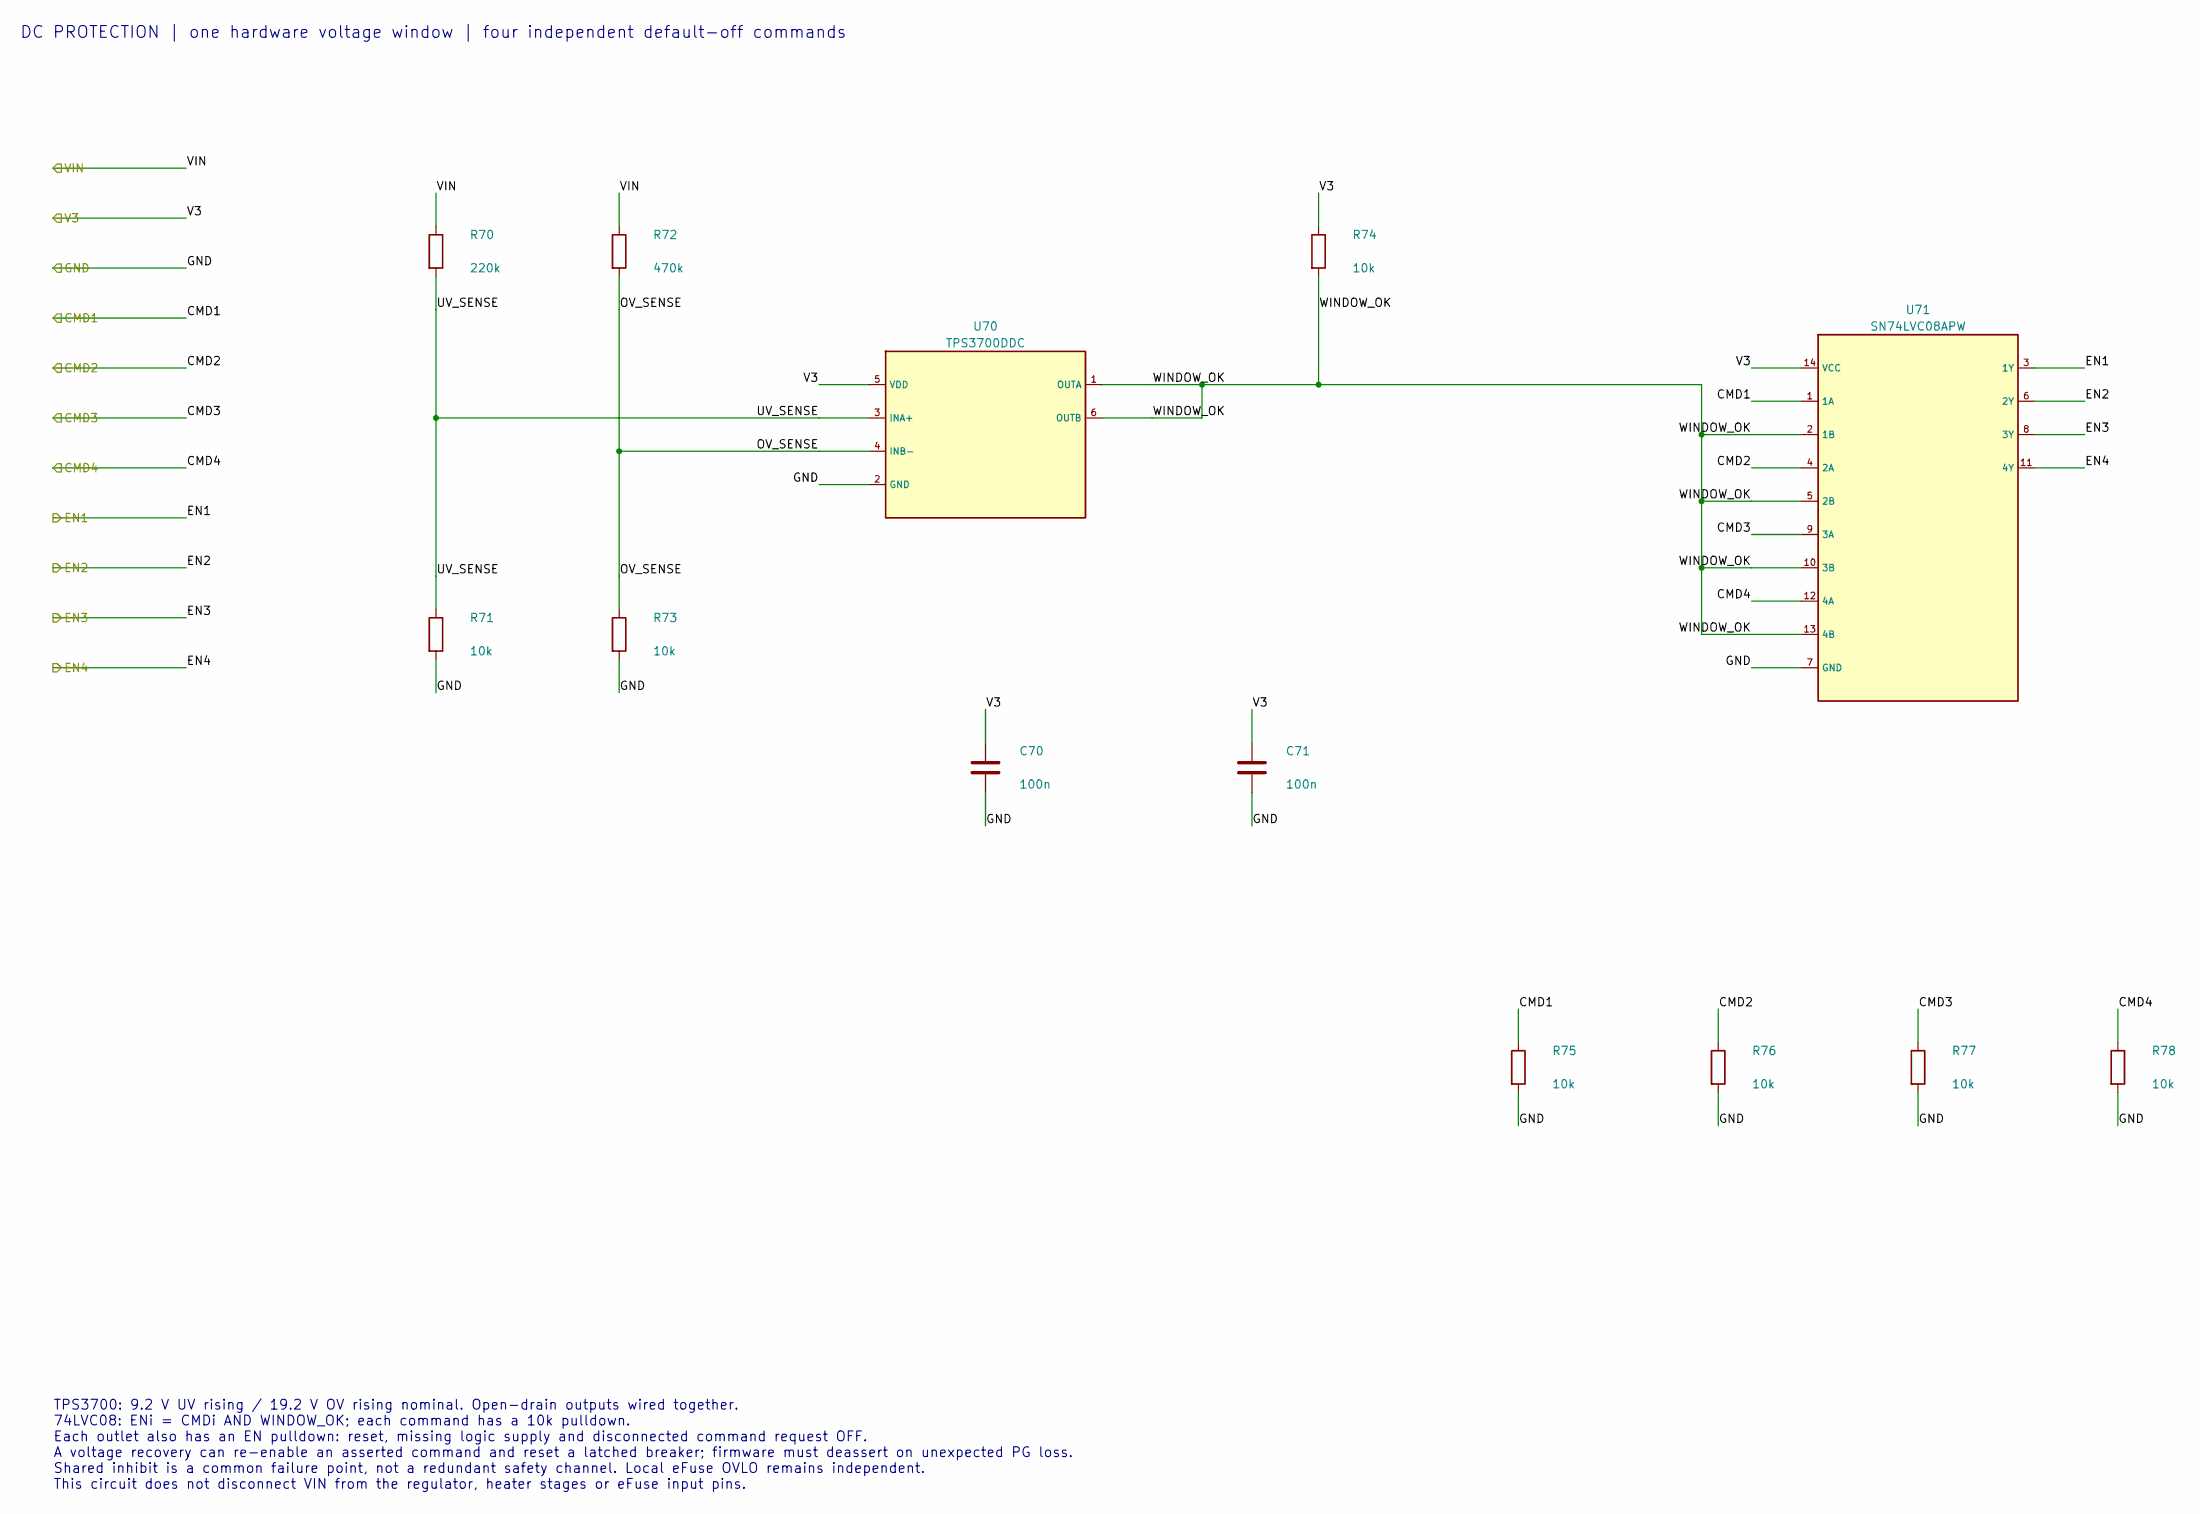
[picture p37: schematic dc_protection.kicad_sch, PulsarPower - Shared outlet voltage window and enable gates]

Parts:
C70, C71: 100n; C_0603_1608Metric; MPN CC0603KRX7R9BB104; LCSC C14663
R70: 220k; R_0603_1608Metric; MPN 0603WAF2203T5E; LCSC C22961
R71, R73, R74, R75, R76, R77, R78: 10k; R_0603_1608Metric; MPN 0603WAF1002T5E; LCSC C25804
R72: 470k; R_0603_1608Metric; MPN 0603WAF4703T5E; LCSC C23178
U70: TPS3700DDC; SOT-23-6; MPN TPS3700DDCR; LCSC C33002
U71: SN74LVC08APW; TSSOP-14_4.4x5mm_P0.65mm; MPN SN74LVC08APWR; LCSC C465737

Connections:
/DC protection/OV_SENSE: R72.2, R73.1, U70.4 (INB-)
/DC protection/UV_SENSE: R70.2, R71.1, U70.3 (INA+)
/DC protection/WINDOW_OK: R74.2, U70.1 (OUTA), U70.6 (OUTB), U71.2 (1B), U71.5 (2B), U71.10 (3B), U71.13 (4B)
/DC_EN1: R75.1, U71.1 (1A); also elsewhere on the board
/DC_EN2: R76.1, U71.4 (2A); also elsewhere on the board
/DC_EN3: R77.1, U71.9 (3A); also elsewhere on the board
/DC_EN4: R78.1, U71.12 (4A); also elsewhere on the board
/DC_SAFE1: U71.3 (1Y); also elsewhere on the board
/DC_SAFE2: U71.6 (2Y); also elsewhere on the board
/DC_SAFE3: U71.8 (3Y); also elsewhere on the board
/DC_SAFE4: U71.11 (4Y); also elsewhere on the board
/GND: C70.2, C71.2, R71.2, R73.2, R75.2, R76.2, R77.2, R78.2, U70.2 (GND), U71.7 (GND); also elsewhere on the board
/V3: C70.1, C71.1, R74.1, U70.5 (VDD), U71.14 (VCC); also elsewhere on the board
/VIN: R70.1, R72.1; also elsewhere on the board

Notes on the sheet:
DC PROTECTION | one hardware voltage window | four independent default-off commands
TPS3700: 9.2 V UV rising / 19.2 V OV rising nominal. Open-drain outputs wired together. 74LVC08: ENi = CMDi AND WINDOW_OK; each command has a 10k pulldown. Each outlet also has an EN pulldown: reset, missing logic supply and disconnected command request OFF. A voltage recovery can re-enable an asse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

Board: 4 copper layers, 233 parts (0 on the bottom side), 133 nets, no tracks yet.

Other parts of the board:
FID1, FID2, FID3: Fiducial; Fiducial_1mm_Mask2mm
H1, H2, H3, H4: M3; MountingHole_3.2mm_M3
