pulsarfab/pulsarfab/hardware/pulsardew/pulsardew.kicad_pcb

## KiCad design hardware/pulsardew/pulsardew.kicad_pcb (2026-10-04)

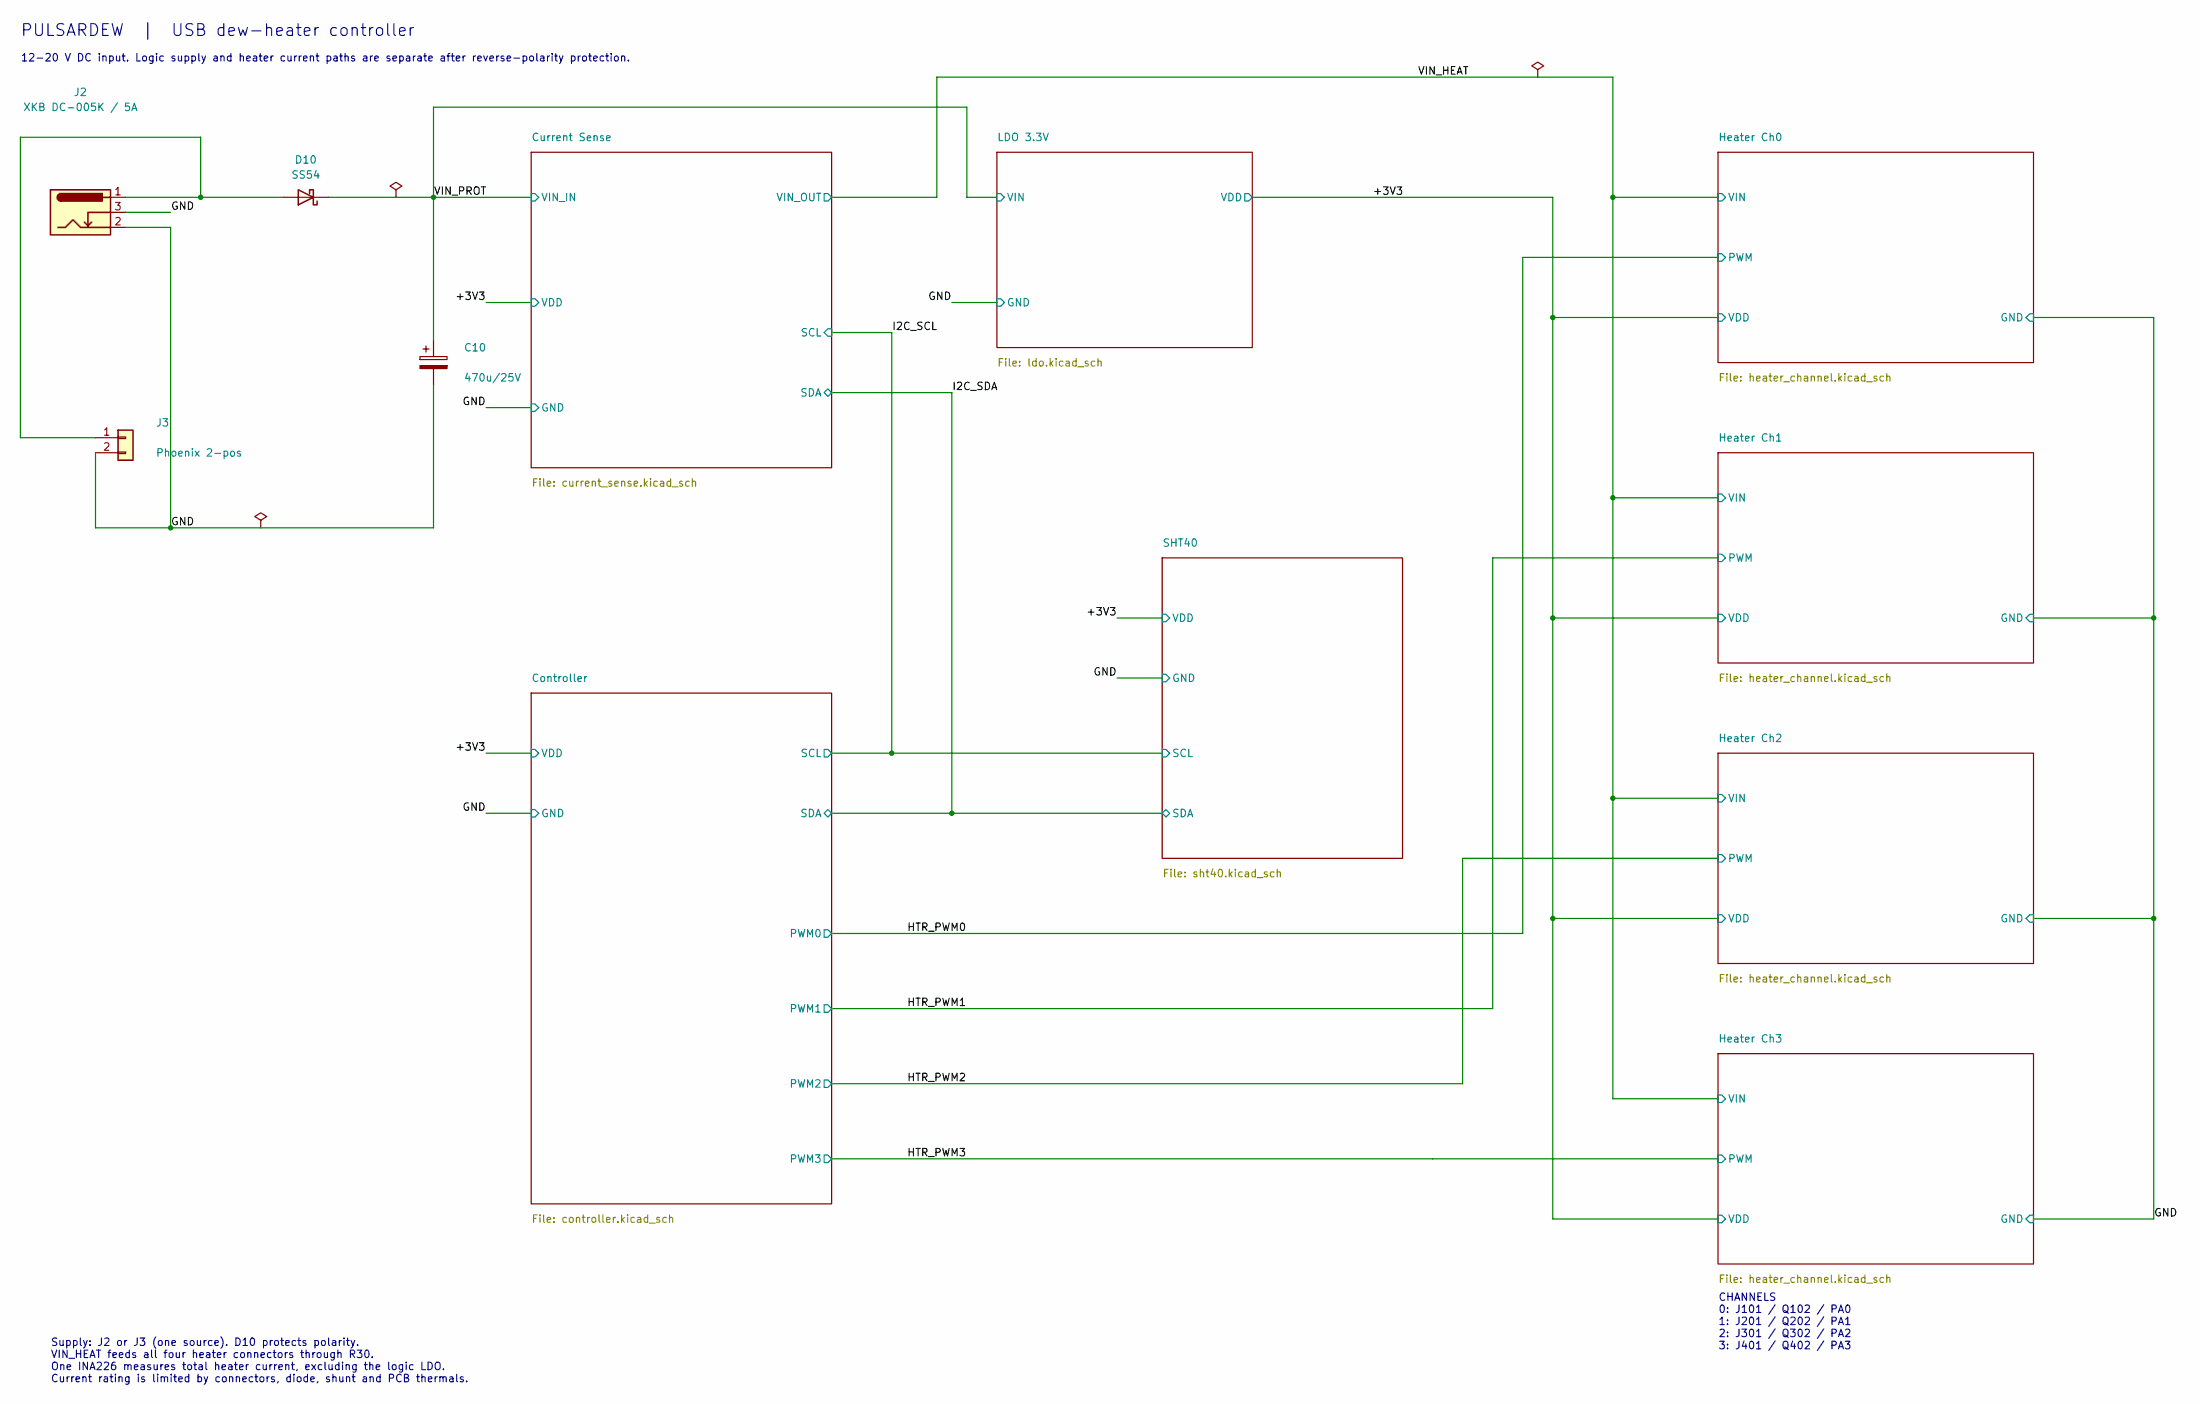
[picture p38: schematic pulsardew.kicad_sch, PulsarDew - System wiring]

Parts:
C10: 470u/25V; CP_Elec_8x10.5
D10: SS54; D_SMA_Handsoldering; MPN SS54; LCSC C22452
J2: XKB DC-005K / 5A; BarrelJack_XKB_DC-005K-5A_Edge; MPN DC-005K-5A-2.0; LCSC C2880546
J3: Phoenix 2-pos; TerminalBlock_Phoenix_MKDS-1,5-2-5.08_1x02_P5.08mm_Horizont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

Connections:
/GND: C10.2, J2.2, J2.3, J3.2; also elsewhere on the board
/VIN_PROT: C10.1, D10.1 (K); also elsewhere on the board
unnamed: D10.2 (A), J2.1, J3.1

Notes on the sheet:
PULSARDEW | USB dew-heater controller
12-20 V DC input. Logic supply and heater current paths are separate after reverse-polarity protection.
Supply: J2 or J3 (one source). D10 protects polarity. VIN_HEAT feeds all four heater connectors through R30. One INA226 measures total heater current, excluding the logic LDO. Current rating is limited by connectors, diode, shunt and PCB thermals.
CHANNELS 0: J101 / Q102 / PA0 1: J201 / Q202 / PA1 2: J301 / Q302 / PA2 3: J401 / Q402 / PA3

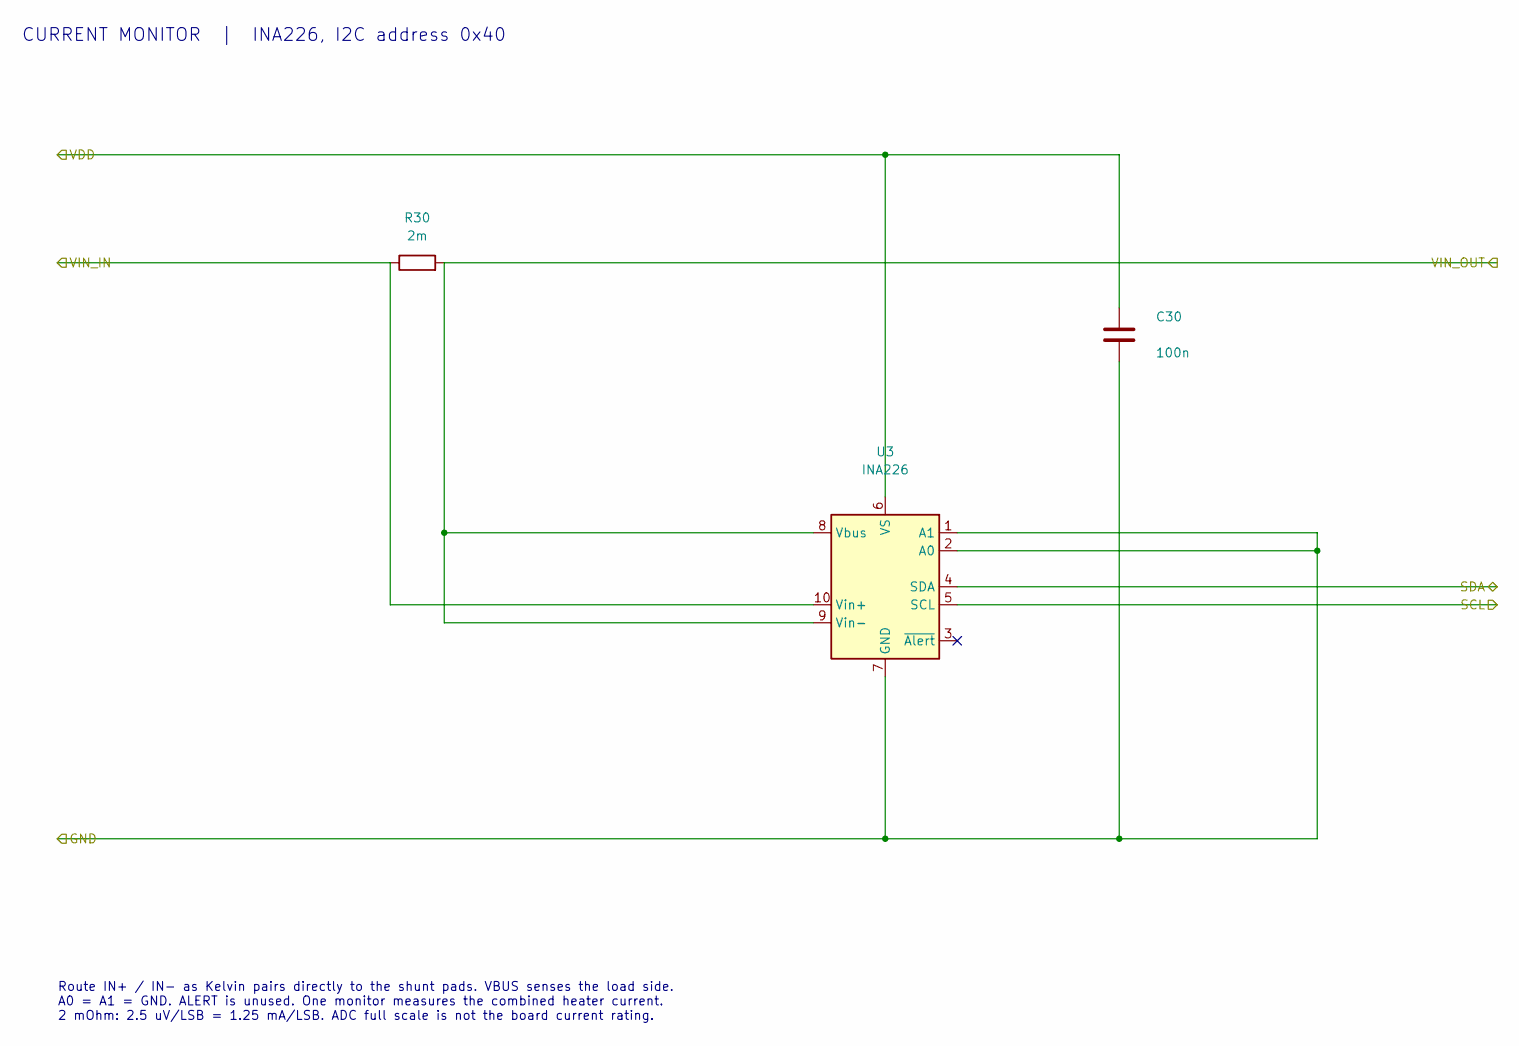
[picture p39: schematic current_sense.kicad_sch, PulsarDew - Input current monitor]

Parts:
C30: 100n; C_0402_1005Metric
R30: 2m; R_2512_6332Metric; MPN RLP25FEGR002; LCSC C459679
U3: INA226; TSSOP-10_3x3mm_P0.5mm; MPN INA226AIDGSR; LCSC C49851

Connections:
/+3V3: C30.1, U3.6 (VS); also elsewhere on the board
/GND: C30.2, U3.1 (A1), U3.2 (A0), U3.7 (GND); also elsewhere on the board
/I2C_SCL: U3.5 (SCL); also elsewhere on the board
/I2C_SDA: U3.4 (SDA); also elsewhere on the board
/VIN_HEAT: R30.2, U3.8 (Vbus), U3.9 (Vin-); also elsewhere on the board
/VIN_PROT: R30.1, U3.10 (Vin+); also elsewhere on the board

Notes on the sheet:
CURRENT MONITOR | INA226, I2C address 0x40
Route IN+ / IN- as Kelvin pairs directly to the shunt pads. VBUS senses the load side. A0 = A1 = GND. ALERT is unused. One monitor measures the combined heater current. 2 mOhm: 2.5 uV/LSB = 1.25 mA/LSB. ADC full scale is not the board current rating.

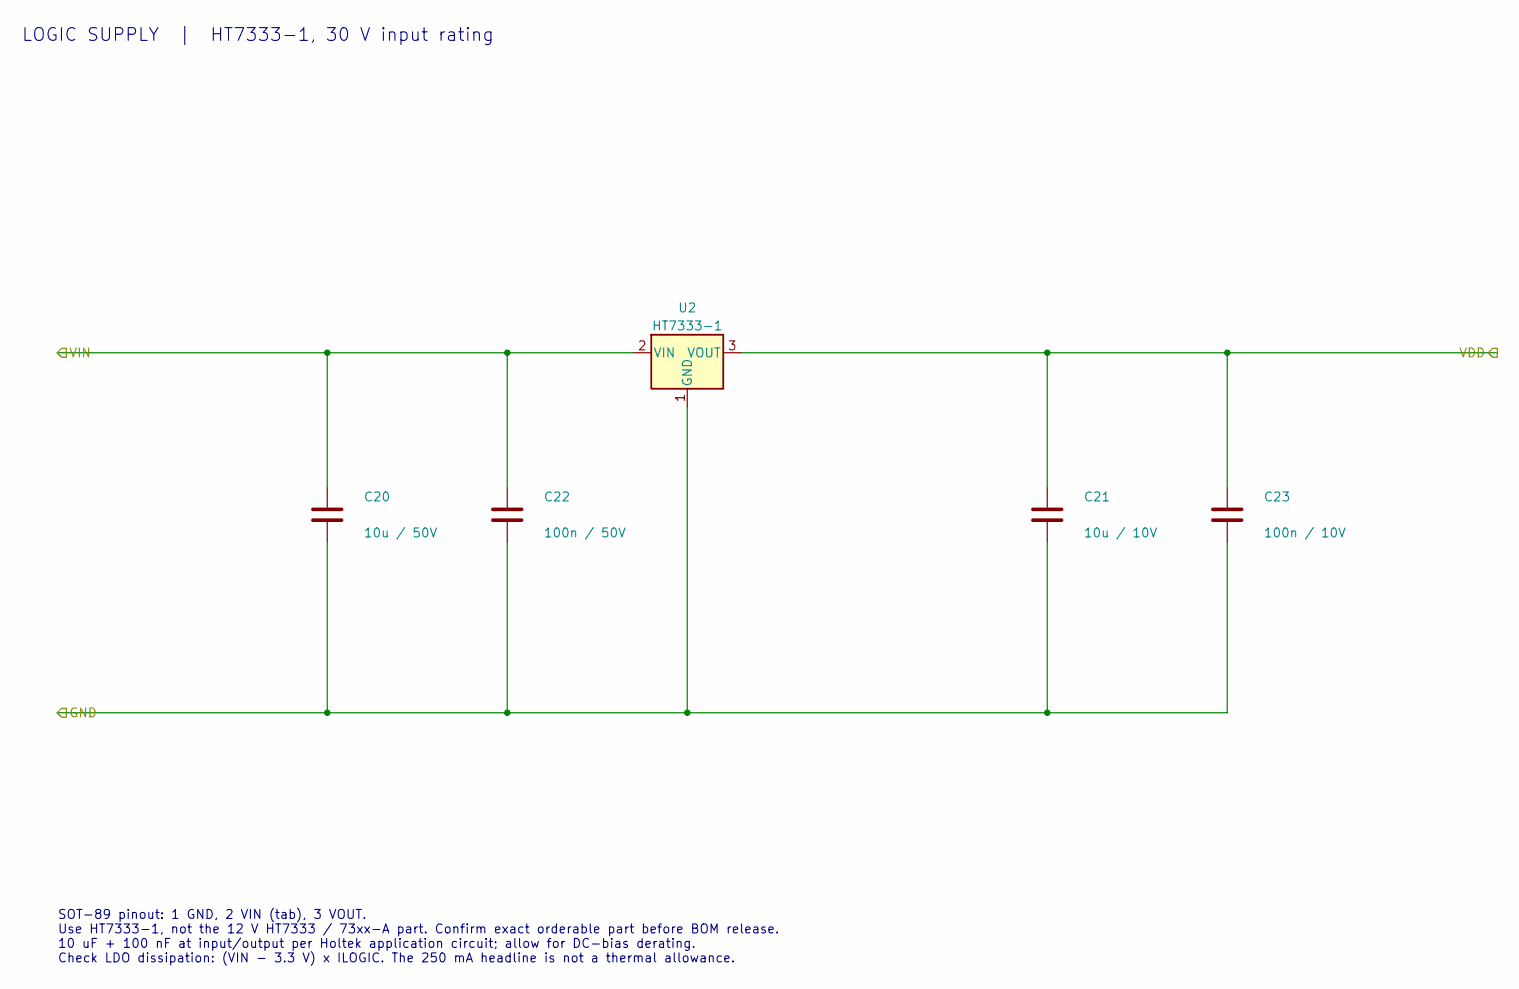
[picture p40: schematic ldo.kicad_sch, PulsarDew - 3.3V logic supply]

Parts:
C20: 10u / 50V; C_1210_3225Metric
C21: 10u / 10V; C_0805_2012Metric
C22: 100n / 50V; C_0603_1608Metric
C23: 100n / 10V; C_0402_1005Metric
U2: HT7333-1; SOT-89-3; MPN HT7333-1

Connections:
/+3V3: C21.1, C23.1, U2.3 (VOUT); also elsewhere on the board
/GND: C20.2, C21.2, C22.2, C23.2, U2.1 (GND); also elsewhere on the board
/VIN_PROT: C20.1, C22.1, U2.2 (VIN); also elsewhere on the board

Notes on the sheet:
LOGIC SUPPLY | HT7333-1, 30 V input rating
SOT-89 pinout: 1 GND, 2 VIN (tab), 3 VOUT. Use HT7333-1, not the 12 V HT7333 / 73xx-A part. Confirm exact orderable part before BOM release. 10 uF + 100 nF at input/output per Holtek application circuit; allow for DC-bias derating. Check LDO dissipation: (VIN - 3.3 V) x ILOGIC. The 250 mA headline 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

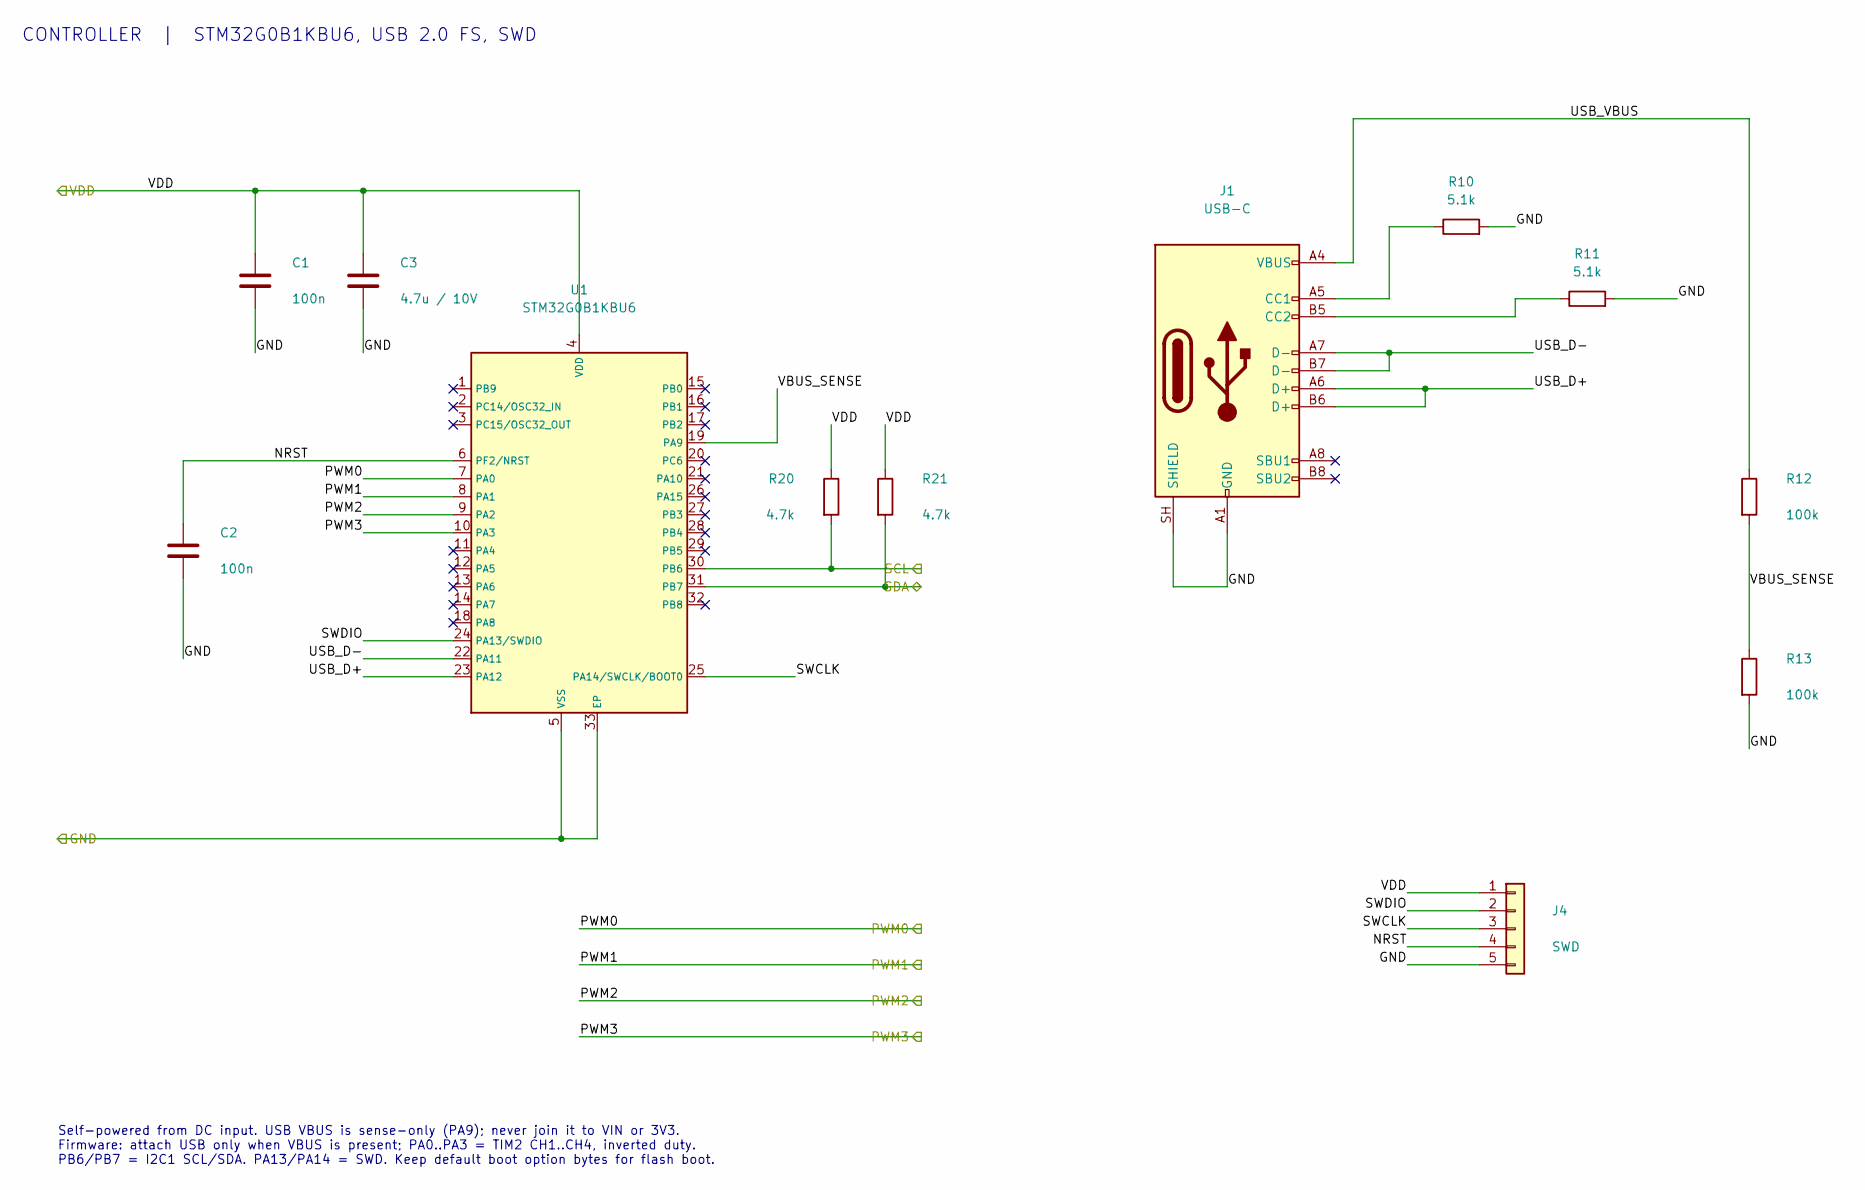
[picture p41: schematic controller.kicad_sch, PulsarDew - MCU, USB and debug]

Parts:
C1, C2: 100n; C_0402_1005Metric
C3: 4.7u / 10V; C_0402_1005Metric
J1: USB-C; USB_C_HRO_TYPE-C-31-M-12; MPN TYPE-C-31-M-12; LCSC C165948
J4: SWD; PinHeader_1x05_P2.54mm_Vertical
R10, R11: 5.1k; R_0402_1005Metric
R12, R13: 100k; R_0402_1005Metric
R20, R21: 4.7k; R_0402_1005Metric
U1: STM32G0B1KBU6; UFQFPN-32-1EP_5x5mm_P0.5mm_EP3.5x3.5mm; MPN STM32G0B1KBU6; LCSC C5159549

Connections:
/+3V3: C1.1, C3.1, J4.1, R20.1, R21.1, U1.4 (VDD); also elsewhere on the board
/Controller/NRST: C2.1, J4.4, U1.6 (PF2/NRST)
/Controller/SWCLK: J4.3, U1.25 (PA14/SWCLK/BOOT0)
/Controller/SWDIO: J4.2, U1.24 (PA13/SWDIO)
/Controller/USB_D+: J1.A6 (D+), J1.B6 (D+), U1.23 (PA12)
/Controller/USB_D-: J1.A7 (D-), J1.B7 (D-), U1.22 (PA11)
/Controller/USB_VBUS: J1.A4 (VBUS), J1.A9 (VBUS), J1.B4 (VBUS), J1.B9 (VBUS), R12.1
/Controller/VBUS_SENSE: R12.2, R13.1, U1.19 (PA9)
/GND: C1.2, C2.2, C3.2, J1.A1 (GND), J1.A12 (GND), J1.B1 (GND), J1.B12 (GND), J1.SH (SHIELD), J4.5, R10.2, R11.2, R13.2, U1.5 (VSS), U1.33 (EP); also elsewhere on the board
/HTR_PWM0: U1.7 (PA0); also elsewhere on the board
/HTR_PWM1: U1.8 (PA1); also elsewhere on the board
/HTR_PWM2: U1.9 (PA2); also elsewhere on the board
/HTR_PWM3: U1.10 (PA3); also elsewhere on the board
/I2C_SCL: R20.2, U1.30 (PB6); also elsewhere on the board
/I2C_SDA: R21.2, U1.31 (PB7); also elsewhere on the board
unnamed: J1.A5 (CC1), R10.1
unnamed: J1.B5 (CC2), R11.1

Notes on the sheet:
CONTROLLER | STM32G0B1KBU6, USB 2.0 FS, SWD
Self-powered from DC input. USB VBUS is sense-only (PA9); never join it to VIN or 3V3. Firmware: attach USB only when VBUS is present; PA0..PA3 = TIM2 CH1..CH4, inverted duty. PB6/PB7 = I2C1 SCL/SDA. PA13/PA14 = SWD. Keep default boot option bytes for flash boot.

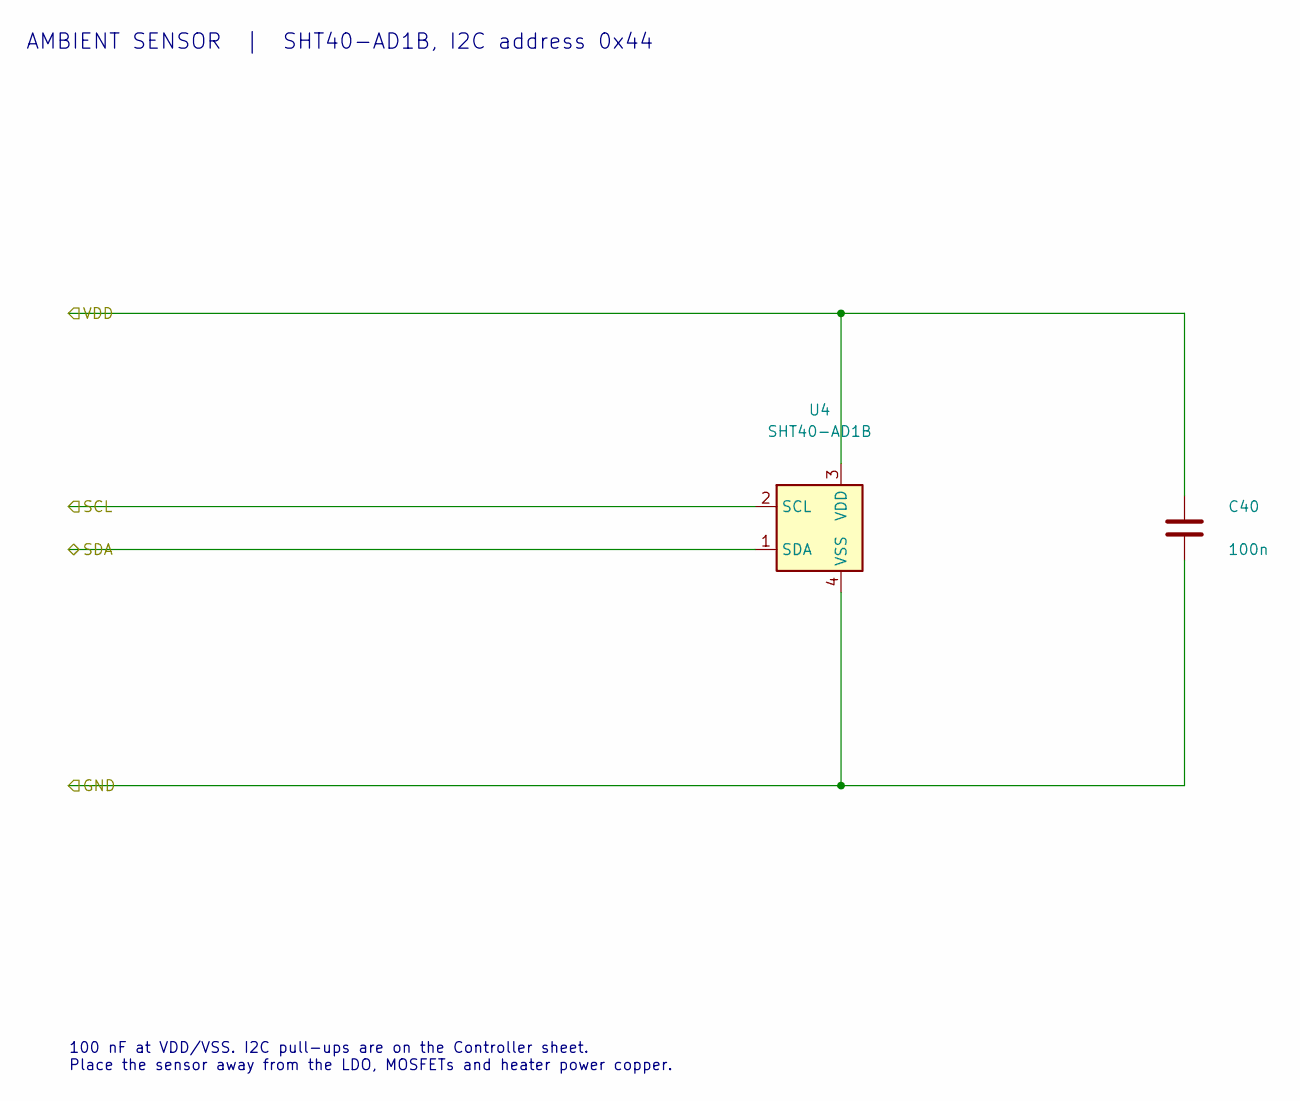
[picture p42: schematic sht40.kicad_sch, PulsarDew - Temperature and humidity]

Parts:
C40: 100n; C_0402_1005Metric
U4: SHT40-AD1B; Sensirion_DFN-4_1.5x1.5mm_P0.8mm_SHT4x_NoCentralPad; MPN SHT40-AD1B-R2; LCSC C2909890

Connections:
/+3V3: C40.1, U4.3 (VDD); also elsewhere on the board
/GND: C40.2, U4.4 (VSS); also elsewhere on the board
/I2C_SCL: U4.2 (SCL); also elsewhere on the board
/I2C_SDA: U4.1 (SDA); also elsewhere on the board

Notes on the sheet:
AMBIENT SENSOR | SHT40-AD1B, I2C address 0x44
100 nF at VDD/VSS. I2C pull-ups are on the Controller sheet. Place the sensor away from the LDO, MOSFETs and heater power copper.

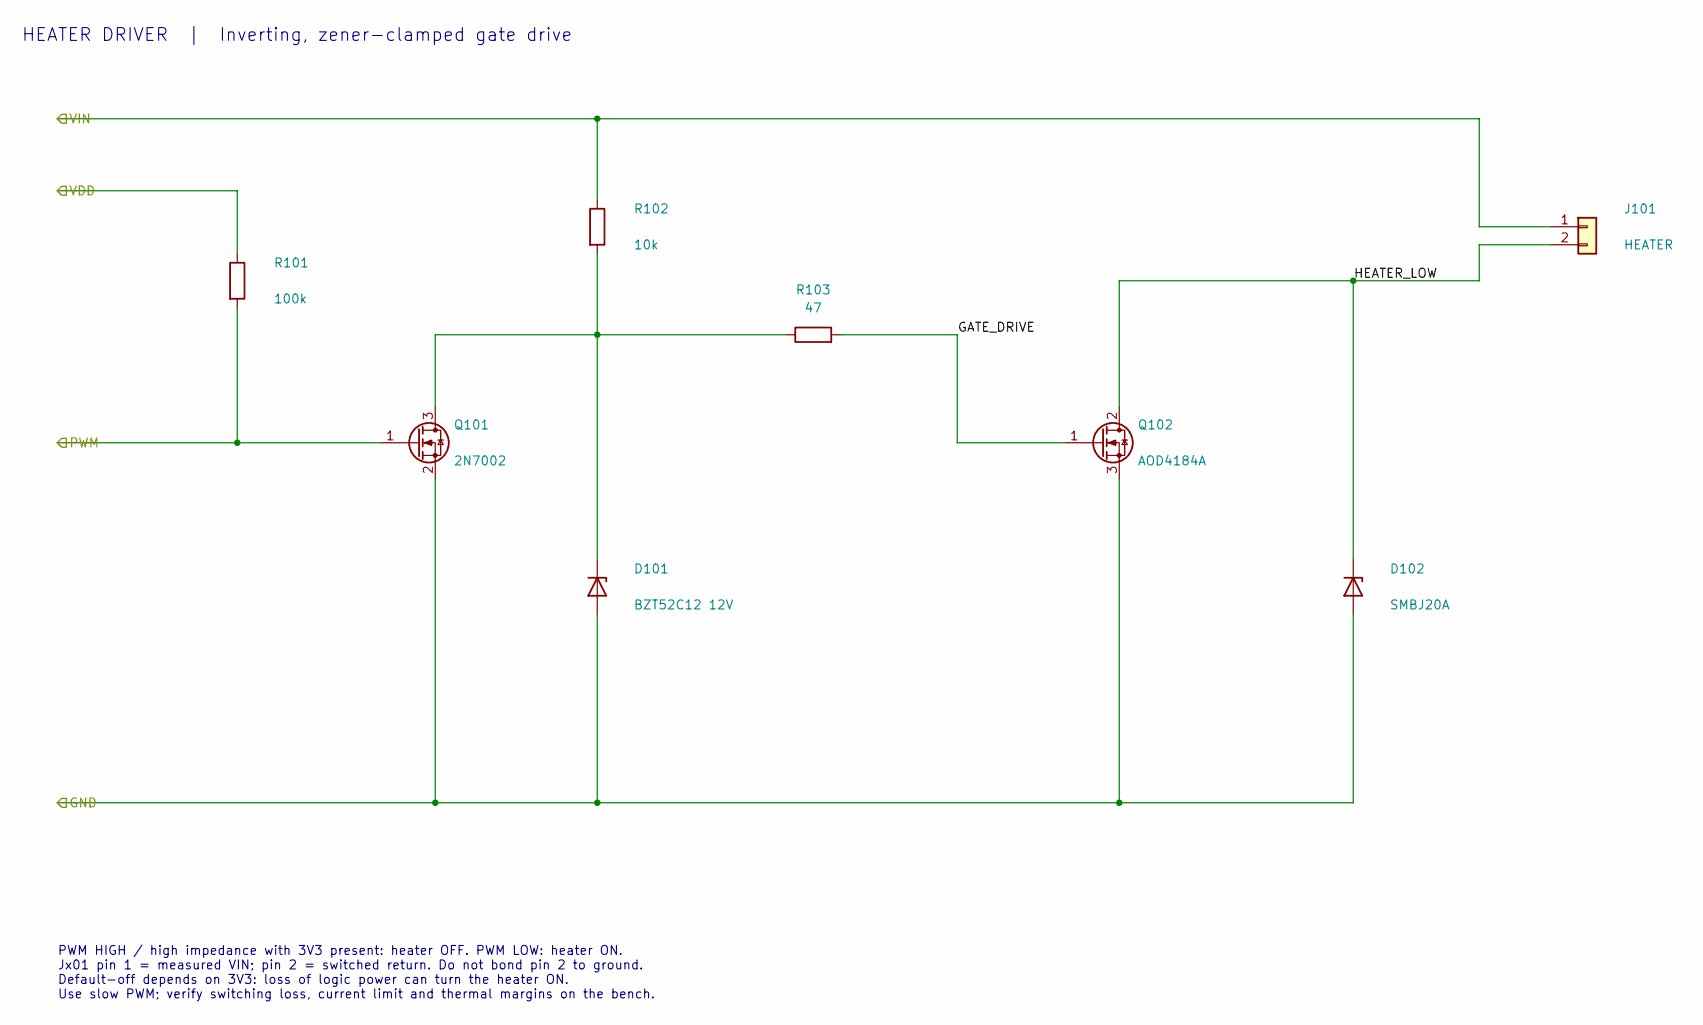
[picture p43: schematic heater_channel.kicad_sch, PulsarDew - Heater driver (active-low PWM)]

Parts:
D101: BZT52C12 12V; D_SOD-123; MPN BZT52C12; LCSC C19077410
D102: SMBJ20A; D_SMB_Handsoldering; MPN SMBJ20A; LCSC C364296
J101: HEATER; TerminalBlock_Phoenix_MKDS-1,5-2-5.08_1x02_P5.08mm_Horizont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
Q101: 2N7002; SOT-23; MPN 2N7002; LCSC C8545
Q102: AOD4184A; TO-252-2; MPN AOD4184A; LCSC C5370959
R101: 100k; R_0402_1005Metric
R102: 10k; R_0402_1005Metric
R103: 47; R_0402_1005Metric

Connections:
/+3V3: R101.1; also elsewhere on the board
/GND: D101.2 (A), D102.2 (A), Q101.2 (S), Q102.3 (S); also elsewhere on the board
/HTR_PWM0: Q101.1 (G), R101.2; also elsewhere on the board
/Heater Ch0/GATE_DRIVE: Q102.1 (G), R103.2
/Heater Ch0/HEATER_LOW: D102.1 (K), J101.2, Q102.2 (D)
/VIN_HEAT: J101.1, R102.1; also elsewhere on the board
unnamed: D101.1 (K), Q101.3 (D), R102.2, R103.1

Parts of its further copies:
D201, D301, D401: BZT52C12 12V; D_SOD-123; MPN BZT52C12; LCSC C19077410
D202, D302, D402: SMBJ20A; D_SMB_Handsoldering; MPN SMBJ20A; LCSC C364296
J201, J301, J401: HEATER; TerminalBlock_Phoenix_MKDS-1,5-2-5.08_1x02_P5.08mm_Horizont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
Q201, Q301, Q401: 2N7002; SOT-23; MPN 2N7002; LCSC C8545
Q202, Q302, Q402: AOD4184A; TO-252-2; MPN AOD4184A; LCSC C5370959
R201, R301, R401: 100k; R_0402_1005Metric
R202, R302, R402: 10k; R_0402_1005Metric
R203, R303, R403: 47; R_0402_1005Metric

Connections of its further copies:
/+3V3: R201.1, R301.1, R401.1; also elsewhere on the board
/GND: D201.2 (A), D202.2 (A), D301.2 (A), D302.2 (A), D401.2 (A), D402.2 (A), Q201.2 (S), Q202.3 (S), Q301.2 (S), Q302.3 (S), Q401.2 (S), Q402.3 (S); also elsewhere on the board
/HTR_PWM1: Q201.1 (G), R201.2; also elsewhere on the board
/HTR_PWM2: Q301.1 (G), R301.2; also elsewhere on the board
/HTR_PWM3: Q401.1 (G), R401.2; also elsewhere on the board
/Heater Ch1/GATE_DRIVE: Q202.1 (G), R203.2
/Heater Ch1/HEATER_LOW: D202.1 (K), J201.2, Q202.2 (D)
/Heater Ch2/GATE_DRIVE: Q302.1 (G), R303.2
/Heater Ch2/HEATER_LOW: D302.1 (K), J301.2, Q302.2 (D)
/Heater Ch3/GATE_DRIVE: Q402.1 (G), R403.2
/Heater Ch3/HEATER_LOW: D402.1 (K), J401.2, Q402.2 (D)
/VIN_HEAT: J201.1, J301.1, J401.1, R202.1, R302.1, R402.1; also elsewhere on the board
unnamed: D201.1 (K), Q201.3 (D), R202.2, R203.1
unnamed: D301.1 (K), Q301.3 (D), R302.2, R303.1
unnamed: D401.1 (K), Q401.3 (D), R402.2, R403.1

Notes on the sheet:
HEATER DRIVER | Inverting, zener-clamped gate drive
PWM HIGH / high impedance with 3V3 present: heater OFF. PWM LOW: heater ON. Jx01 pin 1 = measured VIN; pin 2 = switched return. Do not bond pin 2 to ground. Default-off depends on 3V3: loss of logic power can turn the heater ON. Use slow PWM; verify switching loss, current limit and thermal margins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

Board: 2 copper layers, 62 parts (0 on the bottom side), 32 nets, no tracks yet.

Other parts of the board:
H1, H2, H3, H4: M3; MountingHole_3.2mm_M3
