pulsarfab/pulsarfab/firmware/crunchdefender/src/main.c

#include "stm32f4xx_hal.h"

static void SystemClock_Config(void);
static void GPIO_Init(void);

int main(void)
{
    HAL_Init();
    SystemClock_Config();
    GPIO_Init();

    while (1) {
        HAL_Delay(500);
    }
}

/*
 * 8 MHz HSE -> PLL -> 168 MHz SYSCLK, 48 MHz USB clock.
 * PLLM=8, PLLN=336, PLLP=2, PLLQ=7  (HSE/M=1MHz, VCO=336MHz, SYSCLK=168MHz, USBCLK=48MHz)
 */
static void SystemClock_Config(void)
{
    RCC_OscInitTypeDef RCC_OscInitStruct = {0};
    RCC_ClkInitTypeDef RCC_ClkInitStruct = {0};

    __HAL_RCC_PWR_CLK_ENABLE();
    __HAL_PWR_VOLTAGESCALING_CONFIG(PWR_REGULATOR_VOLTAGE_SCALE1);

    RCC_OscInitStruct.OscillatorType = RCC_OSCILLATORTYPE_HSE;
    RCC_OscInitStruct.HSEState       = RCC_HSE_ON;
    RCC_OscInitStruct.PLL.PLLState   = RCC_PLL_ON;
    RCC_OscInitStruct.PLL.PLLSource  = RCC_PLLSOURCE_HSE;
    RCC_OscInitStruct.PLL.PLLM       = 8;
    RCC_OscInitStruct.PLL.PLLN       = 336;
    RCC_OscInitStruct.PLL.PLLP       = RCC_PLLP_DIV2;
    RCC_OscInitStruct.PLL.PLLQ       = 7;
    HAL_RCC_OscConfig(&RCC_OscInitStruct);

    RCC_ClkInitStruct.ClockType = RCC_CLOCKTYPE_HCLK | RCC_CLOCKTYPE_SYSCLK |
                                  RCC_CLOCKTYPE_PCLK1 | RCC_CLOCKTYPE_PCLK2;
    RCC_ClkInitStruct.SYSCLKSource   = RCC_SYSCLKSOURCE_PLLCLK;
    RCC_ClkInitStruct.AHBCLKDivider  = RCC_SYSCLK_DIV1;
    RCC_ClkInitStruct.APB1CLKDivider = RCC_HCLK_DIV4;
    RCC_ClkInitStruct.APB2CLKDivider = RCC_HCLK_DIV2;
    HAL_RCC_ClockConfig(&RCC_ClkInitStruct, FLASH_LATENCY_5);
}

static void GPIO_Init(void)
{
    __HAL_RCC_GPIOA_CLK_ENABLE();
    __HAL_RCC_GPIOB_CLK_ENABLE();
    __HAL_RCC_GPIOC_CLK_ENABLE();
}

void SysTick_Handler(void)
{
    HAL_IncTick();
}
