pulsarfab/pulsarfab/hardware/scripts/verify-floorplan.py

#!/usr/bin/env python3
"""Run placement DRC and schematic parity; report unfinished routing explicitly."""
import argparse
import json
import os
from pathlib import Path
import subprocess
import tempfile

parser = argparse.ArgumentParser(description=__doc__)
parser.add_argument("board", type=Path)
parser.add_argument("--require-routed", action="store_true",
                    help="Fail if any connections remain unrouted (required before fabrication export)")
args = parser.parse_args()
with tempfile.TemporaryDirectory(prefix="floorplan-drc-") as temp:
    report = Path(temp) / "drc.json"
    subprocess.run([os.environ.get("KICAD_CLI", "kicad-cli"), "pcb", "drc",
                    "--schematic-parity", "--severity-all", "--format", "json",
                    "-o", str(report), str(args.board)], check=True)
    result = json.loads(report.read_text())
    violations = result["violations"] + result["schematic_parity"]
    unconnected = len(result["unconnected_items"])
    for violation in violations:
        print(f"FAIL: {violation['type']}: {violation['description']}")
    print(f"Routing: {unconnected} unconnected items")
    if args.require_routed and unconnected:
        print("FAIL: fabrication export requires completed routing")
    if violations or (args.require_routed and unconnected):
        raise SystemExit(1)
    print("PASS: zero placement DRC violations and zero schematic parity issues")
    if unconnected:
        print("ROUTING INCOMPLETE: this check is not fabrication sign-off")
