pulsarfab/pulsarfab/(commit log)

2026-04-27 Initial repo scaffold: pulsardew (STM32 USB) + pulsardewpro (ESP32-S3 WiFi/Alpaca)
    Bootstrap PulsarFab hardware/firmware repo with:
    - pulsardew: STM32G0B1 USB dew heater controller (CMake, HAL, FreeRTOS scaffold)
    - pulsardewpro: ESP32-S3 WiFi dew heater with ASCOM Alpaca (ESP-IDF scaffold)
    - KiCad projects for both boards with shared symbol/footprint libraries
    - JLCPCB packaging script and hardware Makefile for gerber/BOM/CPL generation
    - CI/CD via GitHub Actions (STM32 ARM GCC + ESP-IDF builds)
    - STM32CubeG0 submodule for HAL drivers
    - Dual license: Apache 2.0 (firmware) + CERN-OHL-S v2 NC (hardware)
    [pulsardew.kicad_pcb, pulsardew.kicad_sch, pulsardewpro.kicad_pcb, pulsardewpro.kicad_sch]
2026-04-27 Add heater channel sub-sheet with zener-clamped gate drive topology
    Per-channel schematic for low-side NFET dew heater switching:
    - Q2 AOD4184A (40V/50A DPAK) power MOSFET, C5370959
    - Q1 2N7002 (SOT-23) level shifter, C8545
    - D1 BZT52C12 12V zener gate clamp (SOD-123), C19077410
    - D2 SMBJ20A TVS drain clamp (SMB), C364296
    - R1 100k pullup to +3V3 for fail-safe (heater OFF on MCU reset)
    - R2 10k pullup to VIN for gate drive
    - R3 47 ohm gate resistor to limit dV/dt
    Inverted logic: MCU PWM HIGH = heater OFF (safe default).
    Vgs clamped to 12V regardless of Vin (12-20V), 8V margin to Vgs(max).
    Drain transients clamped to 32.4V by TVS, 7.6V margin to Vds(max).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
    [heater_channel.kicad_sch]
2026-04-27 Add input current sense sub-sheet with INA226 + 2mΩ shunt
    High-side current monitor on input power rail:
    - U1 INA226AIDGSR (C49851) — 16-bit I2C current/power monitor, 0-36V Vcm
    - R1 2mΩ 2512 shunt (C459679) — 80mV at 40A, 3.2W max
    - C1 100nF bypass on VS
    I2C address 0x40 (A0=A1=GND), shares bus with SHT40 (0x44).
    Resolution: 2.5µV LSB / 2mΩ = 1.25mA (40× better than 50mA requirement).
    BOM cost: ~$0.63 (INA226 $0.53 + shunt $0.10).
    [current_sense.kicad_sch]
2026-04-27 Add top-level schematic with MCU, USB-C, and hierarchical sheets
    Top-level pulsardew.kicad_sch (A3) with:
    - U1 STM32G0B1KBU6 (UFQFPN-32) with bypass/reset caps
    - J1 USB-C 16P receptacle (GCT USB4105, C2927039) with 5.1k CC pulldowns
    - 4× heater_channel.kicad_sch hierarchical sheets (PWM on PA0-PA3)
    - 1× current_sense.kicad_sch hierarchical sheet (I2C on PB6/PB7)
    - Net labels: USB_D+/D- (PA11/PA12), I2C_SDA/SCL, SWDIO/SWCLK, HTR_PWM0-3
    Library additions:
    - pulsarfab:STM32G0B1KBU6 symbol (from tsumikoro, LCSC C5159549)
    - pulsarfab:UFQFPN-32 footprint (from tsumikoro)
    [pulsardew.kicad_sch]
2026-05-02 Add LDO, SHT40 sub-sheets, I2C pullups, power input with reverse polarity protection
    New sub-sheets:
    - ldo.kicad_sch: HT7333-A 30V→3.3V 250mA LDO (C347191) with 1µF 0402 in/out caps
    - sht40.kicad_sch: Sensirion SHT40-AD1B-R2 temp/humidity (C2909890) with 100nF bypass
    Top-level additions:
    - R20/R21 4.7k 0402 I2C pull-ups on SDA/SCL to +3V3
    - J2 DC barrel jack 2.0mm (C2880546) + J3 Phoenix COMBICON 2-pos (C480537)
    - D10 SS54 Schottky reverse polarity diode (C22452, 40V/5A SMA)
    - C10 470µF/25V electrolytic bulk cap after protection diode
    - LDO and SHT40 hierarchical sheet references
    - VIN_PROT net connecting protected input to LDO and heater channels
    Full hierarchy: 8 sheets (top + 4 heat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
    [ldo.kicad_sch, pulsardew.kicad_sch, sht40.kicad_sch]
2026-06-27 firmware: add crunchdefender (STM32F405) target and fix STM32 builds
    Brings the crunchdefender dual-USB mount limit guard into the build and
    repairs the STM32 firmware builds, which were red in CI.
    CI was failing because the pinned ST HAL drivers are newer than the
    hand-written config headers, plus the crunchdefender target referenced a
    vendor tree that was never registered:
    - Register STM32CubeF4 as a submodule. common/CMakeLists.txt already builds
    the F4 HAL gated on this tree existing, and the README/CI assumed it was
    present, but it was missing from .gitmodules so `submodules: recursive`
    never fetched it.
    - Build only the selected MCU family's HAL. The common library gated each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
    [crunchdefender.kicad_pcb, crunchdefender.kicad_sch]
2026-07-01 jlcpcb-package: fix BOM/CPL matching + support THT assembly
    Ported from ephemerkey after a JLCPCB order flagged mismatched parts:
    - BOM: export individual designators (--ref-range-delimiter "") — JLCPCB does not
    expand ranges like R18-R20, so grouped SMD parts were silently NOT placed.
    - CPL: --exclude-dnp (match the BOM) and drop mounting holes/fiducials (H*/MH/FID).
    - Include through-hole footprints so JST/THT connectors can be JLC-assembled
    (JLCPCB Economic handles THT). Opt specific parts out of BOM+CPL via an optional
    <name>-handsolder.txt (e.g. bare pin headers you hand-solder).
2026-07-02 jlcpcb-package: drop exclude_from_bom footprints from the CPL
    Footprints flagged (attr ... exclude_from_bom) in the PCB — solder jumpers,
    Tag-Connect programming pads, test points — carry no LCSC part number, so
    JLCPCB can't assemble them. They were already absent from the BOM but still
    emitted to the CPL, which makes JLCPCB reject the order with '<ref>
    designators don't exist in the BOM file'. Parse the PCB's footprint (attr)
    blocks and exclude those refs from the CPL too, alongside the existing
    mounting-hole/fiducial and hand-solder drops.
    Ported from the confirmed-good fix in tsumikoro.
2026-07-06 hardware: add shared kschgen/check/render toolchain + Makefile targets
    Bring in the shared schematic toolchain used across the sibling repos:
    kschgen.py (data-manifest schematic engine), kicad-sch-check.py, and
    kicad-sch-render.sh, plus scripts/README.md. Wire up gen-/check-/render-
    <project> Makefile targets matching the sibling convention.
2026-10-03 hardware: wire and verify the PulsarDew schematic hierarchy
    [controller.kicad_sch, current_sense.kicad_sch, heater_channel.kicad_sch, ldo.kicad_sch, pulsardew.kicad_sch, sht40.kicad_sch]
2026-10-03 hardware: floorplan PulsarDew and check schematic parity
    [controller.kicad_sch, pulsardew.kicad_pcb]
2026-10-03 Match PulsarDew connector sourcing to reviewed footprints
    [controller.kicad_sch, pulsardew.kicad_pcb, pulsardew.kicad_sch]
2026-10-03 Add wired PulsarDew Hub schematic and four-layer PCB floorplan
    [controller.kicad_sch, dc_outlet.kicad_sch, heaters.kicad_sch, jlcpcb_bom.csv, parts-review.csv, power_input.kicad_sch, pulsardewhub.kicad_pcb, pulsardewhub.kicad_sch]
2026-10-03 Use TPS259827 high-side switches for 12–18 V DC outlets
    [controller.kicad_sch, dc_outlet.kicad_sch, heaters.kicad_sch, jlcpcb_bom.csv, parts-review.csv, power_input.kicad_sch, pulsardewhub.kicad_pcb, pulsardewhub.kicad_sch]
2026-10-03 Name expanded power and USB product PulsarPower in READMEs
2026-10-04 Use economical through-hole USB-A sockets for PulsarPower
    [jlcpcb_bom.csv, parts-review.csv, pulsardewhub.kicad_pcb, usb_port.kicad_sch]
2026-10-04 Reduce PulsarPower power-path cost while retaining current monitoring
    [controller.kicad_sch, dc_outlet.kicad_sch, dc_protection.kicad_sch, heaters.kicad_sch, jlcpcb_bom.csv, parts-review.csv, power_input.kicad_sch, pulsardewhub.kicad_pcb]
2026-10-04 Document owned XKB barrel socket candidate and drawing conflict
2026-10-04 Use stocked HRO USB-C sockets on PulsarPower and PulsarDew
    [controller.kicad_sch, jlcpcb_bom.csv, parts-review.csv, pulsardew.kicad_pcb, pulsardewhub.kicad_pcb, usb_hub.kicad_sch]
2026-10-04 Use owned XKB barrel sockets and evaluate LMR51610 commonality
    [dc_outlet.kicad_sch, jlcpcb_bom.csv, parts-review.csv, power_input.kicad_sch, pulsardew.kicad_pcb, pulsardew.kicad_sch, pulsardewhub.kicad_pcb, supplies.kicad_sch]
2026-10-04 Use owned LMR51610 for PulsarPower 3.3 V logic supply
    [jlcpcb_bom.csv, parts-review.csv, pulsardewhub.kicad_pcb, supplies.kicad_sch]
